phoenix-pnp/ThunderScope/Firmware/Artix7_PCIe/dso_top/dso_top.runs/design_1_xdma_0_0_synth_1/.vivado.begin.rst

<?xml version="1.0"?>
<ProcessHandle Version="1" Minor="0">
    <Process Command="vivado.bat" Owner="Aleksa" Host="DESKTOP-J72MK93" Pid="1696" HostCore="16" HostMemory="034270351360">
    </Process>
</ProcessHandle>
