phoenix-pnp/ThunderScope/Firmware/Artix7_PCIe/dso_top/dso_top.runs/impl_1/.init_design.begin.rst

<?xml version="1.0"?>
<ProcessHandle Version="1" Minor="0">
    <Process Command=".planAhead." Owner="Aleksa" Host="DESKTOP-J72MK93" Pid="4868">
    </Process>
</ProcessHandle>
