phoenix-pnp/ThunderScope/Hardware/The Next Generation/BUF802_Eval/BUF802_Eval.pdf

# +4V8 R¹²⁰

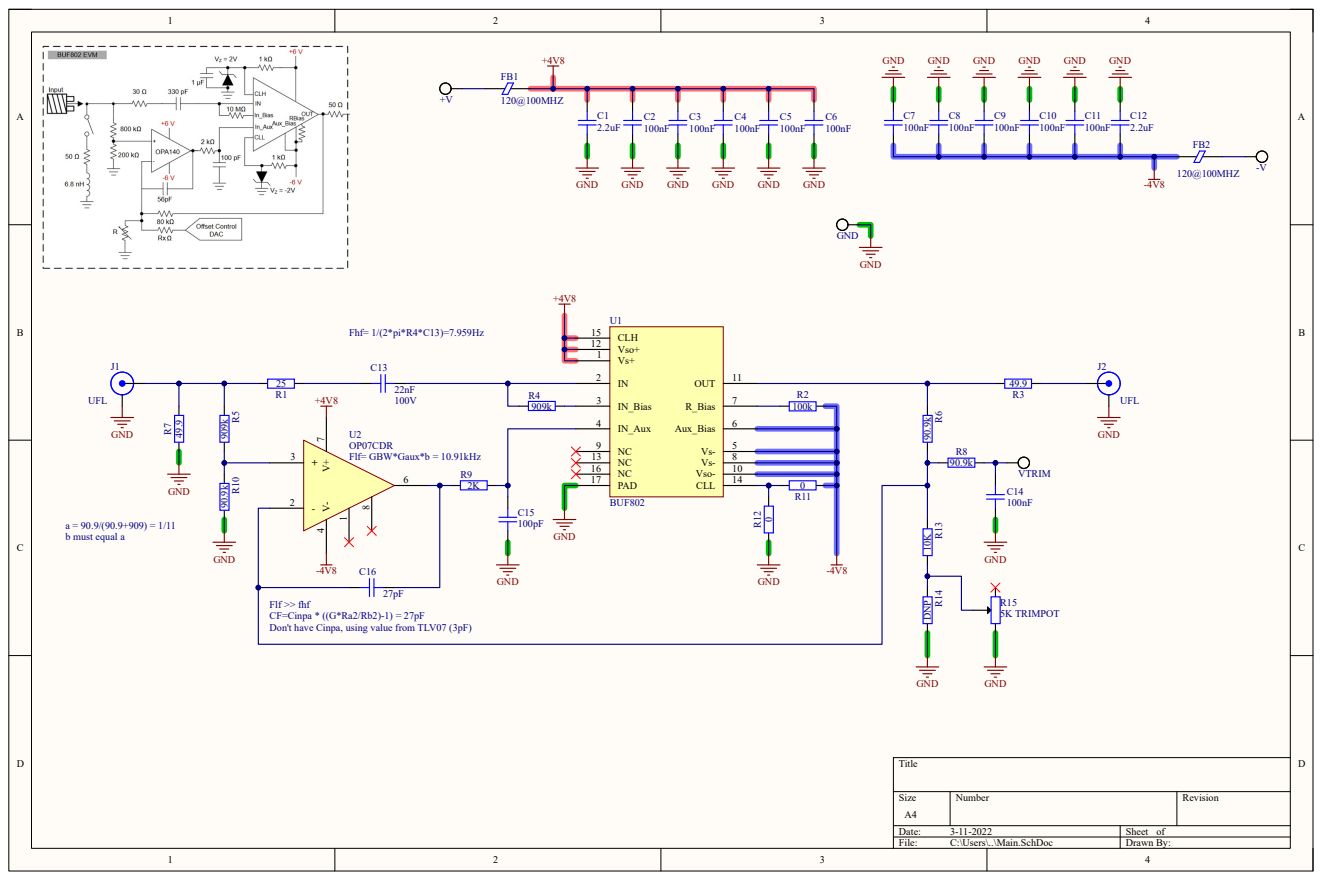
[picture p9: page 1]

Flf >> fhf
CF=Cinpa * ((G*Ra2/Rb2)-1) = 27pF
Don't have Cinpa, using value from TLV07 (3pF)
