phoenix-pnp/ThunderScope/(list of files, drawings)

Other design files:
Hardware/The Next Generation/BUF802_Eval/BUF802_Eval.PcbDoc
Hardware/The Next Generation/BUF802_Eval/BUF802_Eval.PrjPcb
Hardware/The Next Generation/BUF802_Eval/Main.SchDoc
Hardware/The Next Generation/Thunderscope_Rev1/ADC.SchDoc
Hardware/The Next Generation/Thunderscope_Rev1/Buffer.SchDoc
Hardware/The Next Generation/Thunderscope_Rev1/FE.SchDoc
Hardware/The Next Generation/Thunderscope_Rev1/FE_Channel.SchDoc
Hardware/The Next Generation/Thunderscope_Rev1/FPGA.SchDoc
Hardware/The Next Generation/Thunderscope_Rev1/Input.SchDoc
Hardware/The Next Generation/Thunderscope_Rev1/M2_KEY_M.SchDoc
Hardware/The Next Generation/Thunderscope_Rev1/Main.SchDoc
Hardware/The Next Generation/Thunderscope_Rev1/Managed/Sheets/FC1D1A13-1D8D-4C53-8666-9A4B6D32A5EC/CON_PCIe_X4.SchDoc
Hardware/The Next Generation/Thunderscope_Rev1/PGA.SchDoc
Hardware/The Next Generation/Thunderscope_Rev1/PLL.SchDoc
Hardware/The Next Generation/Thunderscope_Rev1/Thunderscope_Rev1.PrjPCB
