phoenix-pnp/ThunderScope/Software/waveview/scope_link/src/main.cpp

//
//  main.cpp
//
//  Created by Daniel Vasile on 2019-07-26.
//  Copyright © 2019 EEVengers. All rights reserved.
//

#include "EVTester.hpp"
#include "logger.hpp"
#include "controller.hpp"

#include "../lib/xptools/Socket.h"

// Forward Declarations
bool parseCli (std::string line);
void runCli();

// Variables
boost::lockfree::queue<buffer*, boost::lockfree::fixed_sized<false>> dataQueue_1{1000};
controller* controllerThread = NULL;


void parseCommandLineArgs(int argc, char** args) {
    if(argc > 1) {
        if(std::string(args[1]) == "--TestSinc" || std::string(args[1]) == "-s") {
            INFO << "Main:parseCommandLineArgs() - Testing Sinc Interpolation";
            TestSincInterpolation();
        } else if(std::string(args[1]) == "--testTrigger") {
            INFO << "Main:parseCommandLineArgs() - Testing Trigger Throughput";
            testTriggerThroughput();
        } else if(std::string(args[1]) == "-gl" || std::string(args[1]) == "--glscopeclient") {
			INFO << "Running tcp connection";

        } else if(std::string(args[1]) == "--PCIE") {
            INFO << "Running PCIE test";

            runPCIeTest();
        } else if(std::string(args[1]) == "--controller" || std::string(args[1]) == "-c") {
            parseCli("controller");
            runCli();
        } else {
            ERROR << "Invalid arguments.";
        }
    } else {
        ERROR << "Invalid arguments.";
    }

    return;
}

bool parseCli (std::string line)
{
    if (line.rfind("test", 0) == 0) {
        INFO << "Test";

    } else if ("template" == line.substr(0, line.find(' '))) {
        INFO << "Template";

//        // Useful for accepting arguments from a command
//        std::string nextArgument = line.substr(line.find(' ', line.find(' ') + 1),
//                                                   line.find(' ') + 1);

        // Get the reset of the line after the first argument
        std::string nextLine = line.substr(line.find(' ') + 1, line.length());
        parseCli(nextLine);

    } else if (line == "getch") {
        if (controllerThread != NULL ) {
            INFO << "Number of channels: " << (int)controllerThread->getCh();
        }

    } else if ("setch" == line.substr(0, line.find(' '))) {
        INFO << "setting channel mode";

        // Useful for accepting arguments from a command
        std::string nextArgument = line.substr(line.find(' ') + 1, line.length());
        if (nextArgument != "setch") {
            if (nextArgument == "1") {
                controllerThread->setCh(1);
            } else if (nextArgument == "2") {
                controllerThread->setCh(2);
            } else if (nextArgument == "4") {
                controllerThread->setCh(4);
            } else {
                ERROR << "Not a channel mode";
            }
        }

    } else if (line == "gettrig") {
        if (controllerThread != NULL ) {
            INFO << "Trigger channel: " << (int)controllerThread->getTriggerCh();
        }

    } else if ("settrig" == line.substr(0, line.find(' '))) {
        INFO << "setting trigger channel";

        // Useful for accepting arguments from a command
        std::string nextArgument = line.substr(line.find(' ') + 1, line.length());
        if (nextArgument != "settrig") {
            if (nextArgument == "1") {
                controllerThread->setTriggerCh(1);
            } else if (nextArgument == "2") {
                controllerThread->setTriggerCh(2);
            } else if (nextArgument == "3") {
                controllerThread->setTriggerCh(3);
            } else if (nextArgument == "4") {
                controllerThread->setTriggerCh(4);
            } else {
                ERROR << "Not a trigger channel";
            }
        }

    } else if (line == "getwin") {
        if (controllerThread != NULL ) {
            INFO << "Window Size: " << (int)controllerThread->getWindowSize();
        }

    } else if ("setwin" == line.substr(0, line.find(' '))) {
        if (controllerThread != NULL ) {
            INFO << "setting window size";

            // Useful for accepting arguments from a command
            std::string nextArgument = line.substr(line.find(' ') + 1, line.length());
            if (nextArgument != "setwin") {
                int32_t newWindowSize = stoi(nextArgument);
                controllerThread->setWindowSize(newWindowSize);
                INFO << "new window size: " << newWindowSize;
            }
        } else {
            ERROR << "No controller";
        }

    } else if (line == "getlevel") {
        if (controllerThread != NULL ) {
            INFO << "trigger level: " << (int)controllerThread->getLevel();
        }

    } else if ("setlevel" == line.substr(0, line.find(' '))) {
        if (controllerThread != NULL ) {
            INFO << "setting trigger level";

            // Useful for accepting arguments from a command
            std::string nextArgument = line.substr(line.find(' ') + 1, line.length());
            if (nextArgument != "setlevel") {
                int32_t newLevel = stoi(nextArgument);
                controllerThread->setLevel(newLevel);
                INFO << "new trigger level: " << newLevel;
            }
        } else {
            ERROR << "No controller";
        }
    } else if ("getmax" == line.substr(0, line.find(' '))) {
        INFO << "getting max value";

        int8_t maxValue = 0;
        uint64_t maxPos = 0;

        // Useful for accepting arguments from a command
        std::string nextArgument = line.substr(line.find(' ') + 1, line.length());
        if (nextArgument != "getmax") {
            if (nextArgument == "1") {
                controllerThread->getMax(1, &maxValue, &maxPos);
                INFO << "Max Value: " << (int)maxValue << " at position: " << maxPos;
            } else if (nextArgument == "2") {
                controllerThread->getMax(2, &maxValue, &maxPos);
                INFO << "Max Value: " << maxValue << " at position: " << maxPos;
            } else if (nextArgument == "3") {
                controllerThread->getMax(3, &maxValue, &maxPos);
                INFO << "Max Value: " << maxValue << " at position: " << maxPos;
            } else if (nextArgument == "4") {
                controllerThread->getMax(3, &maxValue, &maxPos);
                INFO << "Max Value: " << maxValue << " at position: " << maxPos;
            } else {
                ERROR << "Not a trigger channel";
            }
        } else {
            controllerThread->getMax(1, &maxValue, &maxPos);
            INFO << "Max Value: " << (int)maxValue << " at position: " << maxPos;
        }


    } else if ("getmin" == line.substr(0, line.find(' '))) {
        INFO << "getting min value";

        // Useful for accepting arguments from a command
        std::string nextArgument = line.substr(line.find(' ') + 1, line.length());
        if (nextArgument != "getmin") {
            int8_t minValue = 0;
            uint64_t minPos = 0;
            if (nextArgument == "1") {
                controllerThread->getMin(1, &minValue, &minPos);
                INFO << "Min Value: " << (int)minValue << " at position: " << minPos;
            } else if (nextArgument == "2") {
                controllerThread->getMin(2, &minValue, &minPos);
                INFO << "Min Value: " << minValue << " at position: " << minPos;
            } else if (nextArgument == "3") {
                controllerThread->getMin(3, &minValue, &minPos);
                INFO << "Min Value: " << minValue << " at position: " << minPos;
            } else if (nextArgument == "4") {
                controllerThread->getMin(3, &minValue, &minPos);
                INFO << "Min Value: " << minValue << " at position: " << minPos;
            } else {
                ERROR << "Not a trigger channel";
            }
        }

    } else if (line == "controller") {
        if (controllerThread == NULL ) {
            controllerThread = new controller(&dataQueue_1);
        }

    } else if (line == "pause") {
        if (controllerThread != NULL ) {
            controllerThread->controllerPause();
        }

    } else if (line == "unpause") {
        if (controllerThread != NULL ) {
            controllerThread->controllerUnPause();
        }

    } else if (line == "reprocess") {
        if (controllerThread != NULL ) {
            controllerThread->reProcess();
        }

    } else if (line == "flush") {
        if (controllerThread != NULL ) {
            controllerThread->controllerFlush();
        }

    } else if (line == "getedgetype") {
        if (controllerThread != NULL ) {
            if (controllerThread->getEdgeType() == true) {
                INFO << "Rising edge triggering";
            } else {
                INFO << "Falling edge triggering";
            }
        }

    } else if (line == "setrising") {
        if (controllerThread != NULL ) {
            controllerThread->setRising();
        }

    } else if (line == "setfalling") {
        if (controllerThread != NULL ) {
            controllerThread->setFalling();
        }

    } else if (line == "getdata") {
        if (controllerThread != NULL ) {
            controllerThread->getData();
            INFO << "you need to load in some data to get data";
        }

    } else if (line == "getper") {
        if (controllerThread != NULL ) {
            INFO << "Persistance Size: " << (int)controllerThread->getPerSize();
        }

    } else if ("setper" == line.substr(0, line.find(' '))) {
        if (controllerThread != NULL ) {
            INFO << "setting persistance size";

            // Useful for accepting arguments from a command
            std::string nextArgument = line.substr(line.find(' ') + 1, line.length());
            if (nextArgument != "setper") {
                int32_t newPer = stoi(nextArgument);
                controllerThread->setPerSize(newPer);
                INFO << "new persistance size: " << newPer;
            }
        } else {
            ERROR << "No controller";
        }

    } else if ("setmath1" == line.substr(0, line.find(' '))) {
        if (controllerThread != NULL ) {
            INFO << "setting math channel 1";

            // Useful for accepting arguments from a command
            std::string nextArgument = line.substr(line.find(' ') + 1, line.length());
            if (nextArgument != "setmath1") {
                int32_t newMathCh = stoi(nextArgument);
                controllerThread->setMathCh_1(newMathCh);
                INFO << "new math channel 1: " << newMathCh;
            }
        } else {
            ERROR << "No controller";
        }

    } else if ("setmath2" == line.substr(0, line.find(' '))) {
        if (controllerThread != NULL ) {
            INFO << "setting math channel 2";

            // Useful for accepting arguments from a command
            std::string nextArgument = line.substr(line.find(' ') + 1, line.length());
            if (nextArgument != "setmath2") {
                int32_t newMathCh = stoi(nextArgument);
                controllerThread->setMathCh_2(newMathCh);
                INFO << "new math channel 2: " << newMathCh;
            }
        } else {
            ERROR << "No controller";
        }

    } else if ("setmathsign" == line.substr(0, line.find(' '))) {
        if (controllerThread != NULL ) {
            INFO << "setting math channel 2";

            // Useful for accepting arguments from a command
            std::string nextArgument = line.substr(line.find(' ') + 1, line.length());
            if (nextArgument == "add") {
                controllerThread->setMathSign(true);
                INFO << "Math sign addition";
            } else if (nextArgument == "sub") {
                controllerThread->setMathSign(false);
                INFO << "Math sign subtraction";
            }
        } else {
            ERROR << "No controller";
        }

    } else if ("datafile" == line.substr(0, line.find(' '))) {
        INFO << "Adding data from file to the pipeline";

        std::string nextArgument = line.substr(line.find(' ') + 1, line.length());
        if (nextArgument != "data") {

            nextArgument = "./test/" + nextArgument;
            char* filename = (char*)malloc(nextArgument.size() + 1);
            std::strcpy(filename, nextArgument.c_str());
            inputFile = filename;
            loadFromFile(filename, &dataQueue_1);
            free(filename);
        } else {
            ERROR << "must provide file";
        }

    } else if ("data" == line.substr(0, line.find(' '))) {
        INFO << "Adding data to the pipeline";

        char filename[] = "./test/test1.csv";
        inputFile = filename;
        loadFromFile(filename, &dataQueue_1);

    } else if (line == "delete" || line == "exit") {
        if (controllerThread != NULL ) {
            delete controllerThread;
            controllerThread = NULL;
        }

        if (line == "exit") {
            return false;
        }
    } else {
        ERROR << "Invalid Command";
        ERROR << "Commands are:";
        ERROR << "controller";
        ERROR << "unpause";
        ERROR << "data";
        ERROR << "datafile <csv file in scope_link/test/>";
        ERROR << "getch";
        ERROR << "setch <# of channels: 1, 2 or 4>";
        ERROR << "gettrig";
        ERROR << "settrig <channel to trig on: 1, 2, 3 or 4>";
        ERROR << "getedgetype";
        ERROR << "setrising";
        ERROR << "setfalling";
        ERROR << "getlevel";
        ERROR << "setlevel <voltage level>";
        ERROR << "getwin";
        ERROR << "setwin";
        ERROR << "flush";
        ERROR << "setmath1";
        ERROR << "setmath2";
        ERROR << "setmathsign";
        ERROR << "getdata";
        ERROR << "exit";
    }
    return true;
}

void runCli() {

    bool parseThings = true;
    while(parseThings) {
        INFO << "Input a command\n>";
        std::string line;
        std::getline(std::cin, line);

        parseThings = parseCli(line);
    }

    if(controllerThread != NULL)
        delete controllerThread;
}


std::string g_model;
std::string g_serial;
std::string g_fwver;

//PicoScopeType g_pico_type;
int16_t g_hScope = 0;
size_t g_numChannels = 0;

extern Socket g_scpiSocket;
extern Socket g_dataSocket;

uint16_t scpi_port = 5025;
uint16_t waveform_port = 5026;

int main(int argc, char** args)
{
    INFO << "Program Started";

	//Configure the data plane socket
	g_dataSocket.Bind(waveform_port);
	g_dataSocket.Listen();

	//Launch the control plane socket server
	g_scpiSocket.Bind(scpi_port);
	g_scpiSocket.Listen();
//	ScpiServerThread();

    if (argc > 1) {
        parseCommandLineArgs(argc, args);
    } else {
        INFO << "Running in CLI mode";
        runCli();
    }

    return 0;
}
