phoenix-pnp/ThunderScope/Firmware/Artix7_PCIe/dso_top/dso_top.runs/synth_1/.Xil/dso_top_propImpl.xdc

set_property SRC_FILE_INFO {cfile:c:/Users/Aleksa/Documents/FPGA_Dev/Artix7_PCIe/dso_top/dso_top.srcs/sources_1/bd/design_1/ip/design_1_xdma_0_0/design_1_xdma_0_0/design_1_xdma_0_0_in_context.xdc rfile:../../../dso_top.srcs/sources_1/bd/design_1/ip/design_1_xdma_0_0/design_1_xdma_0_0/design_1_xdma_0_0_in_context.xdc id:1 order:EARLY scoped_inst:design_1_i/xdma_0} [current_design]
set_property SRC_FILE_INFO {cfile:c:/Users/Aleksa/Documents/FPGA_Dev/Artix7_PCIe/dso_top/dso_top.srcs/sources_1/bd/design_1/ip/design_1_util_ds_buf_0_0/design_1_util_ds_buf_0_0/design_1_util_ds_buf_0_0_in_context.xdc rfile:../../../dso_top.srcs/sources_1/bd/design_1/ip/design_1_util_ds_buf_0_0/design_1_util_ds_buf_0_0/design_1_util_ds_buf_0_0_in_context.xdc id:2 order:EARLY scoped_inst:design_1_i/util_ds_buf_0} [current_design]
set_property SRC_FILE_INFO {cfile:c:/Users/Aleksa/Documents/FPGA_Dev/Artix7_PCIe/dso_top/dso_top.srcs/sources_1/bd/design_1/ip/design_1_axi_bram_ctrl_0_1/design_1_axi_bram_ctrl_0_1/design_1_axi_bram_ctrl_0_1_in_context.xdc rfile:../../../dso_top.srcs/sources_1/bd/design_1/ip/design_1_axi_bram_ctrl_0_1/design_1_axi_bram_ctrl_0_1/design_1_axi_bram_ctrl_0_1_in_context.xdc id:3 order:EARLY scoped_inst:design_1_i/axi_bram_ctrl_0} [current_design]
set_property SRC_FILE_INFO {cfile:C:/Users/Aleksa/Documents/FPGA_Dev/Artix7_PCIe/dso_top/dso_top.runs/synth_1/.Xil/Vivado-7916-DESKTOP-J72MK93/clk_wiz_0/clk_wiz_0/clk_wiz_0_in_context.xdc rfile:Vivado-7916-DESKTOP-J72MK93/clk_wiz_0/clk_wiz_0/clk_wiz_0_in_context.xdc id:4 order:EARLY scoped_inst:serdes/serdes_clocking} [current_design]
set_property SRC_FILE_INFO {cfile:C:/Users/Aleksa/Documents/FPGA_Dev/Artix7_PCIe/dso_top/dso_top.srcs/constrs_1/imports/new/module_io.xdc rfile:../../../dso_top.srcs/constrs_1/imports/new/module_io.xdc id:5} [current_design]
set_property SRC_FILE_INFO {cfile:C:/Users/Aleksa/Documents/FPGA_Dev/Artix7_PCIe/dso_top/dso_top.srcs/constrs_1/new/timing.xdc rfile:../../../dso_top.srcs/constrs_1/new/timing.xdc id:6} [current_design]
current_instance design_1_i/xdma_0
set_property src_info {type:SCOPED_XDC file:1 line:2 export:INPUT save:INPUT read:READ} [current_design]
create_clock -period 8.000 [get_ports {}]
current_instance
current_instance design_1_i/util_ds_buf_0
set_property src_info {type:SCOPED_XDC file:2 line:2 export:INPUT save:INPUT read:READ} [current_design]
create_clock -period 10.000 [get_ports {}]
set_property src_info {type:SCOPED_XDC file:2 line:4 export:INPUT save:INPUT read:READ} [current_design]
create_generated_clock -source [get_ports IBUF_DS_P[0]] -edges {1 2 3} -edge_shift {0.000 5.000 10.000} [get_ports {}]
current_instance
current_instance design_1_i/axi_bram_ctrl_0
set_property src_info {type:SCOPED_XDC file:3 line:2 export:INPUT save:INPUT read:READ} [current_design]
create_clock -period 8.000 [get_ports {}]
current_instance
current_instance serdes/serdes_clocking
set_property src_info {type:SCOPED_XDC file:4 line:1 export:INPUT save:INPUT read:READ} [current_design]
create_clock -period 2.000 [get_ports -no_traverse {}]
set_property src_info {type:SCOPED_XDC file:4 line:4 export:INPUT save:INPUT read:READ} [current_design]
create_generated_clock -source [get_ports clk_in1_p] -edges {1 2 3} -edge_shift {0.500 0.500 0.500} [get_ports {}]
set_property src_info {type:SCOPED_XDC file:4 line:6 export:INPUT save:INPUT read:READ} [current_design]
create_generated_clock -source [get_ports clk_in1_p] -edges {1 2 3} -edge_shift {1.250 2.750 4.250} [get_ports {}]
set_property src_info {type:SCOPED_XDC file:4 line:8 export:INPUT save:INPUT read:READ} [current_design]
create_generated_clock -source [get_ports clk_in1_p] -edges {1 2 3} -edge_shift {2.000 5.000 8.000} [get_ports {}]
current_instance
set_property src_info {type:XDC file:5 line:1 export:INPUT save:INPUT read:READ} [current_design]
set_property -dict {PACKAGE_PIN Y22 IOSTANDARD LVCMOS33} [get_ports {led[0]}]
set_property src_info {type:XDC file:5 line:2 export:INPUT save:INPUT read:READ} [current_design]
set_property -dict {PACKAGE_PIN T21 IOSTANDARD LVCMOS33} [get_ports {led[1]}]
set_property src_info {type:XDC file:5 line:3 export:INPUT save:INPUT read:READ} [current_design]
set_property -dict {PACKAGE_PIN U21 IOSTANDARD LVCMOS33} [get_ports {led[2]}]
set_property src_info {type:XDC file:5 line:4 export:INPUT save:INPUT read:READ} [current_design]
set_property -dict {PACKAGE_PIN R17 IOSTANDARD LVCMOS33} [get_ports {led[3]}]
set_property src_info {type:XDC file:5 line:6 export:INPUT save:INPUT read:READ} [current_design]
set_property -dict {PACKAGE_PIN K22 IOSTANDARD LVCMOS33} [get_ports pga_sdio]
set_property src_info {type:XDC file:5 line:7 export:INPUT save:INPUT read:READ} [current_design]
set_property -dict {PACKAGE_PIN K21 IOSTANDARD LVCMOS33} [get_ports pga_sclk]
set_property src_info {type:XDC file:5 line:9 export:INPUT save:INPUT read:READ} [current_design]
set_property -dict {PACKAGE_PIN G20 IOSTANDARD LVCMOS33} [get_ports {pga_cs[0]}]
set_property src_info {type:XDC file:5 line:10 export:INPUT save:INPUT read:READ} [current_design]
set_property -dict {PACKAGE_PIN K18 IOSTANDARD LVCMOS33} [get_ports {pga_cs[1]}]
set_property src_info {type:XDC file:5 line:11 export:INPUT save:INPUT read:READ} [current_design]
set_property -dict {PACKAGE_PIN L20 IOSTANDARD LVCMOS33} [get_ports {pga_cs[2]}]
set_property src_info {type:XDC file:5 line:12 export:INPUT save:INPUT read:READ} [current_design]
set_property -dict {PACKAGE_PIN L21 IOSTANDARD LVCMOS33} [get_ports {pga_cs[3]}]
set_property src_info {type:XDC file:5 line:14 export:INPUT save:INPUT read:READ} [current_design]
set_property -dict {PACKAGE_PIN H20 IOSTANDARD LVCMOS33} [get_ports {atten[0]}]
set_property src_info {type:XDC file:5 line:15 export:INPUT save:INPUT read:READ} [current_design]
set_property -dict {PACKAGE_PIN K19 IOSTANDARD LVCMOS33} [get_ports {atten[1]}]
set_property src_info {type:XDC file:5 line:16 export:INPUT save:INPUT read:READ} [current_design]
set_property -dict {PACKAGE_PIN J19 IOSTANDARD LVCMOS33} [get_ports {atten[2]}]
set_property src_info {type:XDC file:5 line:17 export:INPUT save:INPUT read:READ} [current_design]
set_property -dict {PACKAGE_PIN M21 IOSTANDARD LVCMOS33} [get_ports {atten[3]}]
set_property src_info {type:XDC file:5 line:19 export:INPUT save:INPUT read:READ} [current_design]
set_property -dict {PACKAGE_PIN H22 IOSTANDARD LVCMOS33} [get_ports {dc_cpl[0]}]
set_property src_info {type:XDC file:5 line:20 export:INPUT save:INPUT read:READ} [current_design]
set_property -dict {PACKAGE_PIN L19 IOSTANDARD LVCMOS33} [get_ports {dc_cpl[1]}]
set_property src_info {type:XDC file:5 line:21 export:INPUT save:INPUT read:READ} [current_design]
set_property -dict {PACKAGE_PIN H19 IOSTANDARD LVCMOS33} [get_ports {dc_cpl[2]}]
set_property src_info {type:XDC file:5 line:22 export:INPUT save:INPUT read:READ} [current_design]
set_property -dict {PACKAGE_PIN N20 IOSTANDARD LVCMOS33} [get_ports {dc_cpl[3]}]
set_property src_info {type:XDC file:5 line:24 export:INPUT save:INPUT read:READ} [current_design]
set_property -dict {PACKAGE_PIN J22 IOSTANDARD LVCMOS33} [get_ports probe_comp]
set_property src_info {type:XDC file:5 line:26 export:INPUT save:INPUT read:READ} [current_design]
set_property -dict {PACKAGE_PIN L16 IOSTANDARD LVCMOS33} [get_ports adc_sclk]
set_property src_info {type:XDC file:5 line:27 export:INPUT save:INPUT read:READ} [current_design]
set_property -dict {PACKAGE_PIN K16 IOSTANDARD LVCMOS33} [get_ports adc_sdata]
set_property src_info {type:XDC file:5 line:29 export:INPUT save:INPUT read:READ} [current_design]
set_property -dict {PACKAGE_PIN K13 IOSTANDARD LVCMOS33} [get_ports fe_pg]
set_property src_info {type:XDC file:5 line:31 export:INPUT save:INPUT read:READ} [current_design]
set_property -dict {PACKAGE_PIN K14 IOSTANDARD LVCMOS33} [get_ports osc_oe]
set_property src_info {type:XDC file:5 line:33 export:INPUT save:INPUT read:READ} [current_design]
set_property -dict {PACKAGE_PIN J20 IOSTANDARD LVCMOS33} [get_ports acq_en]
set_property src_info {type:XDC file:5 line:35 export:INPUT save:INPUT read:READ} [current_design]
set_property -dict {PACKAGE_PIN J21 IOSTANDARD LVCMOS33} [get_ports fe_en]
set_property src_info {type:XDC file:5 line:37 export:INPUT save:INPUT read:READ} [current_design]
set_property -dict {PACKAGE_PIN J14 IOSTANDARD LVCMOS33} [get_ports i2c_sda]
set_property src_info {type:XDC file:5 line:38 export:INPUT save:INPUT read:READ} [current_design]
set_property -dict {PACKAGE_PIN H14 IOSTANDARD LVCMOS33} [get_ports i2c_scl]
set_property src_info {type:XDC file:5 line:40 export:INPUT save:INPUT read:READ} [current_design]
set_property -dict {PACKAGE_PIN N19 IOSTANDARD LVCMOS33} [get_ports adc_pd]
set_property src_info {type:XDC file:5 line:42 export:INPUT save:INPUT read:READ} [current_design]
set_property -dict {PACKAGE_PIN N18 IOSTANDARD LVCMOS33} [get_ports adc_rstn]
set_property src_info {type:XDC file:5 line:44 export:INPUT save:INPUT read:READ} [current_design]
set_property -dict {PACKAGE_PIN M18 IOSTANDARD LVCMOS33} [get_ports adc_cs]
set_property src_info {type:XDC file:5 line:46 export:INPUT save:INPUT read:READ} [current_design]
set_property -dict {PACKAGE_PIN L18 IOSTANDARD LVCMOS33} [get_ports adc_pg]
set_property src_info {type:XDC file:5 line:52 export:INPUT save:INPUT read:READ} [current_design]
set_property -dict {PACKAGE_PIN C18 IOSTANDARD LVDS_25 DIFF_TERM 1} [get_ports adc_lclk_p]
set_property src_info {type:XDC file:5 line:53 export:INPUT save:INPUT read:READ} [current_design]
set_property -dict {PACKAGE_PIN C19 IOSTANDARD LVDS_25 DIFF_TERM 1} [get_ports adc_lclk_n]
set_property src_info {type:XDC file:5 line:55 export:INPUT save:INPUT read:READ} [current_design]
set_property -dict {PACKAGE_PIN D17 IOSTANDARD LVDS_25 DIFF_TERM 1} [get_ports adc_fclk_p]
set_property src_info {type:XDC file:5 line:56 export:INPUT save:INPUT read:READ} [current_design]
set_property -dict {PACKAGE_PIN C17 IOSTANDARD LVDS_25 DIFF_TERM 1} [get_ports adc_fclk_n]
set_property src_info {type:XDC file:5 line:59 export:INPUT save:INPUT read:READ} [current_design]
set_property -dict {PACKAGE_PIN A15 IOSTANDARD LVDS_25 DIFF_TERM 1} [get_ports {adc_data_p[0]}]
set_property src_info {type:XDC file:5 line:60 export:INPUT save:INPUT read:READ} [current_design]
set_property -dict {PACKAGE_PIN A16 IOSTANDARD LVDS_25 DIFF_TERM 1} [get_ports {adc_data_n[0]}]
set_property src_info {type:XDC file:5 line:63 export:INPUT save:INPUT read:READ} [current_design]
set_property -dict {PACKAGE_PIN B15 IOSTANDARD LVDS_25 DIFF_TERM 1} [get_ports {adc_data_p[1]}]
set_property src_info {type:XDC file:5 line:64 export:INPUT save:INPUT read:READ} [current_design]
set_property -dict {PACKAGE_PIN B16 IOSTANDARD LVDS_25 DIFF_TERM 1} [get_ports {adc_data_n[1]}]
set_property src_info {type:XDC file:5 line:67 export:INPUT save:INPUT read:READ} [current_design]
set_property -dict {PACKAGE_PIN B17 IOSTANDARD LVDS_25 DIFF_TERM 1} [get_ports {adc_data_p[2]}]
set_property src_info {type:XDC file:5 line:68 export:INPUT save:INPUT read:READ} [current_design]
set_property -dict {PACKAGE_PIN B18 IOSTANDARD LVDS_25 DIFF_TERM 1} [get_ports {adc_data_n[2]}]
set_property src_info {type:XDC file:5 line:71 export:INPUT save:INPUT read:READ} [current_design]
set_property -dict {PACKAGE_PIN A13 IOSTANDARD LVDS_25 DIFF_TERM 1} [get_ports {adc_data_p[3]}]
set_property src_info {type:XDC file:5 line:72 export:INPUT save:INPUT read:READ} [current_design]
set_property -dict {PACKAGE_PIN A14 IOSTANDARD LVDS_25 DIFF_TERM 1} [get_ports {adc_data_n[3]}]
set_property src_info {type:XDC file:5 line:75 export:INPUT save:INPUT read:READ} [current_design]
set_property -dict {PACKAGE_PIN F16 IOSTANDARD LVDS_25 DIFF_TERM 1} [get_ports {adc_data_p[4]}]
set_property src_info {type:XDC file:5 line:76 export:INPUT save:INPUT read:READ} [current_design]
set_property -dict {PACKAGE_PIN E17 IOSTANDARD LVDS_25 DIFF_TERM 1} [get_ports {adc_data_n[4]}]
set_property src_info {type:XDC file:5 line:79 export:INPUT save:INPUT read:READ} [current_design]
set_property -dict {PACKAGE_PIN D14 IOSTANDARD LVDS_25 DIFF_TERM 1} [get_ports {adc_data_p[5]}]
set_property src_info {type:XDC file:5 line:80 export:INPUT save:INPUT read:READ} [current_design]
set_property -dict {PACKAGE_PIN D15 IOSTANDARD LVDS_25 DIFF_TERM 1} [get_ports {adc_data_n[5]}]
set_property src_info {type:XDC file:5 line:83 export:INPUT save:INPUT read:READ} [current_design]
set_property -dict {PACKAGE_PIN E13 IOSTANDARD LVDS_25 DIFF_TERM 1} [get_ports {adc_data_p[6]}]
set_property src_info {type:XDC file:5 line:84 export:INPUT save:INPUT read:READ} [current_design]
set_property -dict {PACKAGE_PIN E14 IOSTANDARD LVDS_25 DIFF_TERM 1} [get_ports {adc_data_n[6]}]
set_property src_info {type:XDC file:5 line:87 export:INPUT save:INPUT read:READ} [current_design]
set_property -dict {PACKAGE_PIN F13 IOSTANDARD LVDS_25 DIFF_TERM 1} [get_ports {adc_data_p[7]}]
set_property src_info {type:XDC file:5 line:88 export:INPUT save:INPUT read:READ} [current_design]
set_property -dict {PACKAGE_PIN F14 IOSTANDARD LVDS_25 DIFF_TERM 1} [get_ports {adc_data_n[7]}]
set_property src_info {type:XDC file:5 line:95 export:INPUT save:INPUT read:READ} [current_design]
set_property LOC GTPE2_CHANNEL_X0Y7 [get_cells {design_1_i/PCIe/xdma_0/inst/design_1_xdma_0_0_pcie2_to_pcie3_wrapper_i/pcie2_ip_i/inst/inst/gt_top_i/pipe_wrapper_i/pipe_lane[0].gt_wrapper_i/gtp_channel.gtpe2_channel_i}]
set_property src_info {type:XDC file:5 line:96 export:INPUT save:INPUT read:READ} [current_design]
set_property PACKAGE_PIN C9 [get_ports {pcie_mgt_rxn[0]}]
set_property src_info {type:XDC file:5 line:97 export:INPUT save:INPUT read:READ} [current_design]
set_property PACKAGE_PIN D9 [get_ports {pcie_mgt_rxp[0]}]
set_property src_info {type:XDC file:5 line:98 export:INPUT save:INPUT read:READ} [current_design]
set_property PACKAGE_PIN C7 [get_ports {pcie_mgt_txn[0]}]
set_property src_info {type:XDC file:5 line:99 export:INPUT save:INPUT read:READ} [current_design]
set_property PACKAGE_PIN D7 [get_ports {pcie_mgt_txp[0]}]
set_property src_info {type:XDC file:5 line:102 export:INPUT save:INPUT read:READ} [current_design]
set_property LOC GTPE2_CHANNEL_X0Y6 [get_cells {design_1_i/PCIe/xdma_0/inst/design_1_xdma_0_0_pcie2_to_pcie3_wrapper_i/pcie2_ip_i/inst/inst/gt_top_i/pipe_wrapper_i/pipe_lane[1].gt_wrapper_i/gtp_channel.gtpe2_channel_i}]
set_property src_info {type:XDC file:5 line:103 export:INPUT save:INPUT read:READ} [current_design]
set_property PACKAGE_PIN A10 [get_ports {pcie_mgt_rxn[1]}]
set_property src_info {type:XDC file:5 line:104 export:INPUT save:INPUT read:READ} [current_design]
set_property PACKAGE_PIN B10 [get_ports {pcie_mgt_rxp[1]}]
set_property src_info {type:XDC file:5 line:105 export:INPUT save:INPUT read:READ} [current_design]
set_property PACKAGE_PIN A6 [get_ports {pcie_mgt_txn[1]}]
set_property src_info {type:XDC file:5 line:106 export:INPUT save:INPUT read:READ} [current_design]
set_property PACKAGE_PIN B6 [get_ports {pcie_mgt_txp[1]}]
set_property src_info {type:XDC file:5 line:109 export:INPUT save:INPUT read:READ} [current_design]
set_property LOC GTPE2_CHANNEL_X0Y5 [get_cells {design_1_i/PCIe/xdma_0/inst/design_1_xdma_0_0_pcie2_to_pcie3_wrapper_i/pcie2_ip_i/inst/inst/gt_top_i/pipe_wrapper_i/pipe_lane[2].gt_wrapper_i/gtp_channel.gtpe2_channel_i}]
set_property src_info {type:XDC file:5 line:110 export:INPUT save:INPUT read:READ} [current_design]
set_property PACKAGE_PIN C11 [get_ports {pcie_mgt_rxn[2]}]
set_property src_info {type:XDC file:5 line:111 export:INPUT save:INPUT read:READ} [current_design]
set_property PACKAGE_PIN D11 [get_ports {pcie_mgt_rxp[2]}]
set_property src_info {type:XDC file:5 line:112 export:INPUT save:INPUT read:READ} [current_design]
set_property PACKAGE_PIN C5 [get_ports {pcie_mgt_txn[2]}]
set_property src_info {type:XDC file:5 line:113 export:INPUT save:INPUT read:READ} [current_design]
set_property PACKAGE_PIN D5 [get_ports {pcie_mgt_txp[2]}]
set_property src_info {type:XDC file:5 line:116 export:INPUT save:INPUT read:READ} [current_design]
set_property LOC GTPE2_CHANNEL_X0Y4 [get_cells {design_1_i/PCIe/xdma_0/inst/design_1_xdma_0_0_pcie2_to_pcie3_wrapper_i/pcie2_ip_i/inst/inst/gt_top_i/pipe_wrapper_i/pipe_lane[3].gt_wrapper_i/gtp_channel.gtpe2_channel_i}]
set_property src_info {type:XDC file:5 line:117 export:INPUT save:INPUT read:READ} [current_design]
set_property PACKAGE_PIN A8 [get_ports {pcie_mgt_rxn[3]}]
set_property src_info {type:XDC file:5 line:118 export:INPUT save:INPUT read:READ} [current_design]
set_property PACKAGE_PIN B8 [get_ports {pcie_mgt_rxp[3]}]
set_property src_info {type:XDC file:5 line:119 export:INPUT save:INPUT read:READ} [current_design]
set_property PACKAGE_PIN A4 [get_ports {pcie_mgt_txn[3]}]
set_property src_info {type:XDC file:5 line:120 export:INPUT save:INPUT read:READ} [current_design]
set_property PACKAGE_PIN B4 [get_ports {pcie_mgt_txp[3]}]
set_property src_info {type:XDC file:5 line:123 export:INPUT save:INPUT read:READ} [current_design]
set_property PACKAGE_PIN F10 [get_ports {pcie_clk_p[0]}]
set_property src_info {type:XDC file:5 line:124 export:INPUT save:INPUT read:READ} [current_design]
set_property PACKAGE_PIN E10 [get_ports {pcie_clk_n[0]}]
set_property src_info {type:XDC file:5 line:127 export:INPUT save:INPUT read:READ} [current_design]
set_property -dict {PACKAGE_PIN V14 IOSTANDARD LVCMOS33} [get_ports pcie_perstn]
set_property src_info {type:XDC file:6 line:3 export:INPUT save:INPUT read:READ} [current_design]
set_clock_groups -asynchronous -group [get_clocks {userclk2}] -group [get_clocks {clk_out2_clk_wiz_0}]
