phoenix-pnp/ThunderScope/Firmware/Artix7_PCIe/dso_top/dso_top.runs/design_1_xdma_0_0_synth_1/.Xil/design_1_xdma_0_0_propImpl.xdc

set_property SRC_FILE_INFO {cfile:c:/Users/Aleksa/Documents/FPGA_Dev/Artix7_PCIe/dso_top/dso_top.srcs/sources_1/bd/design_1/ip/design_1_xdma_0_0/ip_0/source/design_1_xdma_0_0_pcie2_ip-PCIE_X0Y0.xdc rfile:../../../dso_top.srcs/sources_1/bd/design_1/ip/design_1_xdma_0_0/ip_0/source/design_1_xdma_0_0_pcie2_ip-PCIE_X0Y0.xdc id:1 order:EARLY scoped_inst:inst/design_1_xdma_0_0_pcie2_to_pcie3_wrapper_i/pcie2_ip_i/inst} [current_design]
current_instance inst/design_1_xdma_0_0_pcie2_to_pcie3_wrapper_i/pcie2_ip_i/inst
set_property src_info {type:SCOPED_XDC file:1 line:94 export:INPUT save:INPUT read:READ} [current_design]
set_property LOC GTPE2_CHANNEL_X0Y7 [get_cells {inst/gt_top_i/pipe_wrapper_i/pipe_lane[0].gt_wrapper_i/gtp_channel.gtpe2_channel_i}]
set_property src_info {type:SCOPED_XDC file:1 line:96 export:INPUT save:INPUT read:READ} [current_design]
set_property LOC GTPE2_CHANNEL_X0Y6 [get_cells {inst/gt_top_i/pipe_wrapper_i/pipe_lane[1].gt_wrapper_i/gtp_channel.gtpe2_channel_i}]
set_property src_info {type:SCOPED_XDC file:1 line:98 export:INPUT save:INPUT read:READ} [current_design]
set_property LOC GTPE2_CHANNEL_X0Y5 [get_cells {inst/gt_top_i/pipe_wrapper_i/pipe_lane[2].gt_wrapper_i/gtp_channel.gtpe2_channel_i}]
set_property src_info {type:SCOPED_XDC file:1 line:100 export:INPUT save:INPUT read:READ} [current_design]
set_property LOC GTPE2_CHANNEL_X0Y4 [get_cells {inst/gt_top_i/pipe_wrapper_i/pipe_lane[3].gt_wrapper_i/gtp_channel.gtpe2_channel_i}]
set_property src_info {type:SCOPED_XDC file:1 line:103 export:INPUT save:INPUT read:READ} [current_design]
set_property LOC GTPE2_COMMON_X0Y1 [get_cells {inst/gt_top_i/pipe_wrapper_i/pipe_lane[0].pipe_quad.gt_common_enabled.gt_common_int.gt_common_i/qpll_wrapper_i/gtp_common.gtpe2_common_i}]
set_property src_info {type:SCOPED_XDC file:1 line:110 export:INPUT save:INPUT read:READ} [current_design]
set_property LOC PCIE_X0Y0 [get_cells inst/pcie_top_i/pcie_7x_i/pcie_block_i]
set_property src_info {type:SCOPED_XDC file:1 line:115 export:INPUT save:INPUT read:READ} [current_design]
set_property LOC RAMB36_X2Y36 [get_cells {inst/pcie_top_i/pcie_7x_i/pcie_bram_top/pcie_brams_rx/brams[3].ram/use_tdp.ramb36/genblk*.bram36_tdp_bl.bram36_tdp_bl}]
set_property src_info {type:SCOPED_XDC file:1 line:116 export:INPUT save:INPUT read:READ} [current_design]
set_property LOC RAMB36_X1Y37 [get_cells {inst/pcie_top_i/pcie_7x_i/pcie_bram_top/pcie_brams_rx/brams[2].ram/use_tdp.ramb36/genblk*.bram36_tdp_bl.bram36_tdp_bl}]
set_property src_info {type:SCOPED_XDC file:1 line:117 export:INPUT save:INPUT read:READ} [current_design]
set_property LOC RAMB36_X1Y36 [get_cells {inst/pcie_top_i/pcie_7x_i/pcie_bram_top/pcie_brams_rx/brams[1].ram/use_tdp.ramb36/genblk*.bram36_tdp_bl.bram36_tdp_bl}]
set_property src_info {type:SCOPED_XDC file:1 line:118 export:INPUT save:INPUT read:READ} [current_design]
set_property LOC RAMB36_X1Y35 [get_cells {inst/pcie_top_i/pcie_7x_i/pcie_bram_top/pcie_brams_rx/brams[0].ram/use_tdp.ramb36/genblk*.bram36_tdp_bl.bram36_tdp_bl}]
set_property src_info {type:SCOPED_XDC file:1 line:119 export:INPUT save:INPUT read:READ} [current_design]
set_property LOC RAMB36_X1Y34 [get_cells {inst/pcie_top_i/pcie_7x_i/pcie_bram_top/pcie_brams_tx/brams[0].ram/use_tdp.ramb36/genblk*.bram36_tdp_bl.bram36_tdp_bl}]
set_property src_info {type:SCOPED_XDC file:1 line:120 export:INPUT save:INPUT read:READ} [current_design]
set_property LOC RAMB36_X1Y33 [get_cells {inst/pcie_top_i/pcie_7x_i/pcie_bram_top/pcie_brams_tx/brams[1].ram/use_tdp.ramb36/genblk*.bram36_tdp_bl.bram36_tdp_bl}]
set_property src_info {type:SCOPED_XDC file:1 line:121 export:INPUT save:INPUT read:READ} [current_design]
set_property LOC RAMB36_X1Y32 [get_cells {inst/pcie_top_i/pcie_7x_i/pcie_bram_top/pcie_brams_tx/brams[2].ram/use_tdp.ramb36/genblk*.bram36_tdp_bl.bram36_tdp_bl}]
set_property src_info {type:SCOPED_XDC file:1 line:122 export:INPUT save:INPUT read:READ} [current_design]
set_property LOC RAMB36_X1Y31 [get_cells {inst/pcie_top_i/pcie_7x_i/pcie_bram_top/pcie_brams_tx/brams[3].ram/use_tdp.ramb36/genblk*.bram36_tdp_bl.bram36_tdp_bl}]
