phoenix-pnp/ThunderScope/Firmware/Artix7_PCIe/dso_top/dso_top.srcs/sources_1/bd/design_1/hdl/design_1_wrapper.v

//Copyright 1986-2020 Xilinx, Inc. All Rights Reserved.
//--------------------------------------------------------------------------------
//Tool Version: Vivado v.2020.1 (win64) Build 2902540 Wed May 27 19:54:49 MDT 2020
//Date        : Sat May  8 19:18:19 2021
//Host        : DESKTOP-J72MK93 running 64-bit major release  (build 9200)
//Command     : generate_target design_1_wrapper.bd
//Design      : design_1_wrapper
//Purpose     : IP block netlist
//--------------------------------------------------------------------------------
`timescale 1 ps / 1 ps

module design_1_wrapper
   (AXI_STR_TXD_0_tdata,
    AXI_STR_TXD_0_tlast,
    AXI_STR_TXD_0_tready,
    AXI_STR_TXD_0_tvalid,
    BRAM_PORTA_addr,
    BRAM_PORTA_clk,
    BRAM_PORTA_din,
    BRAM_PORTA_dout,
    BRAM_PORTA_we,
    M_AXI_0_araddr,
    M_AXI_0_arburst,
    M_AXI_0_arcache,
    M_AXI_0_arid,
    M_AXI_0_arlen,
    M_AXI_0_arlock,
    M_AXI_0_arprot,
    M_AXI_0_arready,
    M_AXI_0_arsize,
    M_AXI_0_arvalid,
    M_AXI_0_awaddr,
    M_AXI_0_awburst,
    M_AXI_0_awcache,
    M_AXI_0_awid,
    M_AXI_0_awlen,
    M_AXI_0_awlock,
    M_AXI_0_awprot,
    M_AXI_0_awready,
    M_AXI_0_awsize,
    M_AXI_0_awvalid,
    M_AXI_0_bid,
    M_AXI_0_bready,
    M_AXI_0_bresp,
    M_AXI_0_bvalid,
    M_AXI_0_rdata,
    M_AXI_0_rid,
    M_AXI_0_rlast,
    M_AXI_0_rready,
    M_AXI_0_rresp,
    M_AXI_0_rvalid,
    M_AXI_0_wdata,
    M_AXI_0_wlast,
    M_AXI_0_wready,
    M_AXI_0_wstrb,
    M_AXI_0_wvalid,
    S_AXI_0_araddr,
    S_AXI_0_arburst,
    S_AXI_0_arcache,
    S_AXI_0_arid,
    S_AXI_0_arlen,
    S_AXI_0_arlock,
    S_AXI_0_arprot,
    S_AXI_0_arready,
    S_AXI_0_arsize,
    S_AXI_0_arvalid,
    S_AXI_0_awaddr,
    S_AXI_0_awburst,
    S_AXI_0_awcache,
    S_AXI_0_awid,
    S_AXI_0_awlen,
    S_AXI_0_awlock,
    S_AXI_0_awprot,
    S_AXI_0_awready,
    S_AXI_0_awsize,
    S_AXI_0_awvalid,
    S_AXI_0_bid,
    S_AXI_0_bready,
    S_AXI_0_bresp,
    S_AXI_0_bvalid,
    S_AXI_0_rdata,
    S_AXI_0_rid,
    S_AXI_0_rlast,
    S_AXI_0_rready,
    S_AXI_0_rresp,
    S_AXI_0_rvalid,
    S_AXI_0_wdata,
    S_AXI_0_wlast,
    S_AXI_0_wready,
    S_AXI_0_wstrb,
    S_AXI_0_wvalid,
    axi_aclk,
    axi_aresetn,
    gpio2_io_i,
    gpio2_io_i_0,
    gpio_io_o_0,
    gpio_io_o_1,
    pcie_clk_n,
    pcie_clk_p,
    pcie_mgt_rxn,
    pcie_mgt_rxp,
    pcie_mgt_txn,
    pcie_mgt_txp,
    pcie_perstn);
  output [31:0]AXI_STR_TXD_0_tdata;
  output AXI_STR_TXD_0_tlast;
  input AXI_STR_TXD_0_tready;
  output AXI_STR_TXD_0_tvalid;
  input [31:0]BRAM_PORTA_addr;
  input BRAM_PORTA_clk;
  input [63:0]BRAM_PORTA_din;
  output [63:0]BRAM_PORTA_dout;
  input [7:0]BRAM_PORTA_we;
  output [63:0]M_AXI_0_araddr;
  output [1:0]M_AXI_0_arburst;
  output [3:0]M_AXI_0_arcache;
  output [3:0]M_AXI_0_arid;
  output [7:0]M_AXI_0_arlen;
  output M_AXI_0_arlock;
  output [2:0]M_AXI_0_arprot;
  input M_AXI_0_arready;
  output [2:0]M_AXI_0_arsize;
  output M_AXI_0_arvalid;
  output [63:0]M_AXI_0_awaddr;
  output [1:0]M_AXI_0_awburst;
  output [3:0]M_AXI_0_awcache;
  output [3:0]M_AXI_0_awid;
  output [7:0]M_AXI_0_awlen;
  output M_AXI_0_awlock;
  output [2:0]M_AXI_0_awprot;
  input M_AXI_0_awready;
  output [2:0]M_AXI_0_awsize;
  output M_AXI_0_awvalid;
  input [3:0]M_AXI_0_bid;
  output M_AXI_0_bready;
  input [1:0]M_AXI_0_bresp;
  input M_AXI_0_bvalid;
  input [127:0]M_AXI_0_rdata;
  input [3:0]M_AXI_0_rid;
  input M_AXI_0_rlast;
  output M_AXI_0_rready;
  input [1:0]M_AXI_0_rresp;
  input M_AXI_0_rvalid;
  output [127:0]M_AXI_0_wdata;
  output M_AXI_0_wlast;
  input M_AXI_0_wready;
  output [15:0]M_AXI_0_wstrb;
  output M_AXI_0_wvalid;
  input [17:0]S_AXI_0_araddr;
  input [1:0]S_AXI_0_arburst;
  input [3:0]S_AXI_0_arcache;
  input [3:0]S_AXI_0_arid;
  input [7:0]S_AXI_0_arlen;
  input S_AXI_0_arlock;
  input [2:0]S_AXI_0_arprot;
  output S_AXI_0_arready;
  input [2:0]S_AXI_0_arsize;
  input S_AXI_0_arvalid;
  input [17:0]S_AXI_0_awaddr;
  input [1:0]S_AXI_0_awburst;
  input [3:0]S_AXI_0_awcache;
  input [3:0]S_AXI_0_awid;
  input [7:0]S_AXI_0_awlen;
  input S_AXI_0_awlock;
  input [2:0]S_AXI_0_awprot;
  output S_AXI_0_awready;
  input [2:0]S_AXI_0_awsize;
  input S_AXI_0_awvalid;
  output [3:0]S_AXI_0_bid;
  input S_AXI_0_bready;
  output [1:0]S_AXI_0_bresp;
  output S_AXI_0_bvalid;
  output [127:0]S_AXI_0_rdata;
  output [3:0]S_AXI_0_rid;
  output S_AXI_0_rlast;
  input S_AXI_0_rready;
  output [1:0]S_AXI_0_rresp;
  output S_AXI_0_rvalid;
  input [127:0]S_AXI_0_wdata;
  input S_AXI_0_wlast;
  output S_AXI_0_wready;
  input [15:0]S_AXI_0_wstrb;
  input S_AXI_0_wvalid;
  output axi_aclk;
  output axi_aresetn;
  input [31:0]gpio2_io_i;
  input [31:0]gpio2_io_i_0;
  output [31:0]gpio_io_o_0;
  output [31:0]gpio_io_o_1;
  input [0:0]pcie_clk_n;
  input [0:0]pcie_clk_p;
  input [3:0]pcie_mgt_rxn;
  input [3:0]pcie_mgt_rxp;
  output [3:0]pcie_mgt_txn;
  output [3:0]pcie_mgt_txp;
  input pcie_perstn;

  wire [31:0]AXI_STR_TXD_0_tdata;
  wire AXI_STR_TXD_0_tlast;
  wire AXI_STR_TXD_0_tready;
  wire AXI_STR_TXD_0_tvalid;
  wire [31:0]BRAM_PORTA_addr;
  wire BRAM_PORTA_clk;
  wire [63:0]BRAM_PORTA_din;
  wire [63:0]BRAM_PORTA_dout;
  wire [7:0]BRAM_PORTA_we;
  wire [63:0]M_AXI_0_araddr;
  wire [1:0]M_AXI_0_arburst;
  wire [3:0]M_AXI_0_arcache;
  wire [3:0]M_AXI_0_arid;
  wire [7:0]M_AXI_0_arlen;
  wire M_AXI_0_arlock;
  wire [2:0]M_AXI_0_arprot;
  wire M_AXI_0_arready;
  wire [2:0]M_AXI_0_arsize;
  wire M_AXI_0_arvalid;
  wire [63:0]M_AXI_0_awaddr;
  wire [1:0]M_AXI_0_awburst;
  wire [3:0]M_AXI_0_awcache;
  wire [3:0]M_AXI_0_awid;
  wire [7:0]M_AXI_0_awlen;
  wire M_AXI_0_awlock;
  wire [2:0]M_AXI_0_awprot;
  wire M_AXI_0_awready;
  wire [2:0]M_AXI_0_awsize;
  wire M_AXI_0_awvalid;
  wire [3:0]M_AXI_0_bid;
  wire M_AXI_0_bready;
  wire [1:0]M_AXI_0_bresp;
  wire M_AXI_0_bvalid;
  wire [127:0]M_AXI_0_rdata;
  wire [3:0]M_AXI_0_rid;
  wire M_AXI_0_rlast;
  wire M_AXI_0_rready;
  wire [1:0]M_AXI_0_rresp;
  wire M_AXI_0_rvalid;
  wire [127:0]M_AXI_0_wdata;
  wire M_AXI_0_wlast;
  wire M_AXI_0_wready;
  wire [15:0]M_AXI_0_wstrb;
  wire M_AXI_0_wvalid;
  wire [17:0]S_AXI_0_araddr;
  wire [1:0]S_AXI_0_arburst;
  wire [3:0]S_AXI_0_arcache;
  wire [3:0]S_AXI_0_arid;
  wire [7:0]S_AXI_0_arlen;
  wire S_AXI_0_arlock;
  wire [2:0]S_AXI_0_arprot;
  wire S_AXI_0_arready;
  wire [2:0]S_AXI_0_arsize;
  wire S_AXI_0_arvalid;
  wire [17:0]S_AXI_0_awaddr;
  wire [1:0]S_AXI_0_awburst;
  wire [3:0]S_AXI_0_awcache;
  wire [3:0]S_AXI_0_awid;
  wire [7:0]S_AXI_0_awlen;
  wire S_AXI_0_awlock;
  wire [2:0]S_AXI_0_awprot;
  wire S_AXI_0_awready;
  wire [2:0]S_AXI_0_awsize;
  wire S_AXI_0_awvalid;
  wire [3:0]S_AXI_0_bid;
  wire S_AXI_0_bready;
  wire [1:0]S_AXI_0_bresp;
  wire S_AXI_0_bvalid;
  wire [127:0]S_AXI_0_rdata;
  wire [3:0]S_AXI_0_rid;
  wire S_AXI_0_rlast;
  wire S_AXI_0_rready;
  wire [1:0]S_AXI_0_rresp;
  wire S_AXI_0_rvalid;
  wire [127:0]S_AXI_0_wdata;
  wire S_AXI_0_wlast;
  wire S_AXI_0_wready;
  wire [15:0]S_AXI_0_wstrb;
  wire S_AXI_0_wvalid;
  wire axi_aclk;
  wire axi_aresetn;
  wire [31:0]gpio2_io_i;
  wire [31:0]gpio2_io_i_0;
  wire [31:0]gpio_io_o_0;
  wire [31:0]gpio_io_o_1;
  wire [0:0]pcie_clk_n;
  wire [0:0]pcie_clk_p;
  wire [3:0]pcie_mgt_rxn;
  wire [3:0]pcie_mgt_rxp;
  wire [3:0]pcie_mgt_txn;
  wire [3:0]pcie_mgt_txp;
  wire pcie_perstn;

  design_1 design_1_i
       (.AXI_STR_TXD_0_tdata(AXI_STR_TXD_0_tdata),
        .AXI_STR_TXD_0_tlast(AXI_STR_TXD_0_tlast),
        .AXI_STR_TXD_0_tready(AXI_STR_TXD_0_tready),
        .AXI_STR_TXD_0_tvalid(AXI_STR_TXD_0_tvalid),
        .BRAM_PORTA_addr(BRAM_PORTA_addr),
        .BRAM_PORTA_clk(BRAM_PORTA_clk),
        .BRAM_PORTA_din(BRAM_PORTA_din),
        .BRAM_PORTA_dout(BRAM_PORTA_dout),
        .BRAM_PORTA_we(BRAM_PORTA_we),
        .M_AXI_0_araddr(M_AXI_0_araddr),
        .M_AXI_0_arburst(M_AXI_0_arburst),
        .M_AXI_0_arcache(M_AXI_0_arcache),
        .M_AXI_0_arid(M_AXI_0_arid),
        .M_AXI_0_arlen(M_AXI_0_arlen),
        .M_AXI_0_arlock(M_AXI_0_arlock),
        .M_AXI_0_arprot(M_AXI_0_arprot),
        .M_AXI_0_arready(M_AXI_0_arready),
        .M_AXI_0_arsize(M_AXI_0_arsize),
        .M_AXI_0_arvalid(M_AXI_0_arvalid),
        .M_AXI_0_awaddr(M_AXI_0_awaddr),
        .M_AXI_0_awburst(M_AXI_0_awburst),
        .M_AXI_0_awcache(M_AXI_0_awcache),
        .M_AXI_0_awid(M_AXI_0_awid),
        .M_AXI_0_awlen(M_AXI_0_awlen),
        .M_AXI_0_awlock(M_AXI_0_awlock),
        .M_AXI_0_awprot(M_AXI_0_awprot),
        .M_AXI_0_awready(M_AXI_0_awready),
        .M_AXI_0_awsize(M_AXI_0_awsize),
        .M_AXI_0_awvalid(M_AXI_0_awvalid),
        .M_AXI_0_bid(M_AXI_0_bid),
        .M_AXI_0_bready(M_AXI_0_bready),
        .M_AXI_0_bresp(M_AXI_0_bresp),
        .M_AXI_0_bvalid(M_AXI_0_bvalid),
        .M_AXI_0_rdata(M_AXI_0_rdata),
        .M_AXI_0_rid(M_AXI_0_rid),
        .M_AXI_0_rlast(M_AXI_0_rlast),
        .M_AXI_0_rready(M_AXI_0_rready),
        .M_AXI_0_rresp(M_AXI_0_rresp),
        .M_AXI_0_rvalid(M_AXI_0_rvalid),
        .M_AXI_0_wdata(M_AXI_0_wdata),
        .M_AXI_0_wlast(M_AXI_0_wlast),
        .M_AXI_0_wready(M_AXI_0_wready),
        .M_AXI_0_wstrb(M_AXI_0_wstrb),
        .M_AXI_0_wvalid(M_AXI_0_wvalid),
        .S_AXI_0_araddr(S_AXI_0_araddr),
        .S_AXI_0_arburst(S_AXI_0_arburst),
        .S_AXI_0_arcache(S_AXI_0_arcache),
        .S_AXI_0_arid(S_AXI_0_arid),
        .S_AXI_0_arlen(S_AXI_0_arlen),
        .S_AXI_0_arlock(S_AXI_0_arlock),
        .S_AXI_0_arprot(S_AXI_0_arprot),
        .S_AXI_0_arready(S_AXI_0_arready),
        .S_AXI_0_arsize(S_AXI_0_arsize),
        .S_AXI_0_arvalid(S_AXI_0_arvalid),
        .S_AXI_0_awaddr(S_AXI_0_awaddr),
        .S_AXI_0_awburst(S_AXI_0_awburst),
        .S_AXI_0_awcache(S_AXI_0_awcache),
        .S_AXI_0_awid(S_AXI_0_awid),
        .S_AXI_0_awlen(S_AXI_0_awlen),
        .S_AXI_0_awlock(S_AXI_0_awlock),
        .S_AXI_0_awprot(S_AXI_0_awprot),
        .S_AXI_0_awready(S_AXI_0_awready),
        .S_AXI_0_awsize(S_AXI_0_awsize),
        .S_AXI_0_awvalid(S_AXI_0_awvalid),
        .S_AXI_0_bid(S_AXI_0_bid),
        .S_AXI_0_bready(S_AXI_0_bready),
        .S_AXI_0_bresp(S_AXI_0_bresp),
        .S_AXI_0_bvalid(S_AXI_0_bvalid),
        .S_AXI_0_rdata(S_AXI_0_rdata),
        .S_AXI_0_rid(S_AXI_0_rid),
        .S_AXI_0_rlast(S_AXI_0_rlast),
        .S_AXI_0_rready(S_AXI_0_rready),
        .S_AXI_0_rresp(S_AXI_0_rresp),
        .S_AXI_0_rvalid(S_AXI_0_rvalid),
        .S_AXI_0_wdata(S_AXI_0_wdata),
        .S_AXI_0_wlast(S_AXI_0_wlast),
        .S_AXI_0_wready(S_AXI_0_wready),
        .S_AXI_0_wstrb(S_AXI_0_wstrb),
        .S_AXI_0_wvalid(S_AXI_0_wvalid),
        .axi_aclk(axi_aclk),
        .axi_aresetn(axi_aresetn),
        .gpio2_io_i(gpio2_io_i),
        .gpio2_io_i_0(gpio2_io_i_0),
        .gpio_io_o_0(gpio_io_o_0),
        .gpio_io_o_1(gpio_io_o_1),
        .pcie_clk_n(pcie_clk_n),
        .pcie_clk_p(pcie_clk_p),
        .pcie_mgt_rxn(pcie_mgt_rxn),
        .pcie_mgt_rxp(pcie_mgt_rxp),
        .pcie_mgt_txn(pcie_mgt_txn),
        .pcie_mgt_txp(pcie_mgt_txp),
        .pcie_perstn(pcie_perstn));
endmodule
