phoenix-pnp/ThunderScope/Software/waveview/scope_link/src/bridge.cpp

#include "bridge.hpp"
#include "logger.hpp"
#include <fcntl.h>
#include <cerrno>

/*******************************************************************************
 * FreePacket()
 *
 * Frees the packet and all data it points to.
 *
 * Arguments:
 *   EVPacket* packet - pointer to the packet.
 * Return:
 *   None
 ******************************************************************************/
inline void FreePacket(EVPacket* packet) {
    free(packet->data);
    free(packet);
}

/*******************************************************************************
 * PrintPacket()
 *
 * Prints the contents of a packet.
 *
 * Arguments:
 *   EVPacket* packet - pointer to the packet.
 * Return:
 *   None
 ******************************************************************************/
void PrintPacket(EVPacket* packet) {
    std::string dbgMsg = "PacketID_HEX: " + convert_int(packet->packetID);
    dbgMsg += ", Command: " + std::to_string(packet->command);
    dbgMsg += ", DataSize: " + std::to_string(packet->dataSize) + ", Data: ";
    for(unsigned i = 0; i < packet->dataSize; i++) {
        dbgMsg += convert_int(packet->data[i]) + " ";
    }
    INFO << dbgMsg;
}

/*******************************************************************************
 * Bridge()
 *
 * Constructor for the bridge.
 *
 * Arguments:
 *   const char* pipeName
 *   std::queue<EVPacket*>& txQueue
 *   std::queue<EVPacket*>& rxQueue
 * Return:
 *   None
 ******************************************************************************/
Bridge::Bridge(const char* pipeName, 
               boost::lockfree::queue<EVPacket*, boost::lockfree::fixed_sized<false>> *txQueue,
               boost::lockfree::queue<EVPacket*, boost::lockfree::fixed_sized<false>> *outputQ
               ) :
txQueue(txQueue)
{
    // command packets from js
    rxOutputQueue = outputQ;

    tx_buff = (char*)malloc(sizeof(char) * BRIDGE_BUFFER_SIZE);
    txBuff = (char*)malloc(sizeof(char) * BRIDGE_BUFFER_SIZE);
    rx_buff = (char*)malloc(sizeof(char) * BRIDGE_BUFFER_SIZE);
    rxBuff = (char*)malloc(sizeof(char) * BRIDGE_BUFFER_SIZE);
    tx_test_buff = (char*)malloc(sizeof(char) * BRIDGE_BUFFER_SIZE);
    rx_test_buff = (char*)malloc(sizeof(char) * BRIDGE_BUFFER_SIZE);

    tx_run.store(false);
    rx_run.store(false);
#ifdef WIN32
    tx_hPipe = INVALID_HANDLE_VALUE;
    rx_hPipe = INVALID_HANDLE_VALUE;
    tx_test_hPipe = INVALID_HANDLE_VALUE;
    rx_test_hPipe = INVALID_HANDLE_VALUE;
#else
    tx_sock = -1;
    rx_sock = -1;
    client_tx_sock = -1;
#endif

    // TODO: If sprintf is available on windows, it would be nice to get rid
    // of the extra code
#ifdef WIN32 //It seems that strcat_s is a windows thing. huh
    //set up TX Pipe/socket path
    strcat_s((char*)tx_connection_string,100,base_path);
    strcat_s((char*)tx_connection_string,100,pipeName);
    strcat_s((char*)tx_connection_string,100,"TX");
    //set up RX Pipe/socket path
    strcat_s((char*)rx_connection_string,100,base_path);
    strcat_s((char*)rx_connection_string,100,pipeName);
    strcat_s((char*)rx_connection_string,100,"RX");
#else
    //set up TX Pipe/socket path
    sprintf((char*)tx_connection_string,"%s%sTX",base_path,pipeName);
    //set up RX Pipe/socket path
    sprintf((char*)rx_connection_string,"%s%sRX",base_path,pipeName);
#endif
}

/*******************************************************************************
 * ~Bridge()
 *
 * Destructor for the bridge class.
 *
 * Arguments:
 *   None
 * Return:
 *   None
 ******************************************************************************/
Bridge::~Bridge() {
    DEBUG << "Destroying bridge";

    free(tx_buff);
    free(txBuff);
    free(rx_buff);
    free(rxBuff);
    free(tx_test_buff);
    free(rx_test_buff);

#ifdef WIN32
    //If test pipes are created, close them first
    if(INVALID_HANDLE_VALUE != tx_test_hPipe) {
        CloseHandle(tx_test_hPipe);
        tx_test_hPipe = INVALID_HANDLE_VALUE;
    }
    if(INVALID_HANDLE_VALUE != rx_test_hPipe) {
        CloseHandle(rx_test_hPipe);
        rx_test_hPipe = INVALID_HANDLE_VALUE;
    }
#endif

    if (rx_run.load() == true) {
        RxStop();
    }
    if (tx_run.load() == true) {
        TxStop();
    }
    DEBUG << "Bridge destroyed";
}

/*******************************************************************************
 * makeConnection()
 *
 * Establish a connection with the front end
 * Only for POSIX sockets
 *
 * Arguments:
 *   int targetFD - file descriptor of the socket
 *   int targetSocket - socket
 * Return:
 *   None
 ******************************************************************************/
#ifndef WIN32
int Bridge::makeConnection(int targetSocket ) {
    int targetFD = 0;

    if(targetSocket == -1) {
        ERROR << "Socket already initialized";
        return -1;
    }

    //listen and accept a client (the electron app)
    int rc = listen(targetSocket, 10);
    if (rc != 0) {
        perror("socket listen(): ");
        return -1;
    }

    INFO << "targetSocket: listening for clients, waiting to accept....";
    // accept the first client to connect
    // No need to save it's fd since we will never write to it
    struct sockaddr_un address;
    socklen_t addresslen = sizeof(sockaddr_un);

    // TODO: accept is a blocking call. can't exit thread if stuck here
    targetFD = accept(targetSocket, (struct sockaddr*)&address, &addresslen);
    if (targetFD >= 0) {
        // Make socket non-blocking
        int flags = fcntl(targetFD ,F_GETFL,0);
        assert(flags != -1);
        fcntl(targetFD, F_SETFL, flags | O_NONBLOCK);

        INFO << "targetSocket: client connected";
    } else {
        // Failed to accept socket
        perror("socket accept(): ");
    }
    return targetFD;
}
#endif

/*******************************************************************************
 * TxJob()
 *
 * Waits for the client to connect and transmits packets in the tx queue.
 *
 * Arguments:
 *   None
 * Return:
 *   None
 ******************************************************************************/
void Bridge::TxJob() {
#ifdef WIN32
    if(tx_hPipe == INVALID_HANDLE_VALUE) {
        return;
    }
    ConnectNamedPipe(tx_hPipe, NULL);
    DEBUG << "tx_pipe: client connected";
#else
    client_tx_sock = makeConnection(tx_sock);
    if (client_tx_sock < 0) {
        ERROR << "rx job failed to make connection";
        return;
    }
#endif
    EVPacket* currentPacket = NULL;

    while(tx_run.load() == true) {
        while(tx_run.load() == true && txQueue->pop(currentPacket)) {

                // Copy packet into tx_buff
                uint16_t* txBuffCast = (uint16_t*)tx_buff;
                int packet_size = 6 + currentPacket->dataSize;
                txBuffCast[0] = currentPacket->command;
                txBuffCast[1] = currentPacket->packetID;
                txBuffCast[2] = currentPacket->dataSize;
                memcpy(tx_buff+6,currentPacket->data,currentPacket->dataSize);

#ifdef WIN32
                // send the packet over a named pipe
                unsigned long bytes_written;
                WriteFile(tx_hPipe,tx_buff,packet_size,&bytes_written,NULL);
#else
                // send the packet over a socket
                PrintPacket(currentPacket);
                send(client_tx_sock,tx_buff,packet_size,0);
#endif
                //free the packet
                FreePacket(currentPacket);
                INFO << "Sent Packet";
        }
        // No more packets, sleep.
        std::this_thread::sleep_for(std::chrono::microseconds(500));
    }
}

/*******************************************************************************
 * RxJob()
 *
 * recieves packets and processes them.
 *
 * Arguments:
 *   None
 * Return:
 *   None
 ******************************************************************************/
void Bridge::RxJob() {
#ifdef WIN32
    if(rx_hPipe == INVALID_HANDLE_VALUE) {
        return;
    }
    ConnectNamedPipe(rx_hPipe, NULL);
    DEBUG << "rx_pipe: client connected";
#else
    client_rx_sock = makeConnection(rx_sock);
    if (client_rx_sock < 0) {
        ERROR << "rx job failed to make connection";
        return;
    }
#endif

    // Read from client
    while(rx_run.load() == true) {
        //reading block until something is sent
#ifdef WIN32
        DWORD packet_size;
        int val;
        unsigned long bytes_read;
        //get the header
        val = ReadFile(rx_hPipe, (LPVOID)rxBuff, 6, &bytes_read, NULL);
        if(val == 0) {
            //error
            int err = GetLastError();
            if(err == 234) { //err 234 is there is more data, not an error
                //do nothing
            } else if(err == 109) { //err 109 there were not enough bytes in the pipline
                std::this_thread::sleep_for(std::chrono::microseconds(500));
                continue; //error packet move onto next one
            } else {
                ERROR << "rx_pipe header_read: Error: " << GetLastError();
                break;
            }
        }

        //check to see if the packet is the END_CONNECTION packet
        uint16_t* endPacketCheck = (uint16_t*)rxBuff;
        if (endPacketCheck[0] == END_PACKET_COMMAND
                && endPacketCheck[1] == END_PACKET_PACKETID
                && endPacketCheck[2] == END_PACKET_DATA_SIZE) {

            DEBUG << "END PACKET Recieved, Jumping Out Of RX Job";
            rx_run.store(false);
            continue;
        }

        //read the rest of the packet
        uint16_t dataSize = ((uint16_t*)(rxBuff))[2];
        if(dataSize < BRIDGE_BUFFER_SIZE - 6) {
            val = ReadFile(rx_hPipe, (LPVOID)(rxBuff + 6), dataSize, &bytes_read, NULL);
        } else {
            continue;
        }
        if(val == 0){
            //error
            int err = GetLastError();
            if (err == 234) {
                // more data exists. Wait for it
                std::this_thread::sleep_for(std::chrono::microseconds(500));
            } else if (err == 109) {
                // not enough bytes in pipeline
                // Skip error packet
                std::this_thread::sleep_for(std::chrono::microseconds(500));
                continue;
            } else {
                ERROR << "rx_pipe data_read: Error: " << GetLastError();
                break;
            }
        }
        packet_size = 6 + dataSize;
#else
        ssize_t packet_size;
        packet_size = recv(client_rx_sock,rxBuff,BRIDGE_BUFFER_SIZE,0);
        if(packet_size > 0) {
            INFO << "rx_sock: Packet Size: " << (int)packet_size << " Message:" << rxBuff;
        } else if (packet_size == -1) {
            switch (errno) {
                case EWOULDBLOCK:
                    // No data on socket. sleep
                    std::this_thread::sleep_for(std::chrono::microseconds(500));
                    continue;
                default:
                    perror("recv returned error: ");
            }
            continue;
        } else {
            INFO << "No messages and peer disconnected";
            // TODO: Allow clients to connect and disconnect
            // Kill the server
            rx_run.store(false);
        }
#endif
        // TODO: you can just cast it as the struct and access things that way
        uint16_t* rxBuff16 = (uint16_t*) rxBuff;
        uint8_t* rxBuffData = (uint8_t*) (rxBuff + 6);
        //reconstruct packet struct
        EVPacket* rxPacket = (EVPacket*)malloc(sizeof(EVPacket));
        //get the header
        rxPacket->command = rxBuff16[0];
        rxPacket->packetID = rxBuff16[1];
        rxPacket->dataSize = rxBuff16[2];

        //check that the dataSize is valid (less than or equal to BUFF_SIZE - 6)
        // TODO: Might be good idea to set data on all command packets to NULL
        //       and check against it. It would save a lot of malloc.
        if(rxPacket->dataSize <= BRIDGE_BUFFER_SIZE - 6) {
            rxPacket->data = (int8_t*)malloc(rxPacket->dataSize);
            memcpy(rxPacket->data,rxBuffData,rxPacket->dataSize);
        } else {
            // TODO: this is a transmission error for now, until we get multiple
            // packet payloads enabled
            rxPacket->dataSize = 1;
            rxPacket->data = (int8_t*)malloc(1);
        }

        // Push packet to the controller so it has access to the other threads
        rxOutputQueue->push(rxPacket);
    }
}

/*******************************************************************************
 * TxStart()
 *
 * Initializes the tx bridge and starts the tx worker thread.
 *
 * Arguments:
 *   None
 * Return:
 *   int - 0 on success, err on failure
 ******************************************************************************/
int Bridge::TxStart() {
    if (tx_run.load() == true) {
        ERROR << "tx_run already set for some reason";
        TxStop();
    }

    int err = InitTxBridge();
    if (err) {
        return err;
    }
    DEBUG << "Initialized Tx Bridge";

    tx_run.store(true);
    tx_worker = std::thread(&Bridge::TxJob, this);
    DEBUG << "Started Tx Worker";
    return 0;
}

/*******************************************************************************
 * RxStart()
 *
 * Initializes the rx bridge and starts the rx worker thread.
 *
 * Arguments:
 *   None
 * Return:
 *   int - 0 on success, err on failure
 ******************************************************************************/
int Bridge::RxStart() {
    if (rx_run.load() == true) {
        RxStop();
    }

    int err = InitRxBridge();
    if (err) {
        return err;
    }
    DEBUG << "Init'd Rx Bridge";

    rx_run.store(true);
    rx_worker = std::thread(&Bridge::RxJob, this);
    DEBUG << "Started Rx Worker";
    return 0;
}

/*******************************************************************************
 * InitTxBridge()
 *
 * Creates a named pipe for the tx bridge.
 *
 * Arguments:
 *   None
 * Return:
 *   int - 0 on success, error code on failure
 ******************************************************************************/
int Bridge::InitTxBridge() {
#ifdef WIN32
    if(tx_hPipe != INVALID_HANDLE_VALUE) {
        return 2;
    }
    tx_hPipe = CreateNamedPipe(tx_connection_string,
                               PIPE_ACCESS_DUPLEX | FILE_FLAG_FIRST_PIPE_INSTANCE,
                               // FILE_FLAG_FIRST_PIPE_INSTANCE is not needed
                               // but forces CreateNamedPipe(..) to fail if the
                               // pipe already exists...
                               PIPE_TYPE_MESSAGE | PIPE_READMODE_MESSAGE | PIPE_WAIT | PIPE_REJECT_REMOTE_CLIENTS,
                               1,
                               (1 << 24),
                               (1 << 24),
                               NMPWAIT_USE_DEFAULT_WAIT,
                               NULL);

    if(tx_hPipe == INVALID_HANDLE_VALUE) {
        ERROR << "Failed To Create Tx Pipe at: " << tx_connection_string;
        return 1;
    }
    
    DEBUG << "Created Tx Pipe at: " << tx_connection_string;
    return 0;

#else
    struct sockaddr_un name;

    //create the socket
    tx_sock = socket(AF_UNIX, SOCK_STREAM, 0);
    if(tx_sock < 0) {
        perror("tx_sock::socket(): ");
        return 1;
    }
    //unlink the socket just in case the previous shutdown was not proper
    unlink(tx_connection_string);
    //set up the address/file location struct
    name.sun_family = AF_UNIX;
    int str_len = 0;
    while(tx_connection_string[str_len]) {
        name.sun_path[str_len] = tx_connection_string[str_len];
        str_len++;
    }
    name.sun_path[str_len] = 0;
    //bind the socket
    size_t size = SUN_LEN(&name);
    if(bind (tx_sock, (struct sockaddr *) &name, size) < 0) {
        perror("tx_sock::bind(): ");
        return 2;
    }

    DEBUG << "tx_sock created and bound on " << name.sun_path;
    return 0;
#endif
}

/*******************************************************************************
 * InitRxBridge()
 *
 * Creates a named pipe for the rx bridge.
 *
 * Arguments:
 *   None
 * Return:
 *   int - 0 on success, error code on failure
 ******************************************************************************/
int Bridge::InitRxBridge() {
#ifdef WIN32
    if(rx_hPipe != INVALID_HANDLE_VALUE) {
        return 2;
    }
    rx_hPipe = CreateNamedPipe(rx_connection_string,
                               PIPE_ACCESS_DUPLEX | FILE_FLAG_FIRST_PIPE_INSTANCE,
                               // FILE_FLAG_FIRST_PIPE_INSTANCE is not needed
                               // but forces CreateNamedPipe(..) to fail if the
                               // pipe already exists...
                               PIPE_TYPE_MESSAGE | PIPE_READMODE_MESSAGE |
                               PIPE_WAIT | PIPE_REJECT_REMOTE_CLIENTS,
                               1,
                               (1 << 24),
                               (1 << 24),
                               NMPWAIT_USE_DEFAULT_WAIT,
                               NULL);

    if(rx_hPipe == INVALID_HANDLE_VALUE) {
        ERROR << "Failed To Create Rx Pipe at: " << rx_connection_string;
        return 1;
    }

    DEBUG << "Created Rx Pipe at: " << rx_connection_string;
    return 0;
#else
    struct sockaddr_un name;

    //create the socket
    rx_sock = socket(AF_UNIX, SOCK_STREAM, 0);
    if(rx_sock < 0) {
        perror("rx_sock::socket(): ");
        return 1;
    }
    //unlink the socket just in case the previous shutdown was not proper
    unlink(rx_connection_string);
    //set up the address/file location struct
    name.sun_family = AF_UNIX;
    int str_len = 0;
    while(rx_connection_string[str_len]) {
        name.sun_path[str_len] = rx_connection_string[str_len];
        str_len++;
    }
    name.sun_path[str_len] = 0;
    //bind the socket
    size_t size = SUN_LEN(&name);
    if(bind (rx_sock, (struct sockaddr *) &name, size) < 0) {
        perror("rx_sock::bind(): ");
        return 2;
    }

    DEBUG << "rx_sock created and bound on " << name.sun_path;
    return 0;
#endif
}

#ifdef WIN32
int Bridge::InitTxTestBridge() {
    if(tx_test_hPipe != INVALID_HANDLE_VALUE) {
        return 2;
    }
    tx_test_hPipe = CreateFile( 
         rx_connection_string,   // pipe name 
         GENERIC_READ |  // read and write access 
         GENERIC_WRITE, 
         0,              // no sharing 
         NULL,           // default security attributes
         OPEN_EXISTING,  // opens existing pipe 
         0,              // default attributes 
         NULL);          // no template file 

    if(tx_test_hPipe == INVALID_HANDLE_VALUE) {
        ERROR << "Failed To Open Test Tx Pipe at: " << rx_connection_string;
        return 1;
    }
    
    INFO << "Opened Test Tx Pipe at: " << rx_connection_string;
    return 0;
}

int Bridge::InitRxTestBridge() {
    if(rx_test_hPipe != INVALID_HANDLE_VALUE) {
        return 2;
    }
    rx_test_hPipe = CreateFile( 
         tx_connection_string,   // pipe name 
         GENERIC_READ |  // read and write access 
         GENERIC_WRITE, 
         0,              // no sharing 
         NULL,           // default security attributes
         OPEN_EXISTING,  // opens existing pipe 
         0,              // default attributes 
         NULL);          // no template file 

    if(rx_test_hPipe == INVALID_HANDLE_VALUE) {
        ERROR << "Failed To Open Test Rx Pipe at: " << tx_connection_string;
        return 1;
    }
    
    INFO << "Opened Test Rx Pipe at: " << tx_connection_string;
    return 0;
}

EVPacket Bridge::ReadPacket(HANDLE hPipe) {
    EVPacket packet;
    DWORD packet_size;
    int val;
    unsigned long bytes_read;
    //get the header
    val = ReadFile(hPipe, rx_test_buff, 6, &bytes_read, NULL);
    if(val == 0) {
        //error
        int err = GetLastError();
        if(err == 234) { //err 234 is there is more data, not an error
            //do nothing
        } else if(err == 109) { //err 109 there were not enough bytes in the pipline
            return packet; //error packet move onto next one
        } else {
            ERROR << "rx_test_pipe header_read: Error: " << GetLastError();
            return packet;
        }
    }

    //check to see if the packet is the END_CONNECTION packet
    //uint16_t* endPacketCheck = (uint16_t*)rxBuff;
    //if (endPacketCheck[0] == END_PACKET_COMMAND
    //        && endPacketCheck[1] == END_PACKET_PACKETID
    //        && endPacketCheck[2] == END_PACKET_DATA_SIZE) {
    //
    //    DEBUG << "END PACKET Recieved, Jumping Out Of RX Job";
    //    rx_run.store(false);
    //    continue;
    //}

    //read the rest of the packet
    uint16_t dataSize = ((uint16_t*)(rxBuff))[2];
    if(dataSize < BRIDGE_BUFFER_SIZE - 6) {
        val = ReadFile(hPipe, rx_test_buff + 6, dataSize, &bytes_read, NULL);
    } else {
        return packet;
    }
    if(val == 0){
        //error
        int err = GetLastError();
        if (err == 234) {
            // more data exists
        } else if (err == 109) {
            // not enough bytes in pipeline
            // Skip error packet
            return packet;
        } else {
            ERROR << "rx_test_pipe data_read: Error: " << GetLastError();
            return packet;
        }
    }
    packet_size = 6 + dataSize;

    // TODO: you can just cast it as the struct and access things that way
    uint16_t* rxBuff16 = (uint16_t*) rx_test_buff;
    uint8_t* rxBuffData = (uint8_t*) (rx_test_buff + 6);
    //get the header
    packet.command = rxBuff16[0];
    packet.packetID = rxBuff16[1];
    packet.dataSize = rxBuff16[2];

    //check that the dataSize is valid (less than or equal to BUFF_SIZE - 6)
    // TODO: Might be good idea to set data on all command packets to NULL
    //       and check against it. It would save a lot of malloc.
    if(packet.dataSize <= BRIDGE_BUFFER_SIZE - 6) {
        packet.data = (int8_t*)malloc(packet.dataSize);
        memcpy(packet.data,rxBuffData,packet.dataSize);
    } else {
        // TODO: this is a transmission error for now, until we get multiple
        // packet payloads enabled
        packet.dataSize = 1;
        packet.data = (int8_t*)malloc(1);
    }

    return packet;
}

void Bridge::SendPacket(HANDLE hPipe, EVPacket packet) {
    // Copy packet into tx_buff
    uint16_t* txBuffCast = (uint16_t*)tx_test_buff;
    int packet_size = 6 + packet.dataSize;
    txBuffCast[0] = packet.command;
    txBuffCast[1] = packet.packetID;
    txBuffCast[2] = packet.dataSize;
    memcpy(tx_test_buff+6,packet.data,packet.dataSize);

    // send the packet over a named pipe
    unsigned long bytes_written;
    WriteFile(hPipe,tx_test_buff,packet_size,&bytes_written,NULL);
}

#else

#endif

/*******************************************************************************
 * TxStop()
 *
 * Closes the tx bridge and joins the worker thread.
 *
 * Arguments:
 *   None
 * Return:
 *   int - 0 on success
 ******************************************************************************/
int Bridge::TxStop() {
    DEBUG << "Stopping Tx";

    tx_run.store(false);

#ifdef WIN32 // Ensurses the code does not get stuck trying to accept a client

    HANDLE hfile;
    //open a link to the named pipe
    hfile = CreateFileA((LPCSTR)tx_connection_string,
                        GENERIC_WRITE | GENERIC_READ,
                        FILE_SHARE_READ | FILE_SHARE_WRITE,
                        NULL, OPEN_EXISTING,
                        FILE_ATTRIBUTE_NORMAL, NULL);

    if (INVALID_HANDLE_VALUE != hfile) {
        //dont do anything on a successful connection
    }
    else
    {
        ERROR << "Failed To Open Handle To Named Pipe: "
              << tx_connection_string << " ERROR CODE: "
              << GetLastError() << " HANDLE: " << hfile;
    }

#endif

    if(tx_worker.joinable()) {
        tx_worker.join();
    }

#ifdef WIN32
    if(INVALID_HANDLE_VALUE != tx_hPipe) {
        CloseHandle(tx_hPipe);
        tx_hPipe = INVALID_HANDLE_VALUE;
    }
#else
    if(-1 != tx_sock) {
        close(tx_sock);
        tx_sock = -1;
        client_tx_sock = -1;
        unlink(tx_connection_string);
    }
#endif

    DEBUG << "Tx stopped";
    return 0;
}

/*******************************************************************************
 * RxStop()
 *
 * Closes the rx bridge and joins the worker thread.
 *
 * Arguments:
 *   None
 * Return:
 *   int - 0 on success
 ******************************************************************************/
int Bridge::RxStop() {
    DEBUG << "Stopping Rx";

    rx_run.store(false);

#ifdef WIN32
    // because windows has blocking calls, because ofc it does, we need to
    // write an end bit to it so that it unblocks and sees that it should end
    // itself.
    // This also ensures that the code does not get stuck on trying to accept a
    // client.
    
    //open a link to the named pipe
    HANDLE hfile;
    hfile = CreateFileA((LPCSTR)rx_connection_string,
                        GENERIC_WRITE | GENERIC_READ,
                        FILE_SHARE_READ | FILE_SHARE_WRITE,
                        NULL, OPEN_EXISTING,
                        FILE_ATTRIBUTE_NORMAL, NULL);
    
    if (INVALID_HANDLE_VALUE != hfile) {
        //write the close packet
        int16_t endPacket[] = {END_PACKET_COMMAND,
                               END_PACKET_PACKETID,
                               END_PACKET_DATA_SIZE};
        DWORD bytesWritten;
        WriteFile(hfile,(LPCVOID)endPacket,6,&bytesWritten,NULL);
        //close handle
        CloseHandle(hfile);
    }
    else 
    {
        ERROR << "Failed To Open Handle To Named Pipe: "
              << rx_connection_string << " ERROR CODE: "
              << GetLastError() << " HANDLE: " << hfile;
    }

#endif

    if(rx_worker.joinable()) {
        rx_worker.join();
    }

#ifdef WIN32
    if(INVALID_HANDLE_VALUE != rx_hPipe) {
        CloseHandle(rx_hPipe);
        rx_hPipe = INVALID_HANDLE_VALUE;
    }

#else
    if(-1 != rx_sock) {
        close(rx_sock);
        rx_sock = -1;
        unlink(rx_connection_string);
    }

#endif

    DEBUG << "Rx stopped";
    return 0;
}
