phoenix-pnp/ThunderScope/Firmware/Artix7_PCIe/dso_top/dso_top.srcs/sources_1/bd/design_1/ip/design_1_xdma_0_0/design_1_xdma_0_0_stub.vhdl

-- Copyright 1986-2020 Xilinx, Inc. All Rights Reserved.
-- --------------------------------------------------------------------------------
-- Tool Version: Vivado v.2020.1 (win64) Build 2902540 Wed May 27 19:54:49 MDT 2020
-- Date        : Sat May  8 19:23:01 2021
-- Host        : DESKTOP-J72MK93 running 64-bit major release  (build 9200)
-- Command     : write_vhdl -force -mode synth_stub
--               c:/Users/Aleksa/Documents/FPGA_Dev/Artix7_PCIe/dso_top/dso_top.srcs/sources_1/bd/design_1/ip/design_1_xdma_0_0/design_1_xdma_0_0_stub.vhdl
-- Design      : design_1_xdma_0_0
-- Purpose     : Stub declaration of top-level module interface
-- Device      : xc7a100tfgg484-2
-- --------------------------------------------------------------------------------
library IEEE;
use IEEE.STD_LOGIC_1164.ALL;

entity design_1_xdma_0_0 is
  Port ( 
    sys_clk : in STD_LOGIC;
    sys_rst_n : in STD_LOGIC;
    user_lnk_up : out STD_LOGIC;
    pci_exp_txp : out STD_LOGIC_VECTOR ( 3 downto 0 );
    pci_exp_txn : out STD_LOGIC_VECTOR ( 3 downto 0 );
    pci_exp_rxp : in STD_LOGIC_VECTOR ( 3 downto 0 );
    pci_exp_rxn : in STD_LOGIC_VECTOR ( 3 downto 0 );
    axi_aclk : out STD_LOGIC;
    axi_aresetn : out STD_LOGIC;
    usr_irq_req : in STD_LOGIC_VECTOR ( 0 to 0 );
    usr_irq_ack : out STD_LOGIC_VECTOR ( 0 to 0 );
    msi_enable : out STD_LOGIC;
    msi_vector_width : out STD_LOGIC_VECTOR ( 2 downto 0 );
    m_axi_awready : in STD_LOGIC;
    m_axi_wready : in STD_LOGIC;
    m_axi_bid : in STD_LOGIC_VECTOR ( 3 downto 0 );
    m_axi_bresp : in STD_LOGIC_VECTOR ( 1 downto 0 );
    m_axi_bvalid : in STD_LOGIC;
    m_axi_arready : in STD_LOGIC;
    m_axi_rid : in STD_LOGIC_VECTOR ( 3 downto 0 );
    m_axi_rdata : in STD_LOGIC_VECTOR ( 127 downto 0 );
    m_axi_rresp : in STD_LOGIC_VECTOR ( 1 downto 0 );
    m_axi_rlast : in STD_LOGIC;
    m_axi_rvalid : in STD_LOGIC;
    m_axi_awid : out STD_LOGIC_VECTOR ( 3 downto 0 );
    m_axi_awaddr : out STD_LOGIC_VECTOR ( 63 downto 0 );
    m_axi_awlen : out STD_LOGIC_VECTOR ( 7 downto 0 );
    m_axi_awsize : out STD_LOGIC_VECTOR ( 2 downto 0 );
    m_axi_awburst : out STD_LOGIC_VECTOR ( 1 downto 0 );
    m_axi_awprot : out STD_LOGIC_VECTOR ( 2 downto 0 );
    m_axi_awvalid : out STD_LOGIC;
    m_axi_awlock : out STD_LOGIC;
    m_axi_awcache : out STD_LOGIC_VECTOR ( 3 downto 0 );
    m_axi_wdata : out STD_LOGIC_VECTOR ( 127 downto 0 );
    m_axi_wstrb : out STD_LOGIC_VECTOR ( 15 downto 0 );
    m_axi_wlast : out STD_LOGIC;
    m_axi_wvalid : out STD_LOGIC;
    m_axi_bready : out STD_LOGIC;
    m_axi_arid : out STD_LOGIC_VECTOR ( 3 downto 0 );
    m_axi_araddr : out STD_LOGIC_VECTOR ( 63 downto 0 );
    m_axi_arlen : out STD_LOGIC_VECTOR ( 7 downto 0 );
    m_axi_arsize : out STD_LOGIC_VECTOR ( 2 downto 0 );
    m_axi_arburst : out STD_LOGIC_VECTOR ( 1 downto 0 );
    m_axi_arprot : out STD_LOGIC_VECTOR ( 2 downto 0 );
    m_axi_arvalid : out STD_LOGIC;
    m_axi_arlock : out STD_LOGIC;
    m_axi_arcache : out STD_LOGIC_VECTOR ( 3 downto 0 );
    m_axi_rready : out STD_LOGIC;
    m_axil_awaddr : out STD_LOGIC_VECTOR ( 31 downto 0 );
    m_axil_awprot : out STD_LOGIC_VECTOR ( 2 downto 0 );
    m_axil_awvalid : out STD_LOGIC;
    m_axil_awready : in STD_LOGIC;
    m_axil_wdata : out STD_LOGIC_VECTOR ( 31 downto 0 );
    m_axil_wstrb : out STD_LOGIC_VECTOR ( 3 downto 0 );
    m_axil_wvalid : out STD_LOGIC;
    m_axil_wready : in STD_LOGIC;
    m_axil_bvalid : in STD_LOGIC;
    m_axil_bresp : in STD_LOGIC_VECTOR ( 1 downto 0 );
    m_axil_bready : out STD_LOGIC;
    m_axil_araddr : out STD_LOGIC_VECTOR ( 31 downto 0 );
    m_axil_arprot : out STD_LOGIC_VECTOR ( 2 downto 0 );
    m_axil_arvalid : out STD_LOGIC;
    m_axil_arready : in STD_LOGIC;
    m_axil_rdata : in STD_LOGIC_VECTOR ( 31 downto 0 );
    m_axil_rresp : in STD_LOGIC_VECTOR ( 1 downto 0 );
    m_axil_rvalid : in STD_LOGIC;
    m_axil_rready : out STD_LOGIC
  );

end design_1_xdma_0_0;

architecture stub of design_1_xdma_0_0 is
attribute syn_black_box : boolean;
attribute black_box_pad_pin : string;
attribute syn_black_box of stub : architecture is true;
attribute black_box_pad_pin of stub : architecture is "sys_clk,sys_rst_n,user_lnk_up,pci_exp_txp[3:0],pci_exp_txn[3:0],pci_exp_rxp[3:0],pci_exp_rxn[3:0],axi_aclk,axi_aresetn,usr_irq_req[0:0],usr_irq_ack[0:0],msi_enable,msi_vector_width[2:0],m_axi_awready,m_axi_wready,m_axi_bid[3:0],m_axi_bresp[1:0],m_axi_bvalid,m_axi_arready,m_axi_rid[3:0],m_axi_rdata[127:0],m_axi_rresp[1:0],m_axi_rlast,m_axi_rvalid,m_axi_awid[3:0],m_axi_awaddr[63:0],m_axi_awlen[7:0],m_axi_awsize[2:0],m_axi_awburst[1:0],m_axi_awprot[2:0],m_axi_awvalid,m_axi_awlock,m_axi_awcache[3:0],m_axi_wdata[127:0],m_axi_wstrb[15:0],m_axi_wlast,m_axi_wvalid,m_axi_bready,m_axi_arid[3:0],m_axi_araddr[63:0],m_axi_arlen[7:0],m_axi_arsize[2:0],m_axi_arburst[1:0],m_axi_arprot[2:0],m_axi_arvalid,m_axi_arlock,m_axi_arcache[3:0],m_axi_rready,m_axil_awaddr[31:0],m_axil_awprot[2:0],m_axil_awvalid,m_axil_awready,m_axil_wdata[31:0],m_axil_wstrb[3:0],m_axil_wvalid,m_axil_wready,m_axil_bvalid,m_axil_bresp[1:0],m_axil_bready,m_axil_araddr[31:0],m_axil_arprot[2:0],m_axil_arvalid,m_axil_arready,m_axil_rdata[31:0],m_axil_rresp[1:0],m_axil_rvalid,m_axil_rready";
attribute X_CORE_INFO : string;
attribute X_CORE_INFO of stub : architecture is "design_1_xdma_0_0_core_top,Vivado 2020.1";
begin
end;
