phoenix-pnp/ThunderScope/Firmware/Artix7_PCIe/dso_top/dso_top.srcs/sources_1/bd/design_1/ip/design_1_axi_crossbar_0_0/design_1_axi_crossbar_0_0_stub.v

// Copyright 1986-2020 Xilinx, Inc. All Rights Reserved.
// --------------------------------------------------------------------------------
// Tool Version: Vivado v.2020.1 (win64) Build 2902540 Wed May 27 19:54:49 MDT 2020
// Date        : Wed May  5 20:26:07 2021
// Host        : DESKTOP-J72MK93 running 64-bit major release  (build 9200)
// Command     : write_verilog -force -mode synth_stub
//               c:/Users/Aleksa/Documents/FPGA_Dev/Artix7_PCIe/dso_top/dso_top.srcs/sources_1/bd/design_1/ip/design_1_axi_crossbar_0_0/design_1_axi_crossbar_0_0_stub.v
// Design      : design_1_axi_crossbar_0_0
// Purpose     : Stub declaration of top-level module interface
// Device      : xc7a100tfgg484-2
// --------------------------------------------------------------------------------

// This empty module with port declaration file causes synthesis tools to infer a black box for IP.
// The synthesis directives are for Synopsys Synplify support to prevent IO buffer insertion.
// Please paste the declaration into a Verilog source file or add the file as an additional source.
(* X_CORE_INFO = "axi_crossbar_v2_1_22_axi_crossbar,Vivado 2020.1" *)
module design_1_axi_crossbar_0_0(aclk, aresetn, s_axi_awaddr, s_axi_awprot, 
  s_axi_awvalid, s_axi_awready, s_axi_wdata, s_axi_wstrb, s_axi_wvalid, s_axi_wready, 
  s_axi_bresp, s_axi_bvalid, s_axi_bready, s_axi_araddr, s_axi_arprot, s_axi_arvalid, 
  s_axi_arready, s_axi_rdata, s_axi_rresp, s_axi_rvalid, s_axi_rready, m_axi_awaddr, 
  m_axi_awprot, m_axi_awvalid, m_axi_awready, m_axi_wdata, m_axi_wstrb, m_axi_wvalid, 
  m_axi_wready, m_axi_bresp, m_axi_bvalid, m_axi_bready, m_axi_araddr, m_axi_arprot, 
  m_axi_arvalid, m_axi_arready, m_axi_rdata, m_axi_rresp, m_axi_rvalid, m_axi_rready)
/* synthesis syn_black_box black_box_pad_pin="aclk,aresetn,s_axi_awaddr[31:0],s_axi_awprot[2:0],s_axi_awvalid[0:0],s_axi_awready[0:0],s_axi_wdata[31:0],s_axi_wstrb[3:0],s_axi_wvalid[0:0],s_axi_wready[0:0],s_axi_bresp[1:0],s_axi_bvalid[0:0],s_axi_bready[0:0],s_axi_araddr[31:0],s_axi_arprot[2:0],s_axi_arvalid[0:0],s_axi_arready[0:0],s_axi_rdata[31:0],s_axi_rresp[1:0],s_axi_rvalid[0:0],s_axi_rready[0:0],m_axi_awaddr[95:0],m_axi_awprot[8:0],m_axi_awvalid[2:0],m_axi_awready[2:0],m_axi_wdata[95:0],m_axi_wstrb[11:0],m_axi_wvalid[2:0],m_axi_wready[2:0],m_axi_bresp[5:0],m_axi_bvalid[2:0],m_axi_bready[2:0],m_axi_araddr[95:0],m_axi_arprot[8:0],m_axi_arvalid[2:0],m_axi_arready[2:0],m_axi_rdata[95:0],m_axi_rresp[5:0],m_axi_rvalid[2:0],m_axi_rready[2:0]" */;
  input aclk;
  input aresetn;
  input [31:0]s_axi_awaddr;
  input [2:0]s_axi_awprot;
  input [0:0]s_axi_awvalid;
  output [0:0]s_axi_awready;
  input [31:0]s_axi_wdata;
  input [3:0]s_axi_wstrb;
  input [0:0]s_axi_wvalid;
  output [0:0]s_axi_wready;
  output [1:0]s_axi_bresp;
  output [0:0]s_axi_bvalid;
  input [0:0]s_axi_bready;
  input [31:0]s_axi_araddr;
  input [2:0]s_axi_arprot;
  input [0:0]s_axi_arvalid;
  output [0:0]s_axi_arready;
  output [31:0]s_axi_rdata;
  output [1:0]s_axi_rresp;
  output [0:0]s_axi_rvalid;
  input [0:0]s_axi_rready;
  output [95:0]m_axi_awaddr;
  output [8:0]m_axi_awprot;
  output [2:0]m_axi_awvalid;
  input [2:0]m_axi_awready;
  output [95:0]m_axi_wdata;
  output [11:0]m_axi_wstrb;
  output [2:0]m_axi_wvalid;
  input [2:0]m_axi_wready;
  input [5:0]m_axi_bresp;
  input [2:0]m_axi_bvalid;
  output [2:0]m_axi_bready;
  output [95:0]m_axi_araddr;
  output [8:0]m_axi_arprot;
  output [2:0]m_axi_arvalid;
  input [2:0]m_axi_arready;
  input [95:0]m_axi_rdata;
  input [5:0]m_axi_rresp;
  input [2:0]m_axi_rvalid;
  output [2:0]m_axi_rready;
endmodule
