phoenix-pnp/ThunderScope/Firmware/Artix7_PCIe/dso_top/dso_top.srcs/sources_1/bd/design_1/ip/design_1_axi_bram_ctrl_0_1/design_1_axi_bram_ctrl_0_1_sim_netlist.v

// Copyright 1986-2020 Xilinx, Inc. All Rights Reserved.
// --------------------------------------------------------------------------------
// Tool Version: Vivado v.2020.1 (win64) Build 2902540 Wed May 27 19:54:49 MDT 2020
// Date        : Sat May  8 17:44:59 2021
// Host        : DESKTOP-J72MK93 running 64-bit major release  (build 9200)
// Command     : write_verilog -force -mode funcsim
//               c:/Users/Aleksa/Documents/FPGA_Dev/Artix7_PCIe/dso_top/dso_top.srcs/sources_1/bd/design_1/ip/design_1_axi_bram_ctrl_0_1/design_1_axi_bram_ctrl_0_1_sim_netlist.v
// Design      : design_1_axi_bram_ctrl_0_1
// Purpose     : This verilog netlist is a functional simulation representation of the design and should not be modified
//               or synthesized. This netlist cannot be used for SDF annotated simulation.
// Device      : xc7a100tfgg484-2
// --------------------------------------------------------------------------------
`timescale 1 ps / 1 ps

(* CHECK_LICENSE_TYPE = "design_1_axi_bram_ctrl_0_1,axi_bram_ctrl,{}" *) (* downgradeipidentifiedwarnings = "yes" *) (* x_core_info = "axi_bram_ctrl,Vivado 2020.1" *) 
(* NotValidForBitStream *)
module design_1_axi_bram_ctrl_0_1
   (s_axi_aclk,
    s_axi_aresetn,
    s_axi_awid,
    s_axi_awaddr,
    s_axi_awlen,
    s_axi_awsize,
    s_axi_awburst,
    s_axi_awlock,
    s_axi_awcache,
    s_axi_awprot,
    s_axi_awvalid,
    s_axi_awready,
    s_axi_wdata,
    s_axi_wstrb,
    s_axi_wlast,
    s_axi_wvalid,
    s_axi_wready,
    s_axi_bid,
    s_axi_bresp,
    s_axi_bvalid,
    s_axi_bready,
    s_axi_arid,
    s_axi_araddr,
    s_axi_arlen,
    s_axi_arsize,
    s_axi_arburst,
    s_axi_arlock,
    s_axi_arcache,
    s_axi_arprot,
    s_axi_arvalid,
    s_axi_arready,
    s_axi_rid,
    s_axi_rdata,
    s_axi_rresp,
    s_axi_rlast,
    s_axi_rvalid,
    s_axi_rready,
    bram_rst_a,
    bram_clk_a,
    bram_en_a,
    bram_we_a,
    bram_addr_a,
    bram_wrdata_a,
    bram_rddata_a);
  (* x_interface_info = "xilinx.com:signal:clock:1.0 CLKIF CLK" *) (* x_interface_parameter = "XIL_INTERFACENAME CLKIF, ASSOCIATED_BUSIF S_AXI:S_AXI_CTRL, ASSOCIATED_RESET s_axi_aresetn, FREQ_HZ 125000000, FREQ_TOLERANCE_HZ 0, PHASE 0.000, CLK_DOMAIN design_1_xdma_0_0_axi_aclk, INSERT_VIP 0" *) input s_axi_aclk;
  (* x_interface_info = "xilinx.com:signal:reset:1.0 RSTIF RST" *) (* x_interface_parameter = "XIL_INTERFACENAME RSTIF, POLARITY ACTIVE_LOW, INSERT_VIP 0" *) input s_axi_aresetn;
  (* x_interface_info = "xilinx.com:interface:aximm:1.0 S_AXI AWID" *) (* x_interface_parameter = "XIL_INTERFACENAME S_AXI, DATA_WIDTH 128, PROTOCOL AXI4, FREQ_HZ 125000000, ID_WIDTH 4, ADDR_WIDTH 18, AWUSER_WIDTH 0, ARUSER_WIDTH 0, WUSER_WIDTH 0, RUSER_WIDTH 0, BUSER_WIDTH 0, READ_WRITE_MODE READ_WRITE, HAS_BURST 1, HAS_LOCK 1, HAS_PROT 1, HAS_CACHE 1, HAS_QOS 0, HAS_REGION 0, HAS_WSTRB 1, HAS_BRESP 1, HAS_RRESP 1, SUPPORTS_NARROW_BURST 0, NUM_READ_OUTSTANDING 32, NUM_WRITE_OUTSTANDING 32, MAX_BURST_LENGTH 256, PHASE 0.000, CLK_DOMAIN design_1_xdma_0_0_axi_aclk, NUM_READ_THREADS 1, NUM_WRITE_THREADS 1, RUSER_BITS_PER_BYTE 0, WUSER_BITS_PER_BYTE 0, INSERT_VIP 0" *) input [3:0]s_axi_awid;
  (* x_interface_info = "xilinx.com:interface:aximm:1.0 S_AXI AWADDR" *) input [17:0]s_axi_awaddr;
  (* x_interface_info = "xilinx.com:interface:aximm:1.0 S_AXI AWLEN" *) input [7:0]s_axi_awlen;
  (* x_interface_info = "xilinx.com:interface:aximm:1.0 S_AXI AWSIZE" *) input [2:0]s_axi_awsize;
  (* x_interface_info = "xilinx.com:interface:aximm:1.0 S_AXI AWBURST" *) input [1:0]s_axi_awburst;
  (* x_interface_info = "xilinx.com:interface:aximm:1.0 S_AXI AWLOCK" *) input s_axi_awlock;
  (* x_interface_info = "xilinx.com:interface:aximm:1.0 S_AXI AWCACHE" *) input [3:0]s_axi_awcache;
  (* x_interface_info = "xilinx.com:interface:aximm:1.0 S_AXI AWPROT" *) input [2:0]s_axi_awprot;
  (* x_interface_info = "xilinx.com:interface:aximm:1.0 S_AXI AWVALID" *) input s_axi_awvalid;
  (* x_interface_info = "xilinx.com:interface:aximm:1.0 S_AXI AWREADY" *) output s_axi_awready;
  (* x_interface_info = "xilinx.com:interface:aximm:1.0 S_AXI WDATA" *) input [127:0]s_axi_wdata;
  (* x_interface_info = "xilinx.com:interface:aximm:1.0 S_AXI WSTRB" *) input [15:0]s_axi_wstrb;
  (* x_interface_info = "xilinx.com:interface:aximm:1.0 S_AXI WLAST" *) input s_axi_wlast;
  (* x_interface_info = "xilinx.com:interface:aximm:1.0 S_AXI WVALID" *) input s_axi_wvalid;
  (* x_interface_info = "xilinx.com:interface:aximm:1.0 S_AXI WREADY" *) output s_axi_wready;
  (* x_interface_info = "xilinx.com:interface:aximm:1.0 S_AXI BID" *) output [3:0]s_axi_bid;
  (* x_interface_info = "xilinx.com:interface:aximm:1.0 S_AXI BRESP" *) output [1:0]s_axi_bresp;
  (* x_interface_info = "xilinx.com:interface:aximm:1.0 S_AXI BVALID" *) output s_axi_bvalid;
  (* x_interface_info = "xilinx.com:interface:aximm:1.0 S_AXI BREADY" *) input s_axi_bready;
  (* x_interface_info = "xilinx.com:interface:aximm:1.0 S_AXI ARID" *) input [3:0]s_axi_arid;
  (* x_interface_info = "xilinx.com:interface:aximm:1.0 S_AXI ARADDR" *) input [17:0]s_axi_araddr;
  (* x_interface_info = "xilinx.com:interface:aximm:1.0 S_AXI ARLEN" *) input [7:0]s_axi_arlen;
  (* x_interface_info = "xilinx.com:interface:aximm:1.0 S_AXI ARSIZE" *) input [2:0]s_axi_arsize;
  (* x_interface_info = "xilinx.com:interface:aximm:1.0 S_AXI ARBURST" *) input [1:0]s_axi_arburst;
  (* x_interface_info = "xilinx.com:interface:aximm:1.0 S_AXI ARLOCK" *) input s_axi_arlock;
  (* x_interface_info = "xilinx.com:interface:aximm:1.0 S_AXI ARCACHE" *) input [3:0]s_axi_arcache;
  (* x_interface_info = "xilinx.com:interface:aximm:1.0 S_AXI ARPROT" *) input [2:0]s_axi_arprot;
  (* x_interface_info = "xilinx.com:interface:aximm:1.0 S_AXI ARVALID" *) input s_axi_arvalid;
  (* x_interface_info = "xilinx.com:interface:aximm:1.0 S_AXI ARREADY" *) output s_axi_arready;
  (* x_interface_info = "xilinx.com:interface:aximm:1.0 S_AXI RID" *) output [3:0]s_axi_rid;
  (* x_interface_info = "xilinx.com:interface:aximm:1.0 S_AXI RDATA" *) output [127:0]s_axi_rdata;
  (* x_interface_info = "xilinx.com:interface:aximm:1.0 S_AXI RRESP" *) output [1:0]s_axi_rresp;
  (* x_interface_info = "xilinx.com:interface:aximm:1.0 S_AXI RLAST" *) output s_axi_rlast;
  (* x_interface_info = "xilinx.com:interface:aximm:1.0 S_AXI RVALID" *) output s_axi_rvalid;
  (* x_interface_info = "xilinx.com:interface:aximm:1.0 S_AXI RREADY" *) input s_axi_rready;
  (* x_interface_info = "xilinx.com:interface:bram:1.0 BRAM_PORTA RST" *) (* x_interface_parameter = "XIL_INTERFACENAME BRAM_PORTA, MASTER_TYPE BRAM_CTRL, MEM_SIZE 262144, MEM_WIDTH 128, MEM_ECC NONE, READ_WRITE_MODE READ_WRITE, READ_LATENCY 1" *) output bram_rst_a;
  (* x_interface_info = "xilinx.com:interface:bram:1.0 BRAM_PORTA CLK" *) output bram_clk_a;
  (* x_interface_info = "xilinx.com:interface:bram:1.0 BRAM_PORTA EN" *) output bram_en_a;
  (* x_interface_info = "xilinx.com:interface:bram:1.0 BRAM_PORTA WE" *) output [15:0]bram_we_a;
  (* x_interface_info = "xilinx.com:interface:bram:1.0 BRAM_PORTA ADDR" *) output [17:0]bram_addr_a;
  (* x_interface_info = "xilinx.com:interface:bram:1.0 BRAM_PORTA DIN" *) output [127:0]bram_wrdata_a;
  (* x_interface_info = "xilinx.com:interface:bram:1.0 BRAM_PORTA DOUT" *) input [127:0]bram_rddata_a;

  wire [17:0]bram_addr_a;
  wire bram_clk_a;
  wire bram_en_a;
  wire [127:0]bram_rddata_a;
  wire bram_rst_a;
  wire [15:0]bram_we_a;
  wire [127:0]bram_wrdata_a;
  wire s_axi_aclk;
  wire [17:0]s_axi_araddr;
  wire [1:0]s_axi_arburst;
  wire [3:0]s_axi_arcache;
  wire s_axi_aresetn;
  wire [3:0]s_axi_arid;
  wire [7:0]s_axi_arlen;
  wire s_axi_arlock;
  wire [2:0]s_axi_arprot;
  wire s_axi_arready;
  wire [2:0]s_axi_arsize;
  wire s_axi_arvalid;
  wire [17:0]s_axi_awaddr;
  wire [1:0]s_axi_awburst;
  wire [3:0]s_axi_awcache;
  wire [3:0]s_axi_awid;
  wire [7:0]s_axi_awlen;
  wire s_axi_awlock;
  wire [2:0]s_axi_awprot;
  wire s_axi_awready;
  wire [2:0]s_axi_awsize;
  wire s_axi_awvalid;
  wire [3:0]s_axi_bid;
  wire s_axi_bready;
  wire [1:0]s_axi_bresp;
  wire s_axi_bvalid;
  wire [127:0]s_axi_rdata;
  wire [3:0]s_axi_rid;
  wire s_axi_rlast;
  wire s_axi_rready;
  wire [1:0]s_axi_rresp;
  wire s_axi_rvalid;
  wire [127:0]s_axi_wdata;
  wire s_axi_wlast;
  wire s_axi_wready;
  wire [15:0]s_axi_wstrb;
  wire s_axi_wvalid;
  wire NLW_U0_bram_clk_b_UNCONNECTED;
  wire NLW_U0_bram_en_b_UNCONNECTED;
  wire NLW_U0_bram_rst_b_UNCONNECTED;
  wire NLW_U0_ecc_interrupt_UNCONNECTED;
  wire NLW_U0_ecc_ue_UNCONNECTED;
  wire NLW_U0_s_axi_ctrl_arready_UNCONNECTED;
  wire NLW_U0_s_axi_ctrl_awready_UNCONNECTED;
  wire NLW_U0_s_axi_ctrl_bvalid_UNCONNECTED;
  wire NLW_U0_s_axi_ctrl_rvalid_UNCONNECTED;
  wire NLW_U0_s_axi_ctrl_wready_UNCONNECTED;
  wire [17:0]NLW_U0_bram_addr_b_UNCONNECTED;
  wire [15:0]NLW_U0_bram_we_b_UNCONNECTED;
  wire [127:0]NLW_U0_bram_wrdata_b_UNCONNECTED;
  wire [1:0]NLW_U0_s_axi_ctrl_bresp_UNCONNECTED;
  wire [31:0]NLW_U0_s_axi_ctrl_rdata_UNCONNECTED;
  wire [1:0]NLW_U0_s_axi_ctrl_rresp_UNCONNECTED;

  (* C_BRAM_ADDR_WIDTH = "14" *) 
  (* C_BRAM_INST_MODE = "EXTERNAL" *) 
  (* C_ECC = "0" *) 
  (* C_ECC_ONOFF_RESET_VALUE = "0" *) 
  (* C_ECC_TYPE = "0" *) 
  (* C_FAMILY = "artix7" *) 
  (* C_FAULT_INJECT = "0" *) 
  (* C_MEMORY_DEPTH = "16384" *) 
  (* C_RD_CMD_OPTIMIZATION = "1" *) 
  (* C_READ_LATENCY = "1" *) 
  (* C_SINGLE_PORT_BRAM = "1" *) 
  (* C_S_AXI_ADDR_WIDTH = "18" *) 
  (* C_S_AXI_CTRL_ADDR_WIDTH = "32" *) 
  (* C_S_AXI_CTRL_DATA_WIDTH = "32" *) 
  (* C_S_AXI_DATA_WIDTH = "128" *) 
  (* C_S_AXI_ID_WIDTH = "4" *) 
  (* C_S_AXI_PROTOCOL = "AXI4" *) 
  (* C_S_AXI_SUPPORTS_NARROW_BURST = "0" *) 
  (* downgradeipidentifiedwarnings = "yes" *) 
  design_1_axi_bram_ctrl_0_1_axi_bram_ctrl U0
       (.bram_addr_a(bram_addr_a),
        .bram_addr_b(NLW_U0_bram_addr_b_UNCONNECTED[17:0]),
        .bram_clk_a(bram_clk_a),
        .bram_clk_b(NLW_U0_bram_clk_b_UNCONNECTED),
        .bram_en_a(bram_en_a),
        .bram_en_b(NLW_U0_bram_en_b_UNCONNECTED),
        .bram_rddata_a(bram_rddata_a),
        .bram_rddata_b({1'b0,1'b0,1'b0,1'b0,1'b0,1'b0,1'b0,1'b0,1'b0,1'b0,1'b0,1'b0,1'b0,1'b0,1'b0,1'b0,1'b0,1'b0,1'b0,1'b0,1'b0,1'b0,1'b0,1'b0,1'b0,1'b0,1'b0,1'b0,1'b0,1'b0,1'b0,1'b0,1'b0,1'b0,1'b0,1'b0,1'b0,1'b0,1'b0,1'b0,1'b0,1'b0,1'b0,1'b0,1'b0,1'b0,1'b0,1'b0,1'b0,1'b0,1'b0,1'b0,1'b0,1'b0,1'b0,1'b0,1'b0,1'b0,1'b0,1'b0,1'b0,1'b0,1'b0,1'b0,1'b0,1'b0,1'b0,1'b0,1'b0,1'b0,1'b0,1'b0,1'b0,1'b0,1'b0,1'b0,1'b0,1'b0,1'b0,1'b0,1'b0,1'b0,1'b0,1'b0,1'b0,1'b0,1'b0,1'b0,1'b0,1'b0,1'b0,1'b0,1'b0,1'b0,1'b0,1'b0,1'b0,1'b0,1'b0,1'b0,1'b0,1'b0,1'b0,1'b0,1'b0,1'b0,1'b0,1'b0,1'b0,1'b0,1'b0,1'b0,1'b0,1'b0,1'b0,1'b0,1'b0,1'b0,1'b0,1'b0,1'b0,1'b0,1'b0,1'b0,1'b0,1'b0,1'b0,1'b0}),
        .bram_rst_a(bram_rst_a),
        .bram_rst_b(NLW_U0_bram_rst_b_UNCONNECTED),
        .bram_we_a(bram_we_a),
        .bram_we_b(NLW_U0_bram_we_b_UNCONNECTED[15:0]),
        .bram_wrdata_a(bram_wrdata_a),
        .bram_wrdata_b(NLW_U0_bram_wrdata_b_UNCONNECTED[127:0]),
        .ecc_interrupt(NLW_U0_ecc_interrupt_UNCONNECTED),
        .ecc_ue(NLW_U0_ecc_ue_UNCONNECTED),
        .s_axi_aclk(s_axi_aclk),
        .s_axi_araddr(s_axi_araddr),
        .s_axi_arburst(s_axi_arburst),
        .s_axi_arcache(s_axi_arcache),
        .s_axi_aresetn(s_axi_aresetn),
        .s_axi_arid(s_axi_arid),
        .s_axi_arlen(s_axi_arlen),
        .s_axi_arlock(s_axi_arlock),
        .s_axi_arprot(s_axi_arprot),
        .s_axi_arready(s_axi_arready),
        .s_axi_arsize(s_axi_arsize),
        .s_axi_arvalid(s_axi_arvalid),
        .s_axi_awaddr(s_axi_awaddr),
        .s_axi_awburst(s_axi_awburst),
        .s_axi_awcache(s_axi_awcache),
        .s_axi_awid(s_axi_awid),
        .s_axi_awlen(s_axi_awlen),
        .s_axi_awlock(s_axi_awlock),
        .s_axi_awprot(s_axi_awprot),
        .s_axi_awready(s_axi_awready),
        .s_axi_awsize(s_axi_awsize),
        .s_axi_awvalid(s_axi_awvalid),
        .s_axi_bid(s_axi_bid),
        .s_axi_bready(s_axi_bready),
        .s_axi_bresp(s_axi_bresp),
        .s_axi_bvalid(s_axi_bvalid),
        .s_axi_ctrl_araddr({1'b0,1'b0,1'b0,1'b0,1'b0,1'b0,1'b0,1'b0,1'b0,1'b0,1'b0,1'b0,1'b0,1'b0,1'b0,1'b0,1'b0,1'b0,1'b0,1'b0,1'b0,1'b0,1'b0,1'b0,1'b0,1'b0,1'b0,1'b0,1'b0,1'b0,1'b0,1'b0}),
        .s_axi_ctrl_arready(NLW_U0_s_axi_ctrl_arready_UNCONNECTED),
        .s_axi_ctrl_arvalid(1'b0),
        .s_axi_ctrl_awaddr({1'b0,1'b0,1'b0,1'b0,1'b0,1'b0,1'b0,1'b0,1'b0,1'b0,1'b0,1'b0,1'b0,1'b0,1'b0,1'b0,1'b0,1'b0,1'b0,1'b0,1'b0,1'b0,1'b0,1'b0,1'b0,1'b0,1'b0,1'b0,1'b0,1'b0,1'b0,1'b0}),
        .s_axi_ctrl_awready(NLW_U0_s_axi_ctrl_awready_UNCONNECTED),
        .s_axi_ctrl_awvalid(1'b0),
        .s_axi_ctrl_bready(1'b0),
        .s_axi_ctrl_bresp(NLW_U0_s_axi_ctrl_bresp_UNCONNECTED[1:0]),
        .s_axi_ctrl_bvalid(NLW_U0_s_axi_ctrl_bvalid_UNCONNECTED),
        .s_axi_ctrl_rdata(NLW_U0_s_axi_ctrl_rdata_UNCONNECTED[31:0]),
        .s_axi_ctrl_rready(1'b0),
        .s_axi_ctrl_rresp(NLW_U0_s_axi_ctrl_rresp_UNCONNECTED[1:0]),
        .s_axi_ctrl_rvalid(NLW_U0_s_axi_ctrl_rvalid_UNCONNECTED),
        .s_axi_ctrl_wdata({1'b0,1'b0,1'b0,1'b0,1'b0,1'b0,1'b0,1'b0,1'b0,1'b0,1'b0,1'b0,1'b0,1'b0,1'b0,1'b0,1'b0,1'b0,1'b0,1'b0,1'b0,1'b0,1'b0,1'b0,1'b0,1'b0,1'b0,1'b0,1'b0,1'b0,1'b0,1'b0}),
        .s_axi_ctrl_wready(NLW_U0_s_axi_ctrl_wready_UNCONNECTED),
        .s_axi_ctrl_wvalid(1'b0),
        .s_axi_rdata(s_axi_rdata),
        .s_axi_rid(s_axi_rid),
        .s_axi_rlast(s_axi_rlast),
        .s_axi_rready(s_axi_rready),
        .s_axi_rresp(s_axi_rresp),
        .s_axi_rvalid(s_axi_rvalid),
        .s_axi_wdata(s_axi_wdata),
        .s_axi_wlast(s_axi_wlast),
        .s_axi_wready(s_axi_wready),
        .s_axi_wstrb(s_axi_wstrb),
        .s_axi_wvalid(s_axi_wvalid));
endmodule

(* ORIG_REF_NAME = "SRL_FIFO" *) 
module design_1_axi_bram_ctrl_0_1_SRL_FIFO
   (D,
    bid_gets_fifo_load,
    E,
    bvalid_cnt_inc,
    Data_Exists_DFF_0,
    s_axi_aclk,
    s_axi_awid,
    AW2Arb_BVALID_Cnt,
    bid_gets_fifo_load_d1_reg,
    Data_Exists_DFF_1,
    Arb2AW_Active,
    aw_active_re,
    bid_gets_fifo_load_d1,
    Data_Exists_DFF_2,
    s_axi_bready,
    s_axi_wlast,
    \GEN_WDATA_SM_NO_ECC_SNG_REG_WREADY.clr_bram_we_reg ,
    s_axi_wvalid,
    \GEN_WDATA_SM_NO_ECC_SNG_REG_WREADY.clr_bram_we_reg_0 ,
    axi_wdata_full_reg,
    axi_wr_burst);
  output [3:0]D;
  output bid_gets_fifo_load;
  output [0:0]E;
  output bvalid_cnt_inc;
  input Data_Exists_DFF_0;
  input s_axi_aclk;
  input [3:0]s_axi_awid;
  input [2:0]AW2Arb_BVALID_Cnt;
  input bid_gets_fifo_load_d1_reg;
  input Data_Exists_DFF_1;
  input Arb2AW_Active;
  input aw_active_re;
  input bid_gets_fifo_load_d1;
  input Data_Exists_DFF_2;
  input s_axi_bready;
  input s_axi_wlast;
  input \GEN_WDATA_SM_NO_ECC_SNG_REG_WREADY.clr_bram_we_reg ;
  input s_axi_wvalid;
  input \GEN_WDATA_SM_NO_ECC_SNG_REG_WREADY.clr_bram_we_reg_0 ;
  input axi_wdata_full_reg;
  input axi_wr_burst;

  wire [2:0]AW2Arb_BVALID_Cnt;
  wire \Addr_Counters[0].FDRE_I_n_0 ;
  wire \Addr_Counters[0].MUXCY_L_I_i_3_n_0 ;
  wire \Addr_Counters[1].FDRE_I_n_0 ;
  wire \Addr_Counters[2].FDRE_I_n_0 ;
  wire \Addr_Counters[3].FDRE_I_n_0 ;
  wire \Addr_Counters[3].XORCY_I_i_1_n_0 ;
  wire Arb2AW_Active;
  wire CI;
  wire [3:0]D;
  wire D_0;
  wire Data_Exists_DFF_0;
  wire Data_Exists_DFF_1;
  wire Data_Exists_DFF_2;
  wire Data_Exists_DFF_i_2_n_0;
  wire Data_Exists_DFF_i_3_n_0;
  wire [0:0]E;
  wire \GEN_WDATA_SM_NO_ECC_SNG_REG_WREADY.clr_bram_we_reg ;
  wire \GEN_WDATA_SM_NO_ECC_SNG_REG_WREADY.clr_bram_we_reg_0 ;
  wire S;
  wire S0_out;
  wire S1_out;
  wire addr_cy_1;
  wire addr_cy_2;
  wire addr_cy_3;
  wire aw_active_re;
  wire \axi_bid_int[3]_i_3_n_0 ;
  wire \axi_bid_int[3]_i_5_n_0 ;
  wire \axi_bid_int[3]_i_6_n_0 ;
  wire axi_wdata_full_reg;
  wire axi_wr_burst;
  wire bid_fifo_not_empty;
  wire [3:0]bid_fifo_rd;
  wire bid_gets_fifo_load;
  wire bid_gets_fifo_load_d1;
  wire bid_gets_fifo_load_d1_reg;
  wire bvalid_cnt_inc;
  wire s_axi_aclk;
  wire [3:0]s_axi_awid;
  wire s_axi_bready;
  wire s_axi_wlast;
  wire s_axi_wvalid;
  wire sum_A_0;
  wire sum_A_1;
  wire sum_A_2;
  wire sum_A_3;
  wire [3:3]\NLW_Addr_Counters[0].MUXCY_L_I_CARRY4_CO_UNCONNECTED ;
  wire [3:3]\NLW_Addr_Counters[0].MUXCY_L_I_CARRY4_DI_UNCONNECTED ;

  (* BOX_TYPE = "PRIMITIVE" *) 
  FDRE #(
    .INIT(1'b0),
    .IS_C_INVERTED(1'b0),
    .IS_D_INVERTED(1'b0),
    .IS_R_INVERTED(1'b0)) 
    \Addr_Counters[0].FDRE_I 
       (.C(s_axi_aclk),
        .CE(bid_fifo_not_empty),
        .D(sum_A_3),
        .Q(\Addr_Counters[0].FDRE_I_n_0 ),
        .R(Data_Exists_DFF_0));
  (* BOX_TYPE = "PRIMITIVE" *) 
  (* OPT_MODIFIED = "MLO" *) 
  (* XILINX_LEGACY_PRIM = "(MUXCY,XORCY)" *) 
  (* XILINX_TRANSFORM_PINMAP = "LO:O" *) 
  CARRY4 \Addr_Counters[0].MUXCY_L_I_CARRY4 
       (.CI(1'b0),
        .CO({\NLW_Addr_Counters[0].MUXCY_L_I_CARRY4_CO_UNCONNECTED [3],addr_cy_1,addr_cy_2,addr_cy_3}),
        .CYINIT(CI),
        .DI({\NLW_Addr_Counters[0].MUXCY_L_I_CARRY4_DI_UNCONNECTED [3],\Addr_Counters[2].FDRE_I_n_0 ,\Addr_Counters[1].FDRE_I_n_0 ,\Addr_Counters[0].FDRE_I_n_0 }),
        .O({sum_A_0,sum_A_1,sum_A_2,sum_A_3}),
        .S({\Addr_Counters[3].XORCY_I_i_1_n_0 ,S0_out,S1_out,S}));
  LUT6 #(
    .INIT(64'h0000FFFFFFFE0000)) 
    \Addr_Counters[0].MUXCY_L_I_i_1 
       (.I0(\Addr_Counters[3].FDRE_I_n_0 ),
        .I1(\Addr_Counters[2].FDRE_I_n_0 ),
        .I2(\Addr_Counters[1].FDRE_I_n_0 ),
        .I3(aw_active_re),
        .I4(\axi_bid_int[3]_i_3_n_0 ),
        .I5(\Addr_Counters[0].FDRE_I_n_0 ),
        .O(S));
  LUT6 #(
    .INIT(64'h2AAAAAAAAAAAAAAA)) 
    \Addr_Counters[0].MUXCY_L_I_i_2 
       (.I0(aw_active_re),
        .I1(\Addr_Counters[1].FDRE_I_n_0 ),
        .I2(\Addr_Counters[0].FDRE_I_n_0 ),
        .I3(\Addr_Counters[3].FDRE_I_n_0 ),
        .I4(\Addr_Counters[2].FDRE_I_n_0 ),
        .I5(\Addr_Counters[0].MUXCY_L_I_i_3_n_0 ),
        .O(CI));
  LUT6 #(
    .INIT(64'h7577777755575757)) 
    \Addr_Counters[0].MUXCY_L_I_i_3 
       (.I0(bid_fifo_not_empty),
        .I1(bid_gets_fifo_load_d1),
        .I2(\axi_bid_int[3]_i_6_n_0 ),
        .I3(Data_Exists_DFF_2),
        .I4(s_axi_bready),
        .I5(\axi_bid_int[3]_i_5_n_0 ),
        .O(\Addr_Counters[0].MUXCY_L_I_i_3_n_0 ));
  (* BOX_TYPE = "PRIMITIVE" *) 
  FDRE #(
    .INIT(1'b0),
    .IS_C_INVERTED(1'b0),
    .IS_D_INVERTED(1'b0),
    .IS_R_INVERTED(1'b0)) 
    \Addr_Counters[1].FDRE_I 
       (.C(s_axi_aclk),
        .CE(bid_fifo_not_empty),
        .D(sum_A_2),
        .Q(\Addr_Counters[1].FDRE_I_n_0 ),
        .R(Data_Exists_DFF_0));
  LUT6 #(
    .INIT(64'h0000FFFFFFFE0000)) 
    \Addr_Counters[1].MUXCY_L_I_i_1 
       (.I0(\Addr_Counters[3].FDRE_I_n_0 ),
        .I1(\Addr_Counters[0].FDRE_I_n_0 ),
        .I2(\Addr_Counters[2].FDRE_I_n_0 ),
        .I3(aw_active_re),
        .I4(\axi_bid_int[3]_i_3_n_0 ),
        .I5(\Addr_Counters[1].FDRE_I_n_0 ),
        .O(S1_out));
  (* BOX_TYPE = "PRIMITIVE" *) 
  FDRE #(
    .INIT(1'b0),
    .IS_C_INVERTED(1'b0),
    .IS_D_INVERTED(1'b0),
    .IS_R_INVERTED(1'b0)) 
    \Addr_Counters[2].FDRE_I 
       (.C(s_axi_aclk),
        .CE(bid_fifo_not_empty),
        .D(sum_A_1),
        .Q(\Addr_Counters[2].FDRE_I_n_0 ),
        .R(Data_Exists_DFF_0));
  LUT6 #(
    .INIT(64'h0000FFFFFFFE0000)) 
    \Addr_Counters[2].MUXCY_L_I_i_1 
       (.I0(\Addr_Counters[3].FDRE_I_n_0 ),
        .I1(\Addr_Counters[0].FDRE_I_n_0 ),
        .I2(\Addr_Counters[1].FDRE_I_n_0 ),
        .I3(aw_active_re),
        .I4(\axi_bid_int[3]_i_3_n_0 ),
        .I5(\Addr_Counters[2].FDRE_I_n_0 ),
        .O(S0_out));
  (* BOX_TYPE = "PRIMITIVE" *) 
  FDRE #(
    .INIT(1'b0),
    .IS_C_INVERTED(1'b0),
    .IS_D_INVERTED(1'b0),
    .IS_R_INVERTED(1'b0)) 
    \Addr_Counters[3].FDRE_I 
       (.C(s_axi_aclk),
        .CE(bid_fifo_not_empty),
        .D(sum_A_0),
        .Q(\Addr_Counters[3].FDRE_I_n_0 ),
        .R(Data_Exists_DFF_0));
  LUT6 #(
    .INIT(64'h0000FFFFFFFE0000)) 
    \Addr_Counters[3].XORCY_I_i_1 
       (.I0(\Addr_Counters[0].FDRE_I_n_0 ),
        .I1(\Addr_Counters[2].FDRE_I_n_0 ),
        .I2(\Addr_Counters[1].FDRE_I_n_0 ),
        .I3(aw_active_re),
        .I4(\axi_bid_int[3]_i_3_n_0 ),
        .I5(\Addr_Counters[3].FDRE_I_n_0 ),
        .O(\Addr_Counters[3].XORCY_I_i_1_n_0 ));
  (* BOX_TYPE = "PRIMITIVE" *) 
  (* XILINX_LEGACY_PRIM = "FDR" *) 
  FDRE #(
    .INIT(1'b0)) 
    Data_Exists_DFF
       (.C(s_axi_aclk),
        .CE(1'b1),
        .D(D_0),
        .Q(bid_fifo_not_empty),
        .R(Data_Exists_DFF_0));
  LUT5 #(
    .INIT(32'hFFF20022)) 
    Data_Exists_DFF_i_1
       (.I0(Arb2AW_Active),
        .I1(Data_Exists_DFF_1),
        .I2(Data_Exists_DFF_i_2_n_0),
        .I3(Data_Exists_DFF_i_3_n_0),
        .I4(bid_fifo_not_empty),
        .O(D_0));
  LUT5 #(
    .INIT(32'h00070F07)) 
    Data_Exists_DFF_i_2
       (.I0(s_axi_bready),
        .I1(Data_Exists_DFF_2),
        .I2(bid_gets_fifo_load_d1),
        .I3(\axi_bid_int[3]_i_6_n_0 ),
        .I4(bvalid_cnt_inc),
        .O(Data_Exists_DFF_i_2_n_0));
  LUT4 #(
    .INIT(16'hFFFE)) 
    Data_Exists_DFF_i_3
       (.I0(\Addr_Counters[3].FDRE_I_n_0 ),
        .I1(\Addr_Counters[0].FDRE_I_n_0 ),
        .I2(\Addr_Counters[2].FDRE_I_n_0 ),
        .I3(\Addr_Counters[1].FDRE_I_n_0 ),
        .O(Data_Exists_DFF_i_3_n_0));
  (* BOX_TYPE = "PRIMITIVE" *) 
  (* srl_bus_name = "U0/\gext_inst.abcv4_0_ext_inst/GEN_AXI4.I_FULL_AXI/I_WR_CHNL/BID_FIFO/FIFO_RAM " *) 
  (* srl_name = "U0/\gext_inst.abcv4_0_ext_inst/GEN_AXI4.I_FULL_AXI/I_WR_CHNL/BID_FIFO/FIFO_RAM[0].SRL16E_I " *) 
  SRL16E #(
    .INIT(16'h0000),
    .IS_CLK_INVERTED(1'b0)) 
    \FIFO_RAM[0].SRL16E_I 
       (.A0(\Addr_Counters[0].FDRE_I_n_0 ),
        .A1(\Addr_Counters[1].FDRE_I_n_0 ),
        .A2(\Addr_Counters[2].FDRE_I_n_0 ),
        .A3(\Addr_Counters[3].FDRE_I_n_0 ),
        .CE(CI),
        .CLK(s_axi_aclk),
        .D(s_axi_awid[3]),
        .Q(bid_fifo_rd[3]));
  (* BOX_TYPE = "PRIMITIVE" *) 
  (* srl_bus_name = "U0/\gext_inst.abcv4_0_ext_inst/GEN_AXI4.I_FULL_AXI/I_WR_CHNL/BID_FIFO/FIFO_RAM " *) 
  (* srl_name = "U0/\gext_inst.abcv4_0_ext_inst/GEN_AXI4.I_FULL_AXI/I_WR_CHNL/BID_FIFO/FIFO_RAM[1].SRL16E_I " *) 
  SRL16E #(
    .INIT(16'h0000),
    .IS_CLK_INVERTED(1'b0)) 
    \FIFO_RAM[1].SRL16E_I 
       (.A0(\Addr_Counters[0].FDRE_I_n_0 ),
        .A1(\Addr_Counters[1].FDRE_I_n_0 ),
        .A2(\Addr_Counters[2].FDRE_I_n_0 ),
        .A3(\Addr_Counters[3].FDRE_I_n_0 ),
        .CE(CI),
        .CLK(s_axi_aclk),
        .D(s_axi_awid[2]),
        .Q(bid_fifo_rd[2]));
  (* BOX_TYPE = "PRIMITIVE" *) 
  (* srl_bus_name = "U0/\gext_inst.abcv4_0_ext_inst/GEN_AXI4.I_FULL_AXI/I_WR_CHNL/BID_FIFO/FIFO_RAM " *) 
  (* srl_name = "U0/\gext_inst.abcv4_0_ext_inst/GEN_AXI4.I_FULL_AXI/I_WR_CHNL/BID_FIFO/FIFO_RAM[2].SRL16E_I " *) 
  SRL16E #(
    .INIT(16'h0000),
    .IS_CLK_INVERTED(1'b0)) 
    \FIFO_RAM[2].SRL16E_I 
       (.A0(\Addr_Counters[0].FDRE_I_n_0 ),
        .A1(\Addr_Counters[1].FDRE_I_n_0 ),
        .A2(\Addr_Counters[2].FDRE_I_n_0 ),
        .A3(\Addr_Counters[3].FDRE_I_n_0 ),
        .CE(CI),
        .CLK(s_axi_aclk),
        .D(s_axi_awid[1]),
        .Q(bid_fifo_rd[1]));
  (* BOX_TYPE = "PRIMITIVE" *) 
  (* srl_bus_name = "U0/\gext_inst.abcv4_0_ext_inst/GEN_AXI4.I_FULL_AXI/I_WR_CHNL/BID_FIFO/FIFO_RAM " *) 
  (* srl_name = "U0/\gext_inst.abcv4_0_ext_inst/GEN_AXI4.I_FULL_AXI/I_WR_CHNL/BID_FIFO/FIFO_RAM[3].SRL16E_I " *) 
  SRL16E #(
    .INIT(16'h0000),
    .IS_CLK_INVERTED(1'b0)) 
    \FIFO_RAM[3].SRL16E_I 
       (.A0(\Addr_Counters[0].FDRE_I_n_0 ),
        .A1(\Addr_Counters[1].FDRE_I_n_0 ),
        .A2(\Addr_Counters[2].FDRE_I_n_0 ),
        .A3(\Addr_Counters[3].FDRE_I_n_0 ),
        .CE(CI),
        .CLK(s_axi_aclk),
        .D(s_axi_awid[0]),
        .Q(bid_fifo_rd[0]));
  LUT5 #(
    .INIT(32'h0000FF80)) 
    \GEN_WDATA_SM_NO_ECC_SNG_REG_WREADY.clr_bram_we_i_1 
       (.I0(s_axi_wlast),
        .I1(\GEN_WDATA_SM_NO_ECC_SNG_REG_WREADY.clr_bram_we_reg ),
        .I2(s_axi_wvalid),
        .I3(Arb2AW_Active),
        .I4(\axi_bid_int[3]_i_5_n_0 ),
        .O(bvalid_cnt_inc));
  (* SOFT_HLUTNM = "soft_lutpair37" *) 
  LUT3 #(
    .INIT(8'hB8)) 
    \axi_bid_int[0]_i_1 
       (.I0(s_axi_awid[0]),
        .I1(bid_gets_fifo_load),
        .I2(bid_fifo_rd[0]),
        .O(D[0]));
  (* SOFT_HLUTNM = "soft_lutpair37" *) 
  LUT3 #(
    .INIT(8'hB8)) 
    \axi_bid_int[1]_i_1 
       (.I0(s_axi_awid[1]),
        .I1(bid_gets_fifo_load),
        .I2(bid_fifo_rd[1]),
        .O(D[1]));
  (* SOFT_HLUTNM = "soft_lutpair36" *) 
  LUT3 #(
    .INIT(8'hB8)) 
    \axi_bid_int[2]_i_1 
       (.I0(s_axi_awid[2]),
        .I1(bid_gets_fifo_load),
        .I2(bid_fifo_rd[2]),
        .O(D[2]));
  LUT5 #(
    .INIT(32'hAAAAABAA)) 
    \axi_bid_int[3]_i_1 
       (.I0(\axi_bid_int[3]_i_3_n_0 ),
        .I1(bid_gets_fifo_load_d1_reg),
        .I2(Data_Exists_DFF_1),
        .I3(Arb2AW_Active),
        .I4(\axi_bid_int[3]_i_5_n_0 ),
        .O(E));
  (* SOFT_HLUTNM = "soft_lutpair36" *) 
  LUT3 #(
    .INIT(8'hB8)) 
    \axi_bid_int[3]_i_2 
       (.I0(s_axi_awid[3]),
        .I1(bid_gets_fifo_load),
        .I2(bid_fifo_rd[3]),
        .O(D[3]));
  LUT6 #(
    .INIT(64'hAA8AAA80AA80AA80)) 
    \axi_bid_int[3]_i_3 
       (.I0(bid_fifo_not_empty),
        .I1(bvalid_cnt_inc),
        .I2(\axi_bid_int[3]_i_6_n_0 ),
        .I3(bid_gets_fifo_load_d1),
        .I4(Data_Exists_DFF_2),
        .I5(s_axi_bready),
        .O(\axi_bid_int[3]_i_3_n_0 ));
  LUT6 #(
    .INIT(64'h00F7D5F7F7F7F7F7)) 
    \axi_bid_int[3]_i_5 
       (.I0(\GEN_WDATA_SM_NO_ECC_SNG_REG_WREADY.clr_bram_we_reg_0 ),
        .I1(axi_wdata_full_reg),
        .I2(axi_wr_burst),
        .I3(s_axi_wlast),
        .I4(\GEN_WDATA_SM_NO_ECC_SNG_REG_WREADY.clr_bram_we_reg ),
        .I5(s_axi_wvalid),
        .O(\axi_bid_int[3]_i_5_n_0 ));
  LUT3 #(
    .INIT(8'h01)) 
    \axi_bid_int[3]_i_6 
       (.I0(AW2Arb_BVALID_Cnt[0]),
        .I1(AW2Arb_BVALID_Cnt[2]),
        .I2(AW2Arb_BVALID_Cnt[1]),
        .O(\axi_bid_int[3]_i_6_n_0 ));
  LUT6 #(
    .INIT(64'h0000001000100010)) 
    bid_gets_fifo_load_d1_i_1
       (.I0(bid_gets_fifo_load_d1_reg),
        .I1(Data_Exists_DFF_1),
        .I2(Arb2AW_Active),
        .I3(\axi_bid_int[3]_i_5_n_0 ),
        .I4(bid_fifo_not_empty),
        .I5(AW2Arb_BVALID_Cnt[0]),
        .O(bid_gets_fifo_load));
endmodule

(* C_BRAM_ADDR_WIDTH = "14" *) (* C_BRAM_INST_MODE = "EXTERNAL" *) (* C_ECC = "0" *) 
(* C_ECC_ONOFF_RESET_VALUE = "0" *) (* C_ECC_TYPE = "0" *) (* C_FAMILY = "artix7" *) 
(* C_FAULT_INJECT = "0" *) (* C_MEMORY_DEPTH = "16384" *) (* C_RD_CMD_OPTIMIZATION = "1" *) 
(* C_READ_LATENCY = "1" *) (* C_SINGLE_PORT_BRAM = "1" *) (* C_S_AXI_ADDR_WIDTH = "18" *) 
(* C_S_AXI_CTRL_ADDR_WIDTH = "32" *) (* C_S_AXI_CTRL_DATA_WIDTH = "32" *) (* C_S_AXI_DATA_WIDTH = "128" *) 
(* C_S_AXI_ID_WIDTH = "4" *) (* C_S_AXI_PROTOCOL = "AXI4" *) (* C_S_AXI_SUPPORTS_NARROW_BURST = "0" *) 
(* ORIG_REF_NAME = "axi_bram_ctrl" *) (* downgradeipidentifiedwarnings = "yes" *) 
module design_1_axi_bram_ctrl_0_1_axi_bram_ctrl
   (s_axi_aclk,
    s_axi_aresetn,
    ecc_interrupt,
    ecc_ue,
    s_axi_awid,
    s_axi_awaddr,
    s_axi_awlen,
    s_axi_awsize,
    s_axi_awburst,
    s_axi_awlock,
    s_axi_awcache,
    s_axi_awprot,
    s_axi_awvalid,
    s_axi_awready,
    s_axi_wdata,
    s_axi_wstrb,
    s_axi_wlast,
    s_axi_wvalid,
    s_axi_wready,
    s_axi_bid,
    s_axi_bresp,
    s_axi_bvalid,
    s_axi_bready,
    s_axi_arid,
    s_axi_araddr,
    s_axi_arlen,
    s_axi_arsize,
    s_axi_arburst,
    s_axi_arlock,
    s_axi_arcache,
    s_axi_arprot,
    s_axi_arvalid,
    s_axi_arready,
    s_axi_rid,
    s_axi_rdata,
    s_axi_rresp,
    s_axi_rlast,
    s_axi_rvalid,
    s_axi_rready,
    s_axi_ctrl_awvalid,
    s_axi_ctrl_awready,
    s_axi_ctrl_awaddr,
    s_axi_ctrl_wdata,
    s_axi_ctrl_wvalid,
    s_axi_ctrl_wready,
    s_axi_ctrl_bresp,
    s_axi_ctrl_bvalid,
    s_axi_ctrl_bready,
    s_axi_ctrl_araddr,
    s_axi_ctrl_arvalid,
    s_axi_ctrl_arready,
    s_axi_ctrl_rdata,
    s_axi_ctrl_rresp,
    s_axi_ctrl_rvalid,
    s_axi_ctrl_rready,
    bram_rst_a,
    bram_clk_a,
    bram_en_a,
    bram_we_a,
    bram_addr_a,
    bram_wrdata_a,
    bram_rddata_a,
    bram_rst_b,
    bram_clk_b,
    bram_en_b,
    bram_we_b,
    bram_addr_b,
    bram_wrdata_b,
    bram_rddata_b);
  input s_axi_aclk;
  input s_axi_aresetn;
  output ecc_interrupt;
  output ecc_ue;
  input [3:0]s_axi_awid;
  input [17:0]s_axi_awaddr;
  input [7:0]s_axi_awlen;
  input [2:0]s_axi_awsize;
  input [1:0]s_axi_awburst;
  input s_axi_awlock;
  input [3:0]s_axi_awcache;
  input [2:0]s_axi_awprot;
  input s_axi_awvalid;
  output s_axi_awready;
  input [127:0]s_axi_wdata;
  input [15:0]s_axi_wstrb;
  input s_axi_wlast;
  input s_axi_wvalid;
  output s_axi_wready;
  output [3:0]s_axi_bid;
  output [1:0]s_axi_bresp;
  output s_axi_bvalid;
  input s_axi_bready;
  input [3:0]s_axi_arid;
  input [17:0]s_axi_araddr;
  input [7:0]s_axi_arlen;
  input [2:0]s_axi_arsize;
  input [1:0]s_axi_arburst;
  input s_axi_arlock;
  input [3:0]s_axi_arcache;
  input [2:0]s_axi_arprot;
  input s_axi_arvalid;
  output s_axi_arready;
  output [3:0]s_axi_rid;
  output [127:0]s_axi_rdata;
  output [1:0]s_axi_rresp;
  output s_axi_rlast;
  output s_axi_rvalid;
  input s_axi_rready;
  input s_axi_ctrl_awvalid;
  output s_axi_ctrl_awready;
  input [31:0]s_axi_ctrl_awaddr;
  input [31:0]s_axi_ctrl_wdata;
  input s_axi_ctrl_wvalid;
  output s_axi_ctrl_wready;
  output [1:0]s_axi_ctrl_bresp;
  output s_axi_ctrl_bvalid;
  input s_axi_ctrl_bready;
  input [31:0]s_axi_ctrl_araddr;
  input s_axi_ctrl_arvalid;
  output s_axi_ctrl_arready;
  output [31:0]s_axi_ctrl_rdata;
  output [1:0]s_axi_ctrl_rresp;
  output s_axi_ctrl_rvalid;
  input s_axi_ctrl_rready;
  output bram_rst_a;
  output bram_clk_a;
  output bram_en_a;
  output [15:0]bram_we_a;
  output [17:0]bram_addr_a;
  output [127:0]bram_wrdata_a;
  input [127:0]bram_rddata_a;
  output bram_rst_b;
  output bram_clk_b;
  output bram_en_b;
  output [15:0]bram_we_b;
  output [17:0]bram_addr_b;
  output [127:0]bram_wrdata_b;
  input [127:0]bram_rddata_b;

  wire \<const0> ;
  wire [17:4]\^bram_addr_a ;
  wire bram_en_a;
  wire [127:0]bram_rddata_a;
  wire bram_rst_a;
  wire [15:0]bram_we_a;
  wire [127:0]bram_wrdata_a;
  wire s_axi_aclk;
  wire [17:0]s_axi_araddr;
  wire [1:0]s_axi_arburst;
  wire s_axi_aresetn;
  wire [3:0]s_axi_arid;
  wire [7:0]s_axi_arlen;
  wire s_axi_arready;
  wire s_axi_arvalid;
  wire [17:0]s_axi_awaddr;
  wire [1:0]s_axi_awburst;
  wire [3:0]s_axi_awid;
  wire [7:0]s_axi_awlen;
  wire s_axi_awready;
  wire s_axi_awvalid;
  wire [3:0]s_axi_bid;
  wire s_axi_bready;
  wire s_axi_bvalid;
  wire [3:0]s_axi_rid;
  wire s_axi_rlast;
  wire s_axi_rready;
  wire s_axi_rvalid;
  wire [127:0]s_axi_wdata;
  wire s_axi_wlast;
  wire s_axi_wready;
  wire [15:0]s_axi_wstrb;
  wire s_axi_wvalid;

  assign bram_addr_a[17:4] = \^bram_addr_a [17:4];
  assign bram_addr_a[3] = \<const0> ;
  assign bram_addr_a[2] = \<const0> ;
  assign bram_addr_a[1] = \<const0> ;
  assign bram_addr_a[0] = \<const0> ;
  assign bram_addr_b[17] = \<const0> ;
  assign bram_addr_b[16] = \<const0> ;
  assign bram_addr_b[15] = \<const0> ;
  assign bram_addr_b[14] = \<const0> ;
  assign bram_addr_b[13] = \<const0> ;
  assign bram_addr_b[12] = \<const0> ;
  assign bram_addr_b[11] = \<const0> ;
  assign bram_addr_b[10] = \<const0> ;
  assign bram_addr_b[9] = \<const0> ;
  assign bram_addr_b[8] = \<const0> ;
  assign bram_addr_b[7] = \<const0> ;
  assign bram_addr_b[6] = \<const0> ;
  assign bram_addr_b[5] = \<const0> ;
  assign bram_addr_b[4] = \<const0> ;
  assign bram_addr_b[3] = \<const0> ;
  assign bram_addr_b[2] = \<const0> ;
  assign bram_addr_b[1] = \<const0> ;
  assign bram_addr_b[0] = \<const0> ;
  assign bram_clk_a = s_axi_aclk;
  assign bram_clk_b = \<const0> ;
  assign bram_en_b = \<const0> ;
  assign bram_rst_b = \<const0> ;
  assign bram_we_b[15] = \<const0> ;
  assign bram_we_b[14] = \<const0> ;
  assign bram_we_b[13] = \<const0> ;
  assign bram_we_b[12] = \<const0> ;
  assign bram_we_b[11] = \<const0> ;
  assign bram_we_b[10] = \<const0> ;
  assign bram_we_b[9] = \<const0> ;
  assign bram_we_b[8] = \<const0> ;
  assign bram_we_b[7] = \<const0> ;
  assign bram_we_b[6] = \<const0> ;
  assign bram_we_b[5] = \<const0> ;
  assign bram_we_b[4] = \<const0> ;
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
  assign bram_wrdata_b[28] = \<const0> ;
  assign bram_wrdata_b[27] = \<const0> ;
  assign bram_wrdata_b[26] = \<const0> ;
  assign bram_wrdata_b[25] = \<const0> ;
  assign bram_wrdata_b[24] = \<const0> ;
  assign bram_wrdata_b[23] = \<const0> ;
  assign bram_wrdata_b[22] = \<const0> ;
  assign bram_wrdata_b[21] = \<const0> ;
  assign bram_wrdata_b[20] = \<const0> ;
  assign bram_wrdata_b[19] = \<const0> ;
  assign bram_wrdata_b[18] = \<const0> ;
  assign bram_wrdata_b[17] = \<const0> ;
  assign bram_wrdata_b[16] = \<const0> ;
  assign bram_wrdata_b[15] = \<const0> ;
  assign bram_wrdata_b[14] = \<const0> ;
  assign bram_wrdata_b[13] = \<const0> ;
  assign bram_wrdata_b[12] = \<const0> ;
  assign bram_wrdata_b[11] = \<const0> ;
  assign bram_wrdata_b[10] = \<const0> ;
  assign bram_wrdata_b[9] = \<const0> ;
  assign bram_wrdata_b[8] = \<const0> ;
  assign bram_wrdata_b[7] = \<const0> ;
  assign bram_wrdata_b[6] = \<const0> ;
  assign bram_wrdata_b[5] = \<const0> ;
  assign bram_wrdata_b[4] = \<const0> ;
  assign bram_wrdata_b[3] = \<const0> ;
  assign bram_wrdata_b[2] = \<const0> ;
  assign bram_wrdata_b[1] = \<const0> ;
  assign bram_wrdata_b[0] = \<const0> ;
  assign ecc_interrupt = \<const0> ;
  assign ecc_ue = \<const0> ;
  assign s_axi_bresp[1] = \<const0> ;
  assign s_axi_bresp[0] = \<const0> ;
  assign s_axi_ctrl_arready = \<const0> ;
  assign s_axi_ctrl_awready = \<const0> ;
  assign s_axi_ctrl_bresp[1] = \<const0> ;
  assign s_axi_ctrl_bresp[0] = \<const0> ;
  assign s_axi_ctrl_bvalid = \<const0> ;
  assign s_axi_ctrl_rdata[31] = \<const0> ;
  assign s_axi_ctrl_rdata[30] = \<const0> ;
  assign s_axi_ctrl_rdata[29] = \<const0> ;
  assign s_axi_ctrl_rdata[28] = \<const0> ;
  assign s_axi_ctrl_rdata[27] = \<const0> ;
  assign s_axi_ctrl_rdata[26] = \<const0> ;
  assign s_axi_ctrl_rdata[25] = \<const0> ;
  assign s_axi_ctrl_rdata[24] = \<const0> ;
  assign s_axi_ctrl_rdata[23] = \<const0> ;
  assign s_axi_ctrl_rdata[22] = \<const0> ;
  assign s_axi_ctrl_rdata[21] = \<const0> ;
  assign s_axi_ctrl_rdata[20] = \<const0> ;
  assign s_axi_ctrl_rdata[19] = \<const0> ;
  assign s_axi_ctrl_rdata[18] = \<const0> ;
  assign s_axi_ctrl_rdata[17] = \<const0> ;
  assign s_axi_ctrl_rdata[16] = \<const0> ;
  assign s_axi_ctrl_rdata[15] = \<const0> ;
  assign s_axi_ctrl_rdata[14] = \<const0> ;
  assign s_axi_ctrl_rdata[13] = \<const0> ;
  assign s_axi_ctrl_rdata[12] = \<const0> ;
  assign s_axi_ctrl_rdata[11] = \<const0> ;
  assign s_axi_ctrl_rdata[10] = \<const0> ;
  assign s_axi_ctrl_rdata[9] = \<const0> ;
  assign s_axi_ctrl_rdata[8] = \<const0> ;
  assign s_axi_ctrl_rdata[7] = \<const0> ;
  assign s_axi_ctrl_rdata[6] = \<const0> ;
  assign s_axi_ctrl_rdata[5] = \<const0> ;
  assign s_axi_ctrl_rdata[4] = \<const0> ;
  assign s_axi_ctrl_rdata[3] = \<const0> ;
  assign s_axi_ctrl_rdata[2] = \<const0> ;
  assign s_axi_ctrl_rdata[1] = \<const0> ;
  assign s_axi_ctrl_rdata[0] = \<const0> ;
  assign s_axi_ctrl_rresp[1] = \<const0> ;
  assign s_axi_ctrl_rresp[0] = \<const0> ;
  assign s_axi_ctrl_rvalid = \<const0> ;
  assign s_axi_ctrl_wready = \<const0> ;
  assign s_axi_rdata[127:0] = bram_rddata_a;
  assign s_axi_rresp[1] = \<const0> ;
  assign s_axi_rresp[0] = \<const0> ;
  GND GND
       (.G(\<const0> ));
  design_1_axi_bram_ctrl_0_1_axi_bram_ctrl_top \gext_inst.abcv4_0_ext_inst 
       (.S_AXI_ARREADY(s_axi_arready),
        .S_AXI_RVALID(s_axi_rvalid),
        .axi_bvalid_int_reg(s_axi_bvalid),
        .bram_addr_a(\^bram_addr_a ),
        .bram_en_a(bram_en_a),
        .bram_we_a(bram_we_a),
        .bram_wrdata_a(bram_wrdata_a),
        .s_axi_aclk(s_axi_aclk),
        .s_axi_araddr(s_axi_araddr[17:4]),
        .s_axi_arburst(s_axi_arburst),
        .s_axi_aresetn(s_axi_aresetn),
        .s_axi_aresetn_0(bram_rst_a),
        .s_axi_arid(s_axi_arid),
        .s_axi_arlen(s_axi_arlen),
        .s_axi_arvalid(s_axi_arvalid),
        .s_axi_awaddr(s_axi_awaddr[17:4]),
        .s_axi_awburst(s_axi_awburst),
        .s_axi_awid(s_axi_awid),
        .s_axi_awlen(s_axi_awlen[3:0]),
        .s_axi_awready(s_axi_awready),
        .s_axi_awvalid(s_axi_awvalid),
        .s_axi_bid(s_axi_bid),
        .s_axi_bready(s_axi_bready),
        .s_axi_rid(s_axi_rid),
        .s_axi_rlast(s_axi_rlast),
        .s_axi_rready(s_axi_rready),
        .s_axi_wdata(s_axi_wdata),
        .s_axi_wlast(s_axi_wlast),
        .s_axi_wready(s_axi_wready),
        .s_axi_wstrb(s_axi_wstrb),
        .s_axi_wvalid(s_axi_wvalid));
endmodule

(* ORIG_REF_NAME = "axi_bram_ctrl_top" *) 
module design_1_axi_bram_ctrl_0_1_axi_bram_ctrl_top
   (S_AXI_RVALID,
    S_AXI_ARREADY,
    s_axi_aresetn_0,
    s_axi_awready,
    axi_bvalid_int_reg,
    s_axi_bid,
    bram_wrdata_a,
    s_axi_rid,
    bram_en_a,
    s_axi_rlast,
    bram_addr_a,
    bram_we_a,
    s_axi_wready,
    s_axi_aresetn,
    s_axi_aclk,
    s_axi_wvalid,
    s_axi_rready,
    s_axi_arvalid,
    s_axi_araddr,
    s_axi_awvalid,
    s_axi_awid,
    s_axi_wlast,
    s_axi_bready,
    s_axi_wdata,
    s_axi_arlen,
    s_axi_arid,
    s_axi_wstrb,
    s_axi_awaddr,
    s_axi_arburst,
    s_axi_awlen,
    s_axi_awburst);
  output S_AXI_RVALID;
  output S_AXI_ARREADY;
  output s_axi_aresetn_0;
  output s_axi_awready;
  output axi_bvalid_int_reg;
  output [3:0]s_axi_bid;
  output [127:0]bram_wrdata_a;
  output [3:0]s_axi_rid;
  output bram_en_a;
  output s_axi_rlast;
  output [13:0]bram_addr_a;
  output [15:0]bram_we_a;
  output s_axi_wready;
  input s_axi_aresetn;
  input s_axi_aclk;
  input s_axi_wvalid;
  input s_axi_rready;
  input s_axi_arvalid;
  input [13:0]s_axi_araddr;
  input s_axi_awvalid;
  input [3:0]s_axi_awid;
  input s_axi_wlast;
  input s_axi_bready;
  input [127:0]s_axi_wdata;
  input [7:0]s_axi_arlen;
  input [3:0]s_axi_arid;
  input [15:0]s_axi_wstrb;
  input [13:0]s_axi_awaddr;
  input [1:0]s_axi_arburst;
  input [3:0]s_axi_awlen;
  input [1:0]s_axi_awburst;

  wire S_AXI_ARREADY;
  wire S_AXI_RVALID;
  wire axi_bvalid_int_reg;
  wire [13:0]bram_addr_a;
  wire bram_en_a;
  wire [15:0]bram_we_a;
  wire [127:0]bram_wrdata_a;
  wire s_axi_aclk;
  wire [13:0]s_axi_araddr;
  wire [1:0]s_axi_arburst;
  wire s_axi_aresetn;
  wire s_axi_aresetn_0;
  wire [3:0]s_axi_arid;
  wire [7:0]s_axi_arlen;
  wire s_axi_arvalid;
  wire [13:0]s_axi_awaddr;
  wire [1:0]s_axi_awburst;
  wire [3:0]s_axi_awid;
  wire [3:0]s_axi_awlen;
  wire s_axi_awready;
  wire s_axi_awvalid;
  wire [3:0]s_axi_bid;
  wire s_axi_bready;
  wire [3:0]s_axi_rid;
  wire s_axi_rlast;
  wire s_axi_rready;
  wire [127:0]s_axi_wdata;
  wire s_axi_wlast;
  wire s_axi_wready;
  wire [15:0]s_axi_wstrb;
  wire s_axi_wvalid;

  design_1_axi_bram_ctrl_0_1_full_axi \GEN_AXI4.I_FULL_AXI 
       (.SR(s_axi_aresetn_0),
        .S_AXI_ARREADY(S_AXI_ARREADY),
        .S_AXI_RVALID(S_AXI_RVALID),
        .axi_bvalid_int_reg(axi_bvalid_int_reg),
        .bram_addr_a(bram_addr_a),
        .bram_en_a(bram_en_a),
        .bram_we_a(bram_we_a),
        .bram_wrdata_a(bram_wrdata_a),
        .s_axi_aclk(s_axi_aclk),
        .s_axi_araddr(s_axi_araddr),
        .s_axi_arburst(s_axi_arburst),
        .s_axi_aresetn(s_axi_aresetn),
        .s_axi_arid(s_axi_arid),
        .s_axi_arlen(s_axi_arlen),
        .s_axi_arvalid(s_axi_arvalid),
        .s_axi_awaddr(s_axi_awaddr),
        .s_axi_awburst(s_axi_awburst),
        .s_axi_awid(s_axi_awid),
        .s_axi_awlen(s_axi_awlen),
        .s_axi_awready(s_axi_awready),
        .s_axi_awvalid(s_axi_awvalid),
        .s_axi_bid(s_axi_bid),
        .s_axi_bready(s_axi_bready),
        .s_axi_rid(s_axi_rid),
        .s_axi_rlast(s_axi_rlast),
        .s_axi_rready(s_axi_rready),
        .s_axi_wdata(s_axi_wdata),
        .s_axi_wlast(s_axi_wlast),
        .s_axi_wready(s_axi_wready),
        .s_axi_wstrb(s_axi_wstrb),
        .s_axi_wvalid(s_axi_wvalid));
endmodule

(* ORIG_REF_NAME = "full_axi" *) 
module design_1_axi_bram_ctrl_0_1_full_axi
   (S_AXI_RVALID,
    S_AXI_ARREADY,
    SR,
    s_axi_awready,
    axi_bvalid_int_reg,
    s_axi_bid,
    bram_wrdata_a,
    s_axi_rid,
    bram_en_a,
    s_axi_rlast,
    bram_addr_a,
    bram_we_a,
    s_axi_wready,
    s_axi_aresetn,
    s_axi_aclk,
    s_axi_wvalid,
    s_axi_rready,
    s_axi_arvalid,
    s_axi_araddr,
    s_axi_awvalid,
    s_axi_awid,
    s_axi_wlast,
    s_axi_bready,
    s_axi_wdata,
    s_axi_arlen,
    s_axi_arid,
    s_axi_wstrb,
    s_axi_awaddr,
    s_axi_arburst,
    s_axi_awlen,
    s_axi_awburst);
  output S_AXI_RVALID;
  output S_AXI_ARREADY;
  output [0:0]SR;
  output s_axi_awready;
  output axi_bvalid_int_reg;
  output [3:0]s_axi_bid;
  output [127:0]bram_wrdata_a;
  output [3:0]s_axi_rid;
  output bram_en_a;
  output s_axi_rlast;
  output [13:0]bram_addr_a;
  output [15:0]bram_we_a;
  output s_axi_wready;
  input s_axi_aresetn;
  input s_axi_aclk;
  input s_axi_wvalid;
  input s_axi_rready;
  input s_axi_arvalid;
  input [13:0]s_axi_araddr;
  input s_axi_awvalid;
  input [3:0]s_axi_awid;
  input s_axi_wlast;
  input s_axi_bready;
  input [127:0]s_axi_wdata;
  input [7:0]s_axi_arlen;
  input [3:0]s_axi_arid;
  input [15:0]s_axi_wstrb;
  input [13:0]s_axi_awaddr;
  input [1:0]s_axi_arburst;
  input [3:0]s_axi_awlen;
  input [1:0]s_axi_awburst;

  wire \ADDR_SNG_PORT.bram_addr_int[10]_i_2_n_0 ;
  wire \ADDR_SNG_PORT.bram_addr_int[11]_i_4_n_0 ;
  wire \ADDR_SNG_PORT.bram_addr_int[11]_i_8_n_0 ;
  wire \ADDR_SNG_PORT.bram_addr_int[5]_i_7_n_0 ;
  wire \ADDR_SNG_PORT.bram_addr_int[6]_i_2_n_0 ;
  wire \ADDR_SNG_PORT.bram_addr_int[6]_i_7_n_0 ;
  wire \ADDR_SNG_PORT.bram_addr_int[7]_i_7_n_0 ;
  wire \ADDR_SNG_PORT.bram_addr_int[8]_i_2_n_0 ;
  wire \ADDR_SNG_PORT.bram_addr_int[9]_i_2_n_0 ;
  wire \ADDR_SNG_PORT.bram_addr_int_reg_n_0_[10] ;
  wire \ADDR_SNG_PORT.bram_addr_int_reg_n_0_[11] ;
  wire \ADDR_SNG_PORT.bram_addr_int_reg_n_0_[12] ;
  wire \ADDR_SNG_PORT.bram_addr_int_reg_n_0_[13] ;
  wire \ADDR_SNG_PORT.bram_addr_int_reg_n_0_[14] ;
  wire \ADDR_SNG_PORT.bram_addr_int_reg_n_0_[15] ;
  wire \ADDR_SNG_PORT.bram_addr_int_reg_n_0_[16] ;
  wire \ADDR_SNG_PORT.bram_addr_int_reg_n_0_[4] ;
  wire \ADDR_SNG_PORT.bram_addr_int_reg_n_0_[5] ;
  wire \ADDR_SNG_PORT.bram_addr_int_reg_n_0_[6] ;
  wire \ADDR_SNG_PORT.bram_addr_int_reg_n_0_[7] ;
  wire \ADDR_SNG_PORT.bram_addr_int_reg_n_0_[8] ;
  wire \ADDR_SNG_PORT.bram_addr_int_reg_n_0_[9] ;
  wire AW2Arb_Active_Clr;
  wire Arb2AR_Active;
  wire Arb2AW_Active;
  wire BRAM_En_A_i;
  wire \GEN_ARB.I_SNG_PORT_n_10 ;
  wire \GEN_ARB.I_SNG_PORT_n_11 ;
  wire \GEN_ARB.I_SNG_PORT_n_12 ;
  wire \GEN_ARB.I_SNG_PORT_n_13 ;
  wire \GEN_ARB.I_SNG_PORT_n_15 ;
  wire \GEN_ARB.I_SNG_PORT_n_16 ;
  wire \GEN_ARB.I_SNG_PORT_n_18 ;
  wire \GEN_ARB.I_SNG_PORT_n_28 ;
  wire \GEN_ARB.I_SNG_PORT_n_29 ;
  wire \GEN_ARB.I_SNG_PORT_n_30 ;
  wire \GEN_ARB.I_SNG_PORT_n_31 ;
  wire \GEN_ARB.I_SNG_PORT_n_32 ;
  wire \GEN_ARB.I_SNG_PORT_n_4 ;
  wire \GEN_ARB.I_SNG_PORT_n_5 ;
  wire \GEN_ARB.I_SNG_PORT_n_6 ;
  wire \GEN_ARB.I_SNG_PORT_n_7 ;
  wire \GEN_ARB.I_SNG_PORT_n_8 ;
  wire \GEN_ARB.I_SNG_PORT_n_9 ;
  wire [1:1]\GEN_RD_CMD_OPT.I_WRAP_BRST/wrap_burst_total ;
  wire [1:1]\GEN_RD_CMD_OPT.I_WRAP_BRST/wrap_burst_total_reg ;
  wire [0:0]\GEN_RD_CMD_OPT.brst_cnt_addr_reg ;
  wire [0:0]\GEN_RD_CMD_OPT.brst_cnt_data_reg ;
  wire I_RD_CHNL_n_17;
  wire I_RD_CHNL_n_18;
  wire I_RD_CHNL_n_19;
  wire I_RD_CHNL_n_2;
  wire I_RD_CHNL_n_20;
  wire I_RD_CHNL_n_32;
  wire I_RD_CHNL_n_34;
  wire I_RD_CHNL_n_35;
  wire I_RD_CHNL_n_36;
  wire I_RD_CHNL_n_37;
  wire I_RD_CHNL_n_38;
  wire I_RD_CHNL_n_39;
  wire I_RD_CHNL_n_40;
  wire I_RD_CHNL_n_41;
  wire I_RD_CHNL_n_42;
  wire I_RD_CHNL_n_7;
  wire I_RD_CHNL_n_8;
  wire I_RD_CHNL_n_9;
  wire I_WR_CHNL_n_132;
  wire I_WR_CHNL_n_133;
  wire I_WR_CHNL_n_135;
  wire I_WR_CHNL_n_136;
  wire I_WR_CHNL_n_137;
  wire I_WR_CHNL_n_138;
  wire I_WR_CHNL_n_139;
  wire I_WR_CHNL_n_140;
  wire I_WR_CHNL_n_141;
  wire I_WR_CHNL_n_142;
  wire I_WR_CHNL_n_143;
  wire I_WR_CHNL_n_144;
  wire I_WR_CHNL_n_151;
  wire I_WR_CHNL_n_152;
  wire I_WR_CHNL_n_153;
  wire I_WR_CHNL_n_155;
  wire [0:0]SR;
  wire S_AXI_ARREADY;
  wire S_AXI_RVALID;
  wire [1:0]arb_sm_cs;
  wire [1:1]arlen_reg;
  wire [1:1]arlen_temp;
  wire aw_active_cmb;
  wire aw_active_d1;
  wire aw_active_re;
  wire axi_bvalid_int_reg;
  wire [13:0]bram_addr_a;
  wire bram_en_a;
  wire [15:0]bram_we_a;
  wire [15:0]bram_we_int;
  wire [127:0]bram_wrdata_a;
  wire [0:0]p_0_in;
  wire p_0_in_0;
  wire [0:0]p_0_in__0;
  wire [13:8]p_2_in;
  wire s_axi_aclk;
  wire [13:0]s_axi_araddr;
  wire [1:0]s_axi_arburst;
  wire s_axi_aresetn;
  wire [3:0]s_axi_arid;
  wire [7:0]s_axi_arlen;
  wire s_axi_arvalid;
  wire [13:0]s_axi_awaddr;
  wire [1:0]s_axi_awburst;
  wire [3:0]s_axi_awid;
  wire [3:0]s_axi_awlen;
  wire s_axi_awready;
  wire s_axi_awvalid;
  wire [3:0]s_axi_bid;
  wire s_axi_bready;
  wire [3:0]s_axi_rid;
  wire s_axi_rlast;
  wire s_axi_rready;
  wire [127:0]s_axi_wdata;
  wire s_axi_wlast;
  wire s_axi_wready;
  wire [15:0]s_axi_wstrb;
  wire s_axi_wvalid;
  wire [17:12]sng_bram_addr_ld;
  wire sng_bram_addr_ld_en;

  LUT6 #(
    .INIT(64'h6AAAAAAAAAAAAAAA)) 
    \ADDR_SNG_PORT.bram_addr_int[10]_i_2 
       (.I0(\ADDR_SNG_PORT.bram_addr_int_reg_n_0_[10] ),
        .I1(\ADDR_SNG_PORT.bram_addr_int_reg_n_0_[9] ),
        .I2(\ADDR_SNG_PORT.bram_addr_int_reg_n_0_[7] ),
        .I3(\ADDR_SNG_PORT.bram_addr_int_reg_n_0_[6] ),
        .I4(\ADDR_SNG_PORT.bram_addr_int[6]_i_2_n_0 ),
        .I5(\ADDR_SNG_PORT.bram_addr_int_reg_n_0_[8] ),
        .O(\ADDR_SNG_PORT.bram_addr_int[10]_i_2_n_0 ));
  LUT3 #(
    .INIT(8'h95)) 
    \ADDR_SNG_PORT.bram_addr_int[11]_i_4 
       (.I0(\ADDR_SNG_PORT.bram_addr_int_reg_n_0_[11] ),
        .I1(\ADDR_SNG_PORT.bram_addr_int[11]_i_8_n_0 ),
        .I2(\ADDR_SNG_PORT.bram_addr_int_reg_n_0_[10] ),
        .O(\ADDR_SNG_PORT.bram_addr_int[11]_i_4_n_0 ));
  LUT6 #(
    .INIT(64'h8000000000000000)) 
    \ADDR_SNG_PORT.bram_addr_int[11]_i_8 
       (.I0(\ADDR_SNG_PORT.bram_addr_int_reg_n_0_[8] ),
        .I1(\ADDR_SNG_PORT.bram_addr_int_reg_n_0_[4] ),
        .I2(\ADDR_SNG_PORT.bram_addr_int_reg_n_0_[5] ),
        .I3(\ADDR_SNG_PORT.bram_addr_int_reg_n_0_[6] ),
        .I4(\ADDR_SNG_PORT.bram_addr_int_reg_n_0_[7] ),
        .I5(\ADDR_SNG_PORT.bram_addr_int_reg_n_0_[9] ),
        .O(\ADDR_SNG_PORT.bram_addr_int[11]_i_8_n_0 ));
  (* SOFT_HLUTNM = "soft_lutpair51" *) 
  LUT2 #(
    .INIT(4'h9)) 
    \ADDR_SNG_PORT.bram_addr_int[5]_i_7 
       (.I0(\ADDR_SNG_PORT.bram_addr_int_reg_n_0_[5] ),
        .I1(\ADDR_SNG_PORT.bram_addr_int_reg_n_0_[4] ),
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
        .CE(I_WR_CHNL_n_139),
        .D(\GEN_ARB.I_SNG_PORT_n_12 ),
        .Q(\ADDR_SNG_PORT.bram_addr_int_reg_n_0_[5] ),
        .R(I_WR_CHNL_n_132));
  FDRE #(
    .INIT(1'b0)) 
    \ADDR_SNG_PORT.bram_addr_int_reg[6] 
       (.C(s_axi_aclk),
        .CE(I_WR_CHNL_n_139),
        .D(\GEN_ARB.I_SNG_PORT_n_11 ),
        .Q(\ADDR_SNG_PORT.bram_addr_int_reg_n_0_[6] ),
        .R(I_WR_CHNL_n_132));
  FDRE #(
    .INIT(1'b0)) 
    \ADDR_SNG_PORT.bram_addr_int_reg[7] 
       (.C(s_axi_aclk),
        .CE(I_WR_CHNL_n_139),
        .D(\GEN_ARB.I_SNG_PORT_n_10 ),
        .Q(\ADDR_SNG_PORT.bram_addr_int_reg_n_0_[7] ),
        .R(I_WR_CHNL_n_132));
  FDRE #(
    .INIT(1'b0)) 
    \ADDR_SNG_PORT.bram_addr_int_reg[8] 
       (.C(s_axi_aclk),
        .CE(I_WR_CHNL_n_139),
        .D(\GEN_ARB.I_SNG_PORT_n_9 ),
        .Q(\ADDR_SNG_PORT.bram_addr_int_reg_n_0_[8] ),
        .R(I_WR_CHNL_n_132));
  FDRE #(
    .INIT(1'b0)) 
    \ADDR_SNG_PORT.bram_addr_int_reg[9] 
       (.C(s_axi_aclk),
        .CE(I_WR_CHNL_n_139),
        .D(\GEN_ARB.I_SNG_PORT_n_8 ),
        .Q(\ADDR_SNG_PORT.bram_addr_int_reg_n_0_[9] ),
        .R(I_WR_CHNL_n_132));
  design_1_axi_bram_ctrl_0_1_sng_port_arb \GEN_ARB.I_SNG_PORT 
       (.\ADDR_SNG_PORT.bram_addr_int_reg[10] (\ADDR_SNG_PORT.bram_addr_int[10]_i_2_n_0 ),
        .\ADDR_SNG_PORT.bram_addr_int_reg[10]_0 (I_RD_CHNL_n_37),
        .\ADDR_SNG_PORT.bram_addr_int_reg[11] ({I_WR_CHNL_n_141,I_WR_CHNL_n_142,I_WR_CHNL_n_143,I_WR_CHNL_n_144}),
        .\ADDR_SNG_PORT.bram_addr_int_reg[11]_0 (\ADDR_SNG_PORT.bram_addr_int[11]_i_4_n_0 ),
        .\ADDR_SNG_PORT.bram_addr_int_reg[11]_1 (I_RD_CHNL_n_38),
        .\ADDR_SNG_PORT.bram_addr_int_reg[5] (I_WR_CHNL_n_138),
        .\ADDR_SNG_PORT.bram_addr_int_reg[5]_0 (I_RD_CHNL_n_40),
        .\ADDR_SNG_PORT.bram_addr_int_reg[5]_1 (I_WR_CHNL_n_137),
        .\ADDR_SNG_PORT.bram_addr_int_reg[5]_2 (I_WR_CHNL_n_151),
        .\ADDR_SNG_PORT.bram_addr_int_reg[5]_3 (I_RD_CHNL_n_20),
        .\ADDR_SNG_PORT.bram_addr_int_reg[6] (\ADDR_SNG_PORT.bram_addr_int[6]_i_2_n_0 ),
        .\ADDR_SNG_PORT.bram_addr_int_reg[6]_0 (I_WR_CHNL_n_152),
        .\ADDR_SNG_PORT.bram_addr_int_reg[6]_1 (I_WR_CHNL_n_136),
        .\ADDR_SNG_PORT.bram_addr_int_reg[6]_2 (I_WR_CHNL_n_135),
        .\ADDR_SNG_PORT.bram_addr_int_reg[6]_3 (I_WR_CHNL_n_133),
        .\ADDR_SNG_PORT.bram_addr_int_reg[6]_4 (I_RD_CHNL_n_32),
        .\ADDR_SNG_PORT.bram_addr_int_reg[6]_5 (I_RD_CHNL_n_41),
        .\ADDR_SNG_PORT.bram_addr_int_reg[7] (I_RD_CHNL_n_39),
        .\ADDR_SNG_PORT.bram_addr_int_reg[7]_0 (I_RD_CHNL_n_42),
        .\ADDR_SNG_PORT.bram_addr_int_reg[7]_1 (\ADDR_SNG_PORT.bram_addr_int[7]_i_7_n_0 ),
        .\ADDR_SNG_PORT.bram_addr_int_reg[7]_2 (I_WR_CHNL_n_140),
        .\ADDR_SNG_PORT.bram_addr_int_reg[8] (\ADDR_SNG_PORT.bram_addr_int[8]_i_2_n_0 ),
        .\ADDR_SNG_PORT.bram_addr_int_reg[8]_0 (I_RD_CHNL_n_34),
        .\ADDR_SNG_PORT.bram_addr_int_reg[8]_1 (I_RD_CHNL_n_35),
        .\ADDR_SNG_PORT.bram_addr_int_reg[9] (\ADDR_SNG_PORT.bram_addr_int[9]_i_2_n_0 ),
        .\ADDR_SNG_PORT.bram_addr_int_reg[9]_0 (I_RD_CHNL_n_36),
        .AW2Arb_Active_Clr(AW2Arb_Active_Clr),
        .Arb2AR_Active(Arb2AR_Active),
        .Arb2AW_Active(Arb2AW_Active),
        .D({\GEN_ARB.I_SNG_PORT_n_6 ,\GEN_ARB.I_SNG_PORT_n_7 ,\GEN_ARB.I_SNG_PORT_n_8 ,\GEN_ARB.I_SNG_PORT_n_9 ,\GEN_ARB.I_SNG_PORT_n_10 ,\GEN_ARB.I_SNG_PORT_n_11 ,\GEN_ARB.I_SNG_PORT_n_12 ,\GEN_ARB.I_SNG_PORT_n_13 }),
        .E(sng_bram_addr_ld_en),
        .\FSM_sequential_arb_sm_cs_reg[0]_0 (I_RD_CHNL_n_8),
        .\GEN_RD_CMD_OPT.arlen_reg_reg[1] (arlen_reg),
        .\GEN_RD_CMD_OPT.brst_cnt_addr_reg[0] (\GEN_RD_CMD_OPT.brst_cnt_addr_reg ),
        .\GEN_RD_CMD_OPT.brst_cnt_data_reg[0] (\GEN_RD_CMD_OPT.brst_cnt_data_reg ),
        .\GEN_RD_CMD_OPT.wrap_addr_assign_reg (I_RD_CHNL_n_7),
        .Q({\ADDR_SNG_PORT.bram_addr_int_reg_n_0_[11] ,\ADDR_SNG_PORT.bram_addr_int_reg_n_0_[9] ,\ADDR_SNG_PORT.bram_addr_int_reg_n_0_[6] ,\ADDR_SNG_PORT.bram_addr_int_reg_n_0_[5] ,\ADDR_SNG_PORT.bram_addr_int_reg_n_0_[4] }),
        .ar_active_reg_0(\GEN_ARB.I_SNG_PORT_n_4 ),
        .ar_active_reg_1(\GEN_ARB.I_SNG_PORT_n_16 ),
        .ar_active_reg_2(SR),
        .arb_sm_cs(arb_sm_cs),
        .aw_active_cmb(aw_active_cmb),
        .aw_active_d1(aw_active_d1),
        .aw_active_re(aw_active_re),
        .axi_arready_int_reg_0(S_AXI_ARREADY),
        .axi_arready_int_reg_1(\GEN_ARB.I_SNG_PORT_n_28 ),
        .bram_addr_a({bram_addr_a[7],bram_addr_a[5],bram_addr_a[2]}),
        .\bram_addr_a[11] (I_RD_CHNL_n_19),
        .\bram_addr_a[6] (I_RD_CHNL_n_17),
        .\bram_addr_a[9] (I_RD_CHNL_n_18),
        .bram_we_a(bram_we_a),
        .\bram_we_a[15] (bram_we_int),
        .last_arb_won_reg_0(I_RD_CHNL_n_9),
        .last_arb_won_reg_1(I_WR_CHNL_n_155),
        .last_arb_won_reg_2(I_WR_CHNL_n_153),
        .s_axi_aclk(s_axi_aclk),
        .s_axi_araddr(s_axi_araddr[7:0]),
        .\s_axi_araddr[10] (\GEN_ARB.I_SNG_PORT_n_31 ),
        .\s_axi_araddr[11] (\GEN_ARB.I_SNG_PORT_n_32 ),
        .\s_axi_araddr[8] (\GEN_ARB.I_SNG_PORT_n_30 ),
        .s_axi_araddr_5_sp_1(\GEN_ARB.I_SNG_PORT_n_5 ),
        .s_axi_arburst(s_axi_arburst),
        .s_axi_arburst_1_sp_1(\GEN_ARB.I_SNG_PORT_n_29 ),
        .s_axi_arlen(s_axi_arlen[3:0]),
        .\s_axi_arlen[0] (p_0_in__0),
        .\s_axi_arlen[0]_0 (p_0_in),
        .\s_axi_arlen[0]_1 (\GEN_RD_CMD_OPT.I_WRAP_BRST/wrap_burst_total ),
        .\s_axi_arlen[1]_0 (arlen_temp),
        .s_axi_arlen_1_sp_1(\GEN_ARB.I_SNG_PORT_n_18 ),
        .s_axi_arvalid(s_axi_arvalid),
        .s_axi_arvalid_0(\GEN_ARB.I_SNG_PORT_n_15 ),
        .s_axi_awaddr(s_axi_awaddr[7:0]),
        .s_axi_awready(s_axi_awready),
        .s_axi_awvalid(s_axi_awvalid),
        .s_axi_wvalid(s_axi_wvalid),
        .\wrap_burst_total_reg_reg[1] (\GEN_RD_CMD_OPT.I_WRAP_BRST/wrap_burst_total_reg ));
  design_1_axi_bram_ctrl_0_1_rd_chnl I_RD_CHNL
       (.\ADDR_SNG_PORT.bram_addr_int[6]_i_3 (\GEN_ARB.I_SNG_PORT_n_4 ),
        .\ADDR_SNG_PORT.bram_addr_int[6]_i_3_0 (\ADDR_SNG_PORT.bram_addr_int[6]_i_7_n_0 ),
        .\ADDR_SNG_PORT.bram_addr_int_reg[5] (\ADDR_SNG_PORT.bram_addr_int[5]_i_7_n_0 ),
        .Arb2AR_Active(Arb2AR_Active),
        .BRAM_En_A_i(BRAM_En_A_i),
        .D(p_2_in),
        .\FSM_sequential_GEN_RD_CMD_OPT.rd_data_sm_cs_reg[1]_0 (I_RD_CHNL_n_9),
        .\FSM_sequential_arb_sm_cs_reg[1] (I_RD_CHNL_n_8),
        .\GEN_RD_CMD_OPT.GEN_WO_NARROW.bram_addr_int_reg[10]_0 (I_RD_CHNL_n_37),
        .\GEN_RD_CMD_OPT.GEN_WO_NARROW.bram_addr_int_reg[10]_1 (\GEN_ARB.I_SNG_PORT_n_29 ),
        .\GEN_RD_CMD_OPT.GEN_WO_NARROW.bram_addr_int_reg[11]_0 (I_RD_CHNL_n_19),
        .\GEN_RD_CMD_OPT.GEN_WO_NARROW.bram_addr_int_reg[11]_1 (I_RD_CHNL_n_38),
        .\GEN_RD_CMD_OPT.GEN_WO_NARROW.bram_addr_int_reg[11]_2 (\GEN_ARB.I_SNG_PORT_n_32 ),
        .\GEN_RD_CMD_OPT.GEN_WO_NARROW.bram_addr_int_reg[5]_0 (I_RD_CHNL_n_39),
        .\GEN_RD_CMD_OPT.GEN_WO_NARROW.bram_addr_int_reg[5]_1 (I_RD_CHNL_n_41),
        .\GEN_RD_CMD_OPT.GEN_WO_NARROW.bram_addr_int_reg[6]_0 (I_RD_CHNL_n_17),
        .\GEN_RD_CMD_OPT.GEN_WO_NARROW.bram_addr_int_reg[8]_0 (I_RD_CHNL_n_34),
        .\GEN_RD_CMD_OPT.GEN_WO_NARROW.bram_addr_int_reg[9]_0 (I_RD_CHNL_n_18),
        .\GEN_RD_CMD_OPT.GEN_WO_NARROW.bram_addr_int_reg[9]_1 (I_RD_CHNL_n_36),
        .\GEN_RD_CMD_OPT.arlen_reg_reg[1]_0 (arlen_reg),
        .\GEN_RD_CMD_OPT.arlen_reg_reg[1]_1 (arlen_temp),
        .\GEN_RD_CMD_OPT.arsize_reg_reg[2]_0 (I_RD_CHNL_n_20),
        .\GEN_RD_CMD_OPT.arsize_reg_reg[2]_1 (I_RD_CHNL_n_35),
        .\GEN_RD_CMD_OPT.axi_rvalid_int_reg_0 (S_AXI_RVALID),
        .\GEN_RD_CMD_OPT.axi_rvalid_int_reg_1 (I_RD_CHNL_n_2),
        .\GEN_RD_CMD_OPT.brst_cnt_addr_reg[0]_0 (\GEN_RD_CMD_OPT.brst_cnt_addr_reg ),
        .\GEN_RD_CMD_OPT.brst_cnt_addr_reg[0]_1 (p_0_in__0),
        .\GEN_RD_CMD_OPT.brst_cnt_data_reg[0]_0 (\GEN_RD_CMD_OPT.brst_cnt_data_reg ),
        .\GEN_RD_CMD_OPT.brst_cnt_data_reg[0]_1 (p_0_in),
        .\GEN_RD_CMD_OPT.wrap_addr_assign_reg_0 (\GEN_ARB.I_SNG_PORT_n_5 ),
        .\GEN_RD_CMD_OPT.wrap_addr_assign_reg_1 (\GEN_ARB.I_SNG_PORT_n_18 ),
        .Q(\GEN_RD_CMD_OPT.I_WRAP_BRST/wrap_burst_total_reg ),
        .arb_sm_cs(arb_sm_cs),
        .bram_addr_a({bram_addr_a[13:8],bram_addr_a[6],bram_addr_a[4:3],bram_addr_a[1:0]}),
        .\bram_addr_a[17] ({p_0_in_0,\ADDR_SNG_PORT.bram_addr_int_reg_n_0_[16] ,\ADDR_SNG_PORT.bram_addr_int_reg_n_0_[15] ,\ADDR_SNG_PORT.bram_addr_int_reg_n_0_[14] ,\ADDR_SNG_PORT.bram_addr_int_reg_n_0_[13] ,\ADDR_SNG_PORT.bram_addr_int_reg_n_0_[12] ,\ADDR_SNG_PORT.bram_addr_int_reg_n_0_[10] ,\ADDR_SNG_PORT.bram_addr_int_reg_n_0_[8] ,\ADDR_SNG_PORT.bram_addr_int_reg_n_0_[7] ,\ADDR_SNG_PORT.bram_addr_int_reg_n_0_[5] ,\ADDR_SNG_PORT.bram_addr_int_reg_n_0_[4] }),
        .bram_addr_a_10_sp_1(\GEN_ARB.I_SNG_PORT_n_31 ),
        .bram_addr_a_8_sp_1(\GEN_ARB.I_SNG_PORT_n_30 ),
        .bram_en_a(bram_en_a),
        .s_axi_aclk(s_axi_aclk),
        .s_axi_araddr(s_axi_araddr),
        .s_axi_araddr_4_sp_1(I_RD_CHNL_n_7),
        .s_axi_arburst(s_axi_arburst),
        .s_axi_aresetn(s_axi_aresetn),
        .s_axi_aresetn_0(SR),
        .s_axi_arid(s_axi_arid),
        .s_axi_arlen(s_axi_arlen),
        .s_axi_arvalid(s_axi_arvalid),
        .s_axi_rid(s_axi_rid),
        .s_axi_rlast(s_axi_rlast),
        .s_axi_rready(s_axi_rready),
        .\save_init_bram_addr_ld_reg_reg[17] (S_AXI_ARREADY),
        .\save_init_bram_addr_ld_reg_reg[5] (\GEN_ARB.I_SNG_PORT_n_28 ),
        .\wrap_burst_total_reg_reg[1] (I_RD_CHNL_n_32),
        .\wrap_burst_total_reg_reg[1]_0 (I_RD_CHNL_n_40),
        .\wrap_burst_total_reg_reg[1]_1 (I_RD_CHNL_n_42),
        .\wrap_burst_total_reg_reg[1]_2 (\GEN_RD_CMD_OPT.I_WRAP_BRST/wrap_burst_total ),
        .\wrap_burst_total_reg_reg[2] (\GEN_ARB.I_SNG_PORT_n_15 ));
  design_1_axi_bram_ctrl_0_1_wr_chnl I_WR_CHNL
       (.\ADDR_SNG_PORT.bram_addr_int[17]_i_5 ({\ADDR_SNG_PORT.bram_addr_int_reg_n_0_[7] ,\ADDR_SNG_PORT.bram_addr_int_reg_n_0_[6] ,\ADDR_SNG_PORT.bram_addr_int_reg_n_0_[5] ,\ADDR_SNG_PORT.bram_addr_int_reg_n_0_[4] }),
        .\ADDR_SNG_PORT.bram_addr_int_reg[17] (p_2_in),
        .\ADDR_SNG_PORT.bram_addr_int_reg[4] (I_RD_CHNL_n_2),
        .\ADDR_SNG_PORT.bram_addr_int_reg[4]_0 (\GEN_ARB.I_SNG_PORT_n_16 ),
        .AW2Arb_Active_Clr(AW2Arb_Active_Clr),
        .Arb2AR_Active(Arb2AR_Active),
        .Arb2AW_Active(Arb2AW_Active),
        .BRAM_En_A_i(BRAM_En_A_i),
        .D(sng_bram_addr_ld),
        .E(I_WR_CHNL_n_139),
        .\FSM_onehot_GEN_WDATA_SM_NO_ECC_SNG_REG_WREADY.wr_data_sng_sm_cs_reg[1]_0 (I_WR_CHNL_n_137),
        .\FSM_onehot_GEN_WDATA_SM_NO_ECC_SNG_REG_WREADY.wr_data_sng_sm_cs_reg[1]_1 (I_WR_CHNL_n_138),
        .\FSM_sequential_arb_sm_cs_reg[0] (I_WR_CHNL_n_153),
        .\GEN_WR_NO_ECC.bram_we_int_reg[15]_0 (bram_we_int),
        .Q({I_WR_CHNL_n_141,I_WR_CHNL_n_142,I_WR_CHNL_n_143,I_WR_CHNL_n_144}),
        .SR(I_WR_CHNL_n_132),
        .arb_sm_cs(arb_sm_cs),
        .aw_active_cmb(aw_active_cmb),
        .aw_active_d1(aw_active_d1),
        .aw_active_re(aw_active_re),
        .aw_active_reg(I_WR_CHNL_n_136),
        .axi_bvalid_int_reg_0(axi_bvalid_int_reg),
        .bram_wrdata_a(bram_wrdata_a),
        .curr_wrap_burst_reg_reg_0(I_WR_CHNL_n_135),
        .s_axi_aclk(s_axi_aclk),
        .s_axi_aresetn(s_axi_aresetn),
        .s_axi_awaddr(s_axi_awaddr[13:1]),
        .s_axi_awburst(s_axi_awburst),
        .s_axi_awid(s_axi_awid),
        .s_axi_awlen(s_axi_awlen),
        .s_axi_awvalid(s_axi_awvalid),
        .s_axi_awvalid_0(I_WR_CHNL_n_155),
        .s_axi_bid(s_axi_bid),
        .s_axi_bready(s_axi_bready),
        .s_axi_wdata(s_axi_wdata),
        .s_axi_wlast(s_axi_wlast),
        .s_axi_wready(s_axi_wready),
        .s_axi_wstrb(s_axi_wstrb),
        .s_axi_wvalid(s_axi_wvalid),
        .s_axi_wvalid_0(I_WR_CHNL_n_133),
        .\save_init_bram_addr_ld_reg[5] (I_WR_CHNL_n_151),
        .\save_init_bram_addr_ld_reg[5]_0 (SR),
        .\save_init_bram_addr_ld_reg[6] (I_WR_CHNL_n_152),
        .\wrap_burst_total_reg[1] (I_WR_CHNL_n_140));
endmodule
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
