phoenix-pnp/ThunderScope/Firmware/Artix7_PCIe/dso_top/dso_top.srcs/sources_1/bd/design_1/ip/design_1_axi_bram_ctrl_0_1/design_1_axi_bram_ctrl_0_1_sim_netlist.vhdl

-- Copyright 1986-2020 Xilinx, Inc. All Rights Reserved.
-- --------------------------------------------------------------------------------
-- Tool Version: Vivado v.2020.1 (win64) Build 2902540 Wed May 27 19:54:49 MDT 2020
-- Date        : Sat May  8 17:44:59 2021
-- Host        : DESKTOP-J72MK93 running 64-bit major release  (build 9200)
-- Command     : write_vhdl -force -mode funcsim
--               c:/Users/Aleksa/Documents/FPGA_Dev/Artix7_PCIe/dso_top/dso_top.srcs/sources_1/bd/design_1/ip/design_1_axi_bram_ctrl_0_1/design_1_axi_bram_ctrl_0_1_sim_netlist.vhdl
-- Design      : design_1_axi_bram_ctrl_0_1
-- Purpose     : This VHDL netlist is a functional simulation representation of the design and should not be modified or
--               synthesized. This netlist cannot be used for SDF annotated simulation.
-- Device      : xc7a100tfgg484-2
-- --------------------------------------------------------------------------------
library IEEE;
use IEEE.STD_LOGIC_1164.ALL;
library UNISIM;
use UNISIM.VCOMPONENTS.ALL;
entity design_1_axi_bram_ctrl_0_1_SRL_FIFO is
  port (
    D : out STD_LOGIC_VECTOR ( 3 downto 0 );
    bid_gets_fifo_load : out STD_LOGIC;
    E : out STD_LOGIC_VECTOR ( 0 to 0 );
    bvalid_cnt_inc : out STD_LOGIC;
    Data_Exists_DFF_0 : in STD_LOGIC;
    s_axi_aclk : in STD_LOGIC;
    s_axi_awid : in STD_LOGIC_VECTOR ( 3 downto 0 );
    AW2Arb_BVALID_Cnt : in STD_LOGIC_VECTOR ( 2 downto 0 );
    bid_gets_fifo_load_d1_reg : in STD_LOGIC;
    Data_Exists_DFF_1 : in STD_LOGIC;
    Arb2AW_Active : in STD_LOGIC;
    aw_active_re : in STD_LOGIC;
    bid_gets_fifo_load_d1 : in STD_LOGIC;
    Data_Exists_DFF_2 : in STD_LOGIC;
    s_axi_bready : in STD_LOGIC;
    s_axi_wlast : in STD_LOGIC;
    \GEN_WDATA_SM_NO_ECC_SNG_REG_WREADY.clr_bram_we_reg\ : in STD_LOGIC;
    s_axi_wvalid : in STD_LOGIC;
    \GEN_WDATA_SM_NO_ECC_SNG_REG_WREADY.clr_bram_we_reg_0\ : in STD_LOGIC;
    axi_wdata_full_reg : in STD_LOGIC;
    axi_wr_burst : in STD_LOGIC
  );
  attribute ORIG_REF_NAME : string;
  attribute ORIG_REF_NAME of design_1_axi_bram_ctrl_0_1_SRL_FIFO : entity is "SRL_FIFO";
end design_1_axi_bram_ctrl_0_1_SRL_FIFO;

architecture STRUCTURE of design_1_axi_bram_ctrl_0_1_SRL_FIFO is
  signal \Addr_Counters[0].FDRE_I_n_0\ : STD_LOGIC;
  signal \Addr_Counters[0].MUXCY_L_I_i_3_n_0\ : STD_LOGIC;
  signal \Addr_Counters[1].FDRE_I_n_0\ : STD_LOGIC;
  signal \Addr_Counters[2].FDRE_I_n_0\ : STD_LOGIC;
  signal \Addr_Counters[3].FDRE_I_n_0\ : STD_LOGIC;
  signal \Addr_Counters[3].XORCY_I_i_1_n_0\ : STD_LOGIC;
  signal CI : STD_LOGIC;
  signal D_0 : STD_LOGIC;
  signal Data_Exists_DFF_i_2_n_0 : STD_LOGIC;
  signal Data_Exists_DFF_i_3_n_0 : STD_LOGIC;
  signal S : STD_LOGIC;
  signal S0_out : STD_LOGIC;
  signal S1_out : STD_LOGIC;
  signal addr_cy_1 : STD_LOGIC;
  signal addr_cy_2 : STD_LOGIC;
  signal addr_cy_3 : STD_LOGIC;
  signal \axi_bid_int[3]_i_3_n_0\ : STD_LOGIC;
  signal \axi_bid_int[3]_i_5_n_0\ : STD_LOGIC;
  signal \axi_bid_int[3]_i_6_n_0\ : STD_LOGIC;
  signal bid_fifo_not_empty : STD_LOGIC;
  signal bid_fifo_rd : STD_LOGIC_VECTOR ( 3 downto 0 );
  signal \^bid_gets_fifo_load\ : STD_LOGIC;
  signal \^bvalid_cnt_inc\ : STD_LOGIC;
  signal sum_A_0 : STD_LOGIC;
  signal sum_A_1 : STD_LOGIC;
  signal sum_A_2 : STD_LOGIC;
  signal sum_A_3 : STD_LOGIC;
  signal \NLW_Addr_Counters[0].MUXCY_L_I_CARRY4_CO_UNCONNECTED\ : STD_LOGIC_VECTOR ( 3 to 3 );
  signal \NLW_Addr_Counters[0].MUXCY_L_I_CARRY4_DI_UNCONNECTED\ : STD_LOGIC_VECTOR ( 3 to 3 );
  attribute BOX_TYPE : string;
  attribute BOX_TYPE of \Addr_Counters[0].FDRE_I\ : label is "PRIMITIVE";
  attribute BOX_TYPE of \Addr_Counters[0].MUXCY_L_I_CARRY4\ : label is "PRIMITIVE";
  attribute OPT_MODIFIED : string;
  attribute OPT_MODIFIED of \Addr_Counters[0].MUXCY_L_I_CARRY4\ : label is "MLO";
  attribute XILINX_LEGACY_PRIM : string;
  attribute XILINX_LEGACY_PRIM of \Addr_Counters[0].MUXCY_L_I_CARRY4\ : label is "(MUXCY,XORCY)";
  attribute XILINX_TRANSFORM_PINMAP : string;
  attribute XILINX_TRANSFORM_PINMAP of \Addr_Counters[0].MUXCY_L_I_CARRY4\ : label is "LO:O";
  attribute BOX_TYPE of \Addr_Counters[1].FDRE_I\ : label is "PRIMITIVE";
  attribute BOX_TYPE of \Addr_Counters[2].FDRE_I\ : label is "PRIMITIVE";
  attribute BOX_TYPE of \Addr_Counters[3].FDRE_I\ : label is "PRIMITIVE";
  attribute BOX_TYPE of Data_Exists_DFF : label is "PRIMITIVE";
  attribute XILINX_LEGACY_PRIM of Data_Exists_DFF : label is "FDR";
  attribute BOX_TYPE of \FIFO_RAM[0].SRL16E_I\ : label is "PRIMITIVE";
  attribute srl_bus_name : string;
  attribute srl_bus_name of \FIFO_RAM[0].SRL16E_I\ : label is "U0/\gext_inst.abcv4_0_ext_inst/GEN_AXI4.I_FULL_AXI/I_WR_CHNL/BID_FIFO/FIFO_RAM ";
  attribute srl_name : string;
  attribute srl_name of \FIFO_RAM[0].SRL16E_I\ : label is "U0/\gext_inst.abcv4_0_ext_inst/GEN_AXI4.I_FULL_AXI/I_WR_CHNL/BID_FIFO/FIFO_RAM[0].SRL16E_I ";
  attribute BOX_TYPE of \FIFO_RAM[1].SRL16E_I\ : label is "PRIMITIVE";
  attribute srl_bus_name of \FIFO_RAM[1].SRL16E_I\ : label is "U0/\gext_inst.abcv4_0_ext_inst/GEN_AXI4.I_FULL_AXI/I_WR_CHNL/BID_FIFO/FIFO_RAM ";
  attribute srl_name of \FIFO_RAM[1].SRL16E_I\ : label is "U0/\gext_inst.abcv4_0_ext_inst/GEN_AXI4.I_FULL_AXI/I_WR_CHNL/BID_FIFO/FIFO_RAM[1].SRL16E_I ";
  attribute BOX_TYPE of \FIFO_RAM[2].SRL16E_I\ : label is "PRIMITIVE";
  attribute srl_bus_name of \FIFO_RAM[2].SRL16E_I\ : label is "U0/\gext_inst.abcv4_0_ext_inst/GEN_AXI4.I_FULL_AXI/I_WR_CHNL/BID_FIFO/FIFO_RAM ";
  attribute srl_name of \FIFO_RAM[2].SRL16E_I\ : label is "U0/\gext_inst.abcv4_0_ext_inst/GEN_AXI4.I_FULL_AXI/I_WR_CHNL/BID_FIFO/FIFO_RAM[2].SRL16E_I ";
  attribute BOX_TYPE of \FIFO_RAM[3].SRL16E_I\ : label is "PRIMITIVE";
  attribute srl_bus_name of \FIFO_RAM[3].SRL16E_I\ : label is "U0/\gext_inst.abcv4_0_ext_inst/GEN_AXI4.I_FULL_AXI/I_WR_CHNL/BID_FIFO/FIFO_RAM ";
  attribute srl_name of \FIFO_RAM[3].SRL16E_I\ : label is "U0/\gext_inst.abcv4_0_ext_inst/GEN_AXI4.I_FULL_AXI/I_WR_CHNL/BID_FIFO/FIFO_RAM[3].SRL16E_I ";
  attribute SOFT_HLUTNM : string;
  attribute SOFT_HLUTNM of \axi_bid_int[0]_i_1\ : label is "soft_lutpair37";
  attribute SOFT_HLUTNM of \axi_bid_int[1]_i_1\ : label is "soft_lutpair37";
  attribute SOFT_HLUTNM of \axi_bid_int[2]_i_1\ : label is "soft_lutpair36";
  attribute SOFT_HLUTNM of \axi_bid_int[3]_i_2\ : label is "soft_lutpair36";
begin
  bid_gets_fifo_load <= \^bid_gets_fifo_load\;
  bvalid_cnt_inc <= \^bvalid_cnt_inc\;
\Addr_Counters[0].FDRE_I\: unisim.vcomponents.FDRE
    generic map(
      INIT => '0',
      IS_C_INVERTED => '0',
      IS_D_INVERTED => '0',
      IS_R_INVERTED => '0'
    )
        port map (
      C => s_axi_aclk,
      CE => bid_fifo_not_empty,
      D => sum_A_3,
      Q => \Addr_Counters[0].FDRE_I_n_0\,
      R => Data_Exists_DFF_0
    );
\Addr_Counters[0].MUXCY_L_I_CARRY4\: unisim.vcomponents.CARRY4
     port map (
      CI => '0',
      CO(3) => \NLW_Addr_Counters[0].MUXCY_L_I_CARRY4_CO_UNCONNECTED\(3),
      CO(2) => addr_cy_1,
      CO(1) => addr_cy_2,
      CO(0) => addr_cy_3,
      CYINIT => CI,
      DI(3) => \NLW_Addr_Counters[0].MUXCY_L_I_CARRY4_DI_UNCONNECTED\(3),
      DI(2) => \Addr_Counters[2].FDRE_I_n_0\,
      DI(1) => \Addr_Counters[1].FDRE_I_n_0\,
      DI(0) => \Addr_Counters[0].FDRE_I_n_0\,
      O(3) => sum_A_0,
      O(2) => sum_A_1,
      O(1) => sum_A_2,
      O(0) => sum_A_3,
      S(3) => \Addr_Counters[3].XORCY_I_i_1_n_0\,
      S(2) => S0_out,
      S(1) => S1_out,
      S(0) => S
    );
\Addr_Counters[0].MUXCY_L_I_i_1\: unisim.vcomponents.LUT6
    generic map(
      INIT => X"0000FFFFFFFE0000"
    )
        port map (
      I0 => \Addr_Counters[3].FDRE_I_n_0\,
      I1 => \Addr_Counters[2].FDRE_I_n_0\,
      I2 => \Addr_Counters[1].FDRE_I_n_0\,
      I3 => aw_active_re,
      I4 => \axi_bid_int[3]_i_3_n_0\,
      I5 => \Addr_Counters[0].FDRE_I_n_0\,
      O => S
    );
\Addr_Counters[0].MUXCY_L_I_i_2\: unisim.vcomponents.LUT6
    generic map(
      INIT => X"2AAAAAAAAAAAAAAA"
    )
        port map (
      I0 => aw_active_re,
      I1 => \Addr_Counters[1].FDRE_I_n_0\,
      I2 => \Addr_Counters[0].FDRE_I_n_0\,
      I3 => \Addr_Counters[3].FDRE_I_n_0\,
      I4 => \Addr_Counters[2].FDRE_I_n_0\,
      I5 => \Addr_Counters[0].MUXCY_L_I_i_3_n_0\,
      O => CI
    );
\Addr_Counters[0].MUXCY_L_I_i_3\: unisim.vcomponents.LUT6
    generic map(
      INIT => X"7577777755575757"
    )
        port map (
      I0 => bid_fifo_not_empty,
      I1 => bid_gets_fifo_load_d1,
      I2 => \axi_bid_int[3]_i_6_n_0\,
      I3 => Data_Exists_DFF_2,
      I4 => s_axi_bready,
      I5 => \axi_bid_int[3]_i_5_n_0\,
      O => \Addr_Counters[0].MUXCY_L_I_i_3_n_0\
    );
\Addr_Counters[1].FDRE_I\: unisim.vcomponents.FDRE
    generic map(
      INIT => '0',
      IS_C_INVERTED => '0',
      IS_D_INVERTED => '0',
      IS_R_INVERTED => '0'
    )
        port map (
      C => s_axi_aclk,
      CE => bid_fifo_not_empty,
      D => sum_A_2,
      Q => \Addr_Counters[1].FDRE_I_n_0\,
      R => Data_Exists_DFF_0
    );
\Addr_Counters[1].MUXCY_L_I_i_1\: unisim.vcomponents.LUT6
    generic map(
      INIT => X"0000FFFFFFFE0000"
    )
        port map (
      I0 => \Addr_Counters[3].FDRE_I_n_0\,
      I1 => \Addr_Counters[0].FDRE_I_n_0\,
      I2 => \Addr_Counters[2].FDRE_I_n_0\,
      I3 => aw_active_re,
      I4 => \axi_bid_int[3]_i_3_n_0\,
      I5 => \Addr_Counters[1].FDRE_I_n_0\,
      O => S1_out
    );
\Addr_Counters[2].FDRE_I\: unisim.vcomponents.FDRE
    generic map(
      INIT => '0',
      IS_C_INVERTED => '0',
      IS_D_INVERTED => '0',
      IS_R_INVERTED => '0'
    )
        port map (
      C => s_axi_aclk,
      CE => bid_fifo_not_empty,
      D => sum_A_1,
      Q => \Addr_Counters[2].FDRE_I_n_0\,
      R => Data_Exists_DFF_0
    );
\Addr_Counters[2].MUXCY_L_I_i_1\: unisim.vcomponents.LUT6
    generic map(
      INIT => X"0000FFFFFFFE0000"
    )
        port map (
      I0 => \Addr_Counters[3].FDRE_I_n_0\,
      I1 => \Addr_Counters[0].FDRE_I_n_0\,
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
