phoenix-pnp/ThunderScope/(commit log)

2021-03-25 GetData Max Number Points Limit Set
    added logic to the postProcessor loop so that it will never send more than a maximum number of points using get data. Current limit is 4096
2021-05-07 BRAM Testing. Working, but unstable
    [PCIe.cpp, adc_to_bram.v, clk_wiz_0_sim_netlist.v, clk_wiz_0_sim_netlist.vhdl, clk_wiz_0_stub.v, clk_wiz_0_stub.vhdl, design_1.v]
2021-05-08 Changed BRAM latency to 1, fixed spikes in output
    [design_1.v, design_1_axi_bram_ctrl_0_1.vhd, design_1_axi_bram_ctrl_0_1_sc.cpp, design_1_axi_bram_ctrl_0_1_sim_netlist.v, design_1_axi_bram_ctrl_0_1_sim_netlist.vhdl, design_1_axi_bram_ctrl_0_1_stub.v, design_1_axi_bram_ctrl_0_1_stub.vhdl, design_1_blk_mem_gen_0_2.v]
2021-05-08 Set pcie read thread priority to time critical & removed datawidth converter hack
2021-05-08 Set thread priority (didn't stage this last time)
    [PCIe.cpp]
2021-05-09 Stable, but chunks lost on windows interrupting
2021-11-26 Added tcp server functions
    Currently doesnt run them, just compiles
2022-03-16 ThunderScope Rev.1 WIP
    [ADC.SchDoc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]
2022-04-14 All nets routed but GND
    [ADC.SchDoc, CON_PCIe_X4.SchDoc, FE.SchDoc, FE_Channel.SchDoc, FPGA.SchDoc, M2_KEY_M.SchDoc, Main.SchDoc, PLL.SchDoc]
